Antonio-Tirri/Aspirnove/Display BW S-0241-02/Display Sorgenti Software BW S-0241-02 FW00054_012/FW00054_012/doc/info_display.docx

% H2O

% Umidità Stato sterilizzatore (ON/OFF)

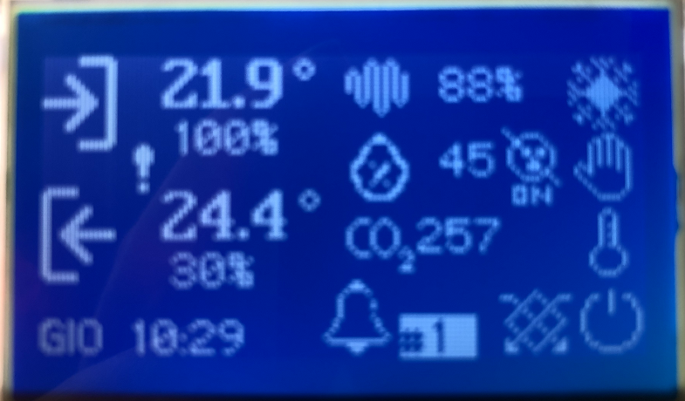
[picture p1: figure]

Temperatura EXT Stagione

% Comando FAN1

! se sensori tacho non rilevati Modalità (AUTO/MAN/PROG)

Temperatura INT Stato termostato

% Comando FAN2

Giorno / Ora OFF sistema

(oppure messaggio allarme)

Numero scheda Stato Bypass

Icona allarme attivo Valore CO2

(ingresso sanificazione o filtro aria)
