Antonio-Tirri/Aspirnove/Aspirnova Scheda Motori S-283-00/S-0283-01-BOM-Var.002 11012021.xlsx

Progetto: |  |  | Scheda controllo
Codice scheda: |  |  | S-0283-01
Variante: |  |  | 002
Revisione: |  |  | 01
Data report: |  |  | 29/10/2020 | 11/01/2021
# | Riferimento | Valore | Descrizione | Costruttore | P/N Costruttore | Contenitore | Quantità | Note
~~1~~ | ~~BT1~~ | ~~CR-1220/HFN~~ | ~~Battery Lithium 3V coin 12.5 mm~~ | ~~Panasonic~~ | ~~CR-1220/HFN~~ | ~~PTH~~ | ~~1~~ | ~~A-1081-00~~
 | BT1 |  | PORTABATTERIA VERTICALE 2032 GR000250 |  |  |  |  | A-1341-00
 | BT1 |  | BATTERIA 3V 2032 |  |  |  |  | A-1218-00
4 | C1, C2, C7, C8, C23, C24 | 12pF 50V | MLCC Capacitor, 12pF 50V, ±10%, C0G, Case 0603 | AVX Corp. | 06035A120KAT2A | 0603 | 6 | RECD95026
5 | C3, C4, C9, C10 | 10nF 50V | MLCC Capacitor, 10nF 50V, ±10%, X7R, Case 0805 | AVX Corp. | 08055C103KAT2A | 0805 | 4 | RECD92009
6 | C5, C14 | 100nF 275Vac | Condensatore a Film Plastico, 100nF, X2 | Kemet | R46KF310050P0K | PTH | 2 | A-1135-00
7 | C6, C11, C15 | 100nF 50V | MLCC Capacitor, 100nF 50V, ±10%, X7R, Case 0805 | AVX Corp. | 08055C104KAT2A | 0805 | 3 | RECD92013
8 | C12, C13 | 470uF 35V | SMD Aluminum Electrolytic Capacitor, 470uF 35V, 8mm x 10.2mm | Panasonic Electronic Components | EEEFK1V471SP | SMD 10mm x 10.2mm | 2 | a-0779-00
9 | C16, C32 | 1uF 50V | MLCC Capacitor, 1uF 50V, ±10%, X7R, Case 0805 | Murata | GRM21BR71H105K | 0805 | 2 | RECD92021
10 | C17, C30 | 1uF 50V | MLCC Capacitor, 1uF 50V, ±10%, X5R, Case 0603 | Samsung | CL10A105KB8NNNC | 0603 | 2 | RECD95033
11 | C18, C19 | 1nF 50V | MLCC Capacitor, 1nF 50V, ±10%, C0G, Case 0603 | Avx | 06035C102KAT2A | 0603 | 2 | RECD95011
12 | C20, C21, C22, C25, C26, C27, C35, C40, C50, C51 | 100nF 50V | MLCC Capacitor, 100nF 50V, ±10%, X7R, Case 0603 | Avx | 06035C104KAT2A | 0603 | 10 | RECD95018
13 | C28 | 4.7uF 16V | MLCC Capacitor, 4.7uF 16V, ±10%, X7R, Case 0805 | Avx | 0805YC475KAT2A | 0805 | 1 | RECD92023
14 | C29, C42 | 10nF 50V | MLCC Capacitor, 10nF 50V, ±10%, X7R, Case 0603 | Avx | 06035C103KAT2A | 0603 | 2 | RECD95012
15 | C33, C41 | 10uF 25V | MLCC Capacitor, 10uF 25V, ±10%, X7R, Case 1206 | Avx | 12063C106KAT2A | 1206 | 2 | RECD93014
16 | C34 | 150pF 50V | MLCC Capacitor, 150pF 50V, ±10%, C0G, Case 0603 | Avx | 06035A151JAT2A | 0603 | 1 | RECD95009
17 | C36, C38, C45, C47, C53, C60, C64, C68, C72, C77, C78, C79, C80, C81, C82 | 10nF 50V | MLCC Capacitor, 10nF 50V, ±10%, X7R, Case 0603 | Avx | 06035C103KAT2A | 0603 | 15 | RECD95012
18 | C37, C44, C46, C52, C54, C55, C58, C59, C62, C63, C66, C67, C70, C71 | 1uF 50V | MLCC Capacitor, 1uF 50V, ±10%, X5R, Case 0603 | Samsung | CL10A105KB8NNNC | 0603 | 14 | RECD95033
19 | C39 | 100uF TANT 20V | Solid Tantalum Chip Capacitor, 100uF, 20V, TC7343 | Avx | TAJD107K020RNJ | TC7343 | 1 | RECD82016
20 | C43 | 100pF 50V | MLCC Capacitor, 100pF 50V, ±10%, C0G, Case 0603 | Samsung | CL10C101JB8NNNC | 0603 | 1 | RECD95008
21 | C48, C49 | 2.2uF 25V | MLCC Capacitor, 2.2uF 25V, ±10%, X5R, Case 0603 | Samsung | CL10A225KA8NNNC | 0603 | 2 | RECD95023
22 | C56, C73, C74, C75, C76 | 100nF 50V | MLCC Capacitor, 100nF 50V, ±10%, X7R, Case 0603 | Avx | 06035C104KAT2A | 0603 | 5 | RECD95018
23 | C57, C61, C65, C69 | 100pF 50V | MLCC Capacitor, 100pF 50V, ±10%, C0G, Case 0603 | Samsung | CL10C101JB8NNNC | 0603 | 4 | RECD95008
24 | D1 | DF04S | Rectifier Bridge, 400V, 1A, SMD, 1V, SOIC | Vishay | DF04S | SMD | 1 | REDD90010
25 | D3, D5, D6, D7, D8 | BAV199 | Two Small Signal Diodes, 75V, SOT-23 | Infineon | BAV199E6327 | SOT-23 | 5 | REDD92019
26 | D4 | STPS340U | Power Schottky Rectifier, 40V, 3A | Stmicroelectronics | STPS340U | SMB | 1 | REDD96005
27 | D9, D10, D11, D12, D13, D14, D15, D17, D18 | 1N4148 | Small Signal Diode, 100V, 150mA, SOD-123 | Diodes Inc. | 1N4148W-7-F | SOD123 | 9 | REDD91035
28 | D16 | S2M | Rectifier Diode, 1KV, 1.5A, SMB | DC Components | S2M | SMB | 1 | REDD91002
29 | DL1, DL5, DL6, DL7, DL8, DL9, DL10, DL12, DL13, DL14 | LED ROSSO | Red SMD LED | Kingbright | KP-2012SRC-J4 | 0805 | 10 | REDD94009
30 | DL2, DL3, DL4 | LED VERDE | Green SMD LED | Kingbright | KP-2012SGC | 0805 | 3 | REDD94007
31 | F1 | 5x20 | 5x20 Fuse Holder | ECC | PTF/78 | PTH | 1 | A-0396-00
 |  |  |  |  |  |  | 1 | A-0396-00cc
 |  |  | 400ma 5x20 |  |  |  | 1 | A-0146-00
34 | F2, F3 | 72V, 0.20A | PTC Resettable Fuse, 72V, 0.20A | Little Fuse Inc. | 72R020X | Radial, 7.4mm | 2 | A-1138-00
35 | F4,F5 | 5x20 | 5x20 Fuse Holder vertical | SHURTER | FPG4 | PTH | 2 | A-1136-00
 |  |  | 10 5Ax20 |  |  |  | 1 | A1137-00
37 | J4 | STRIP2.54-1X5-H11.6-M | 5-Way Pin Strip, Single Row, 2.54mm pitch, Male | Adimpex | LE022005-R | PTH | 1 | A-1133-00
 | J8 |  | PONTE FILO RIGIDO PIN 2 – 3 |  |  |  | 1 | A-0152-00
39 | J5 | 651005136421 | Mini-USB connector, Type B , Vertical, PTH | Wurth | 651005136421 | PTH | 1 | A-1139-00
40 | JP1 | JMP2 | 2-way Jumper | Adimpex | LE008002-R | PTH | 1 | A-1140-00
41 | K1, K2, K3, K5, K6 | HF115FK/12-Z3T | Single-Pole Dual-Throw Relay, 12VDC, 16A, 250V | Hong Fa | HF115FK/12-Z3T | PTH | 5 | A-0248-00
42 | L2 | HZ0805C202R-10 | Ferrite chip beads Z=2k | Laird Technologies | HZ0805C202R-10 | 0805 | 1 | REIN93028
43 | L4 | 15uH | Power Inductor for Switching Regulator, 2.5A | Epcos | B82464A4153K | SMD 10x10mm | 1 | REIN95002
44 | P2, P3, P10, P11 | CUM5/3 | Stelvio Male PCB Header, 3ways, 5mm pitch | Stelvio | CUM5/3 | PTH | 4 | A-0667-00
 |  |  |  |  |  |  | 4 | A-0666-00
46 | P4, P5, P6, P7, P8, P9, P12, P13, P14, P16 | CUM5/4 | Stelvio Male PCB Header, 4ways, 5mm pitch | Stelvio | CUM5/4 |  | 10 | A-0049-00
 |  |  |  |  |  |  | 10 | A-0048-00
48 | Q1, Q2, Q3, Q5, Q6 | PDTC143ET,215 | NPN Biased transistor, R=4.7K | Nxp | PDTC143ET,215 | SOT-23 | 5 | RETR92026
49 | R1, R3, R4, R27 | 330 1% | SMD Resistor, 330 Ohm, Tolerance 1%, Case 0603 | Yageo | RC0603FR-07330RL | 0603 | 4 | RERS95511
50 | R5 | 1K 0.5W | Resistenza 1K Ohm, 5%, 0.5W, Assiale |  |  | PTH | 1 | A-1141-00
51 | R6 | 470 1% | SMD Resistor, 470 Ohm, Tolerance 1%, Case 0805 | Vishay | CRCW0805470RFKTABC | 0805 | 1 | RERS93116
52 | R7, R16, R25, R69, R88, ~~R89,~~ R81 | 0 | SMD Resistor, 0R, Case 0603 | Vishay | CRCW06030000Z0TABC | 0603 | 6 | RERS95000
53 | R8 | 4.7 1% | SMD Resistor, 4.7 Ohm, Tolerance 1%, Case 0805 | Vishay | CRCW08054R70FKTABC | 0805 | 1 | RERS93110
54 | R9, R11, R13, R58, R59, R64, R65, R75 | 10K 1% | SMD Resistor, 10K, Tolerance 1%, Case 0603 | Vishay | CRCW060310K0FKTABC | 0603 | 8 | RERS95570
55 | R10, R12, R14 | 3.9K 1% | SMD Resistor, 3.9K, Tolerance 1%, Case 0603 | Vishay | CRCW06033K90FKTABC | 0603 | 3 | RERS95532
56 | R15 | 120 1% | SMD Resistor, 120 Ohm, Tolerance 1%, Case 1206 | Vishay | CRCW1206120RFKTABC | 1206 | 1 | RERS91057
57 | R17, R20 | 4.7 1% | SMD Resistor, 4.7 Ohm, Tolerance 1%, Case 0805 | Vishay | CRCW080544R70FKTABC | 0805 | 2 | RERS93110
58 | R18, R21 | 4.7K 1% | SMD Resistor, 4.7K, Tolerance 1%, Case 0805 | Vishay | CRCW08054K70FKTABC | 0805 | 2 | RERS93033
59 | R19, R22, R71 | 1K 1% | SMD Resistor, 1K, Tolerance 1%, Case 0603 | Vishay | CRCW06031K00FKTABC | 0603 | 3 | RERS95550
60 | R23, R39, R41 | 10K 1% | SMD Resistor, 10K, Tolerance 1%, Case 0603 | Vishay | CRCW060310K0FKTABC | 0603 | 3 | RERS95570
61 | R24, R51 | 10 1% | SMD Resistor, 10Ohm, Tolerance 1%, Case 0603 | Vishay | CRCW060310R0FKTABC | 0603 | 2 | RERS95500
62 | R26 | 1M 1% | SMD Resistor, 1M, Tolerance 1%, Case 0805 | Vishay | CRCW08051M00FKTA | 0805 | 1 | RERS93050
63 | R28 | 220 1% | SMD Resistor, 220 Ohm, Tolerance 1%, Case 0603 | Vishay | CRCW0603220RFKTABC | 0603 | 1 | RERS95009
64 | R29, R37, R45, R50 | 12K 1% | SMD Resistor, 12K, Tolerance 1%, Case 0603 | Vishay | CRCW060312K0FKTABC | 0603 | 4 | RERS95572
65 | R30, R38, R46, R52 | 27K 1% | SMD Resistor, 27K, Tolerance 1%, Case 0603 | Vishay | CRCW060327K0FKTABC | 0603 | 4 | RERS95580
66 | R34, R35, R36, R42, R43, R44, R47, R48, R49, R53, R54, R55, R66, R67, R68, R70, R87 | 4.7K 1% | SMD Resistor, 4.7K, Tolerance 1%, Case 0603 | Vishay | CRCW06034K70FKTABC | 0603 | 17 | RERS95560
67 | R40 | 1.1K 1% | SMD Resistor, 1.1K, Tolerance 1%, Case 0603 | Vishay | CRCW06031K10FKTABC | 0603 | 1 | RERS95611
68 | R56, R57, R85, R86 | 560 1% | SMD Resistor, 560 Ohm, Tolerance 1%, Case 0603 | Vishay | CRCW0603560RFKTA | 0603 | 4 | RERS95612
69 | R72, R73 | 1K 1% | SMD Resistor, 1K, Tolerance 1%, Case 0603 | Vishay | CRCW06031K00FKTABC | 0603 | 2 | RERS95550
70 | R77, R78 | 1.5K 1% | SMD Resistor, 1.5K, Tolerance 1%, Case 0805 | Vishay | CRCW08051K50FKTABC | 0805 | 2 | RERS93108
71 | R82 | 0 | SMD Resistor, 0R, Case 1206 | Vishay | CRCW12060000Z0TABC | 1206 | 1 | RERS91000
72 | R83, R84, R93, R94, R95, R99 | 47K 1% | SMD Resistor, 47K, Tolerance 1%, Case 0603 | Vishay | CRCW060347K0FKTABC | 0603 | 6 | RERS95590
73 | R90, R91, R96, R97 | 100 1% | SMD Resistor, 100 Ohm, Tolerance 1%, Case 0603 | Vishay | CRCW0603100RFKTABC | 0603 | 4 | RERS95510
74 | SW1 | GDH08S04 | Dip-Switch, SMD, 8 way p1.27 | TE Connectivity | GDH08S04 | SMD | 1 | REDS20009
75 | SW2 | GDH02S04 | DIP Switch, 2 Position, SPST, 1.27mm pitch | TE Connectivity | GDH02S04 | SMD | 1 | REDS20002
76 | TR1 | 15V 6VA | Voltage Transformer | HAHN | TBD |  | 1 | A-1331-00 | myrra 44268
77 | TVS1, TVS2, TVS3, TVS4, TVS5, TVS6, TVS7, TVS8, TVS9, TVS12, TVS13, TVS14, TVS15, TVS16, TVS17 | PTVS13VP1UTP | 600W Unidirectional Transient Voltage Suppressor (TVS), SOD128, 13V | NXP | PTVS13VP1UTP | SOD128 | 15 | REDD91042
78 | TVS10 | CDSOT23-SM712 | Dual 7V/12V Transient Voltage Suppressor | Bourns | CDSOT23-SM712 | SOT23 | 1 | REDD90022
79 | TVS11 | SM6T30CA | Bidirectional Transil, 600W, 27V, SMB | ST Microelectronics | SM6T30CA | SMB | 1 | REDD91062
80 | U2 | LM1117IDTX-ADJ/NOPB | 800mA Low-Dropout Linear Regulator | Texas Instruments | LM1117IDTX-ADJ/NOPB | DPAK | 1 | REIC99171
81 | U3 | TS922ID | Dual Op Amp, Low offset | STMicroelectronics | TS922ID | SOIC-8 | 1 | REIC99201
82 | U4 | LM224DTBR2G | Quad Rail-to-Rail Op Amp | Texas Instruments | LM224DTBR2G | TSSOP14 | 1 | REIC92101
83 | U5, U7, U8, U10 | 10 1% | SMD Resistor, 10 Ohm, Tolerance 1%, Case 0805 | Vishay | CRCW080510R0FKTABC | 0805 | 4 | RERS93000
84 | U6 | USBLC6-2SC6 | ESD Protection Array, USB2.0 | Stmicroelectronics | USBLC6-2SC6 | SOT23-6 | 1 | REDD92023
85 | U9 | L5973D013TR | Step down switching regulator, 2.5A | ST Microelectronics | L5973AD | HSOP8 | 1 | REIC92102
86 | U11 | STM32F205RCT6 | ARM Cortex M3 , 256K Flash 96K Ram, LQFP 64pin | ST Microelectronics | STM32F205RCT6 | LQFP64 | 1 | REIC99172
87 | U14 | SN65HVD75D | Low Power RS485 Transceiver, Half Duplex, 3-3,6V, 20Mbps | Texas Instruments | SN65HVD75D | SOIC8 | 1 | REIC93185
88 | VR1, VR2, VR3 | S14K275E | Varistor, 275Vac, 14mm | Epcos | S14K275E | PTH | 3 | A-0096-00
89 | Y1 | 12MHz | SMD Quartz Crystal 12MHz, 50ppm | Abracon | ABLS-12.000MHZ-B4-T | HC49 | 1 | REQZ93023
90 | Y2 | 32.768kHz | Quartz, 32.768kHz | Abracon Corporation | AB38T-32.768KHZ | TC-26 | 1 | A-1143-00
Totale |  |  |  |  |  |  | 284
