Antonio-Tirri/Aspirnove/Display BW S-0241-02/DIBA/S-0241-02_BOM.xlsx

Progetto: |  |  | Scheda Display
Codice scheda: |  |  | S-0241-02
Variante: |  |  | 002
Revisione: |  |  | 02
Data report: |  |  | 13/11/2020 | Agg.: | 10/11/2021 | 15/12/2021
# | Riferimento | Valore | Descrizione | Costruttore | P/N Costruttore | Contenitore | Quantità | Note
# | Designator | Value | Description | Manufacturer | Manufacturer Part Number | Package | Quantity | AssemblyNotes
1 |  |  |  |  |  |  | 1 | ELC-0241-05
2 | BZ1 | LPT1230S-HL-03-4.0-1 | Piezo Buzzer | Cre-sound | LPT1230S-HL-03-4.0-1 | SMD | 1 | REBZ90003
3 | C1, C2, C41 | 10uF 25V | MLCC Capacitor, 10uF 25V, ±10%, X7R, Case 1206 | Avx | 12063C106KAT2A | 1206 | 3 | RECD93014
4 | C3, C4 | 47uF 25V | SMD Aluminum Electrolytic Capacitor, 47uF 25V, 6.3mm x 5.8mm | Panasonic | EEEFK1E470P | SMD 6.3mm x 5.8mm | 2 | RECD81000
5 | C5, C9, C11, C13, C15, C16, C30, C31, C32, C33 C20, C21, C22, C25, C26, C27, C40, C50, C51 | 100nF 50V | Multilayer Ceramic Capacitor | Panasonic / TDK / Kemet | ECJ1VB1H104 | 0603 | 19 | RECD95018
6 | C6, C10, C12, C14, C29 C17_1, C17_2 | 1uF 50V | Multilayer Ceramic Chip Capacitor, 1uF 50V, 0603, X7R, 10% | Panasonic / TDK / Kemet | CGA3E2X7R1H102K080AD | 0603 | 7 | RECD95033
7 | C7, C8, C23, C24 | 12pF 50V | MLCC Capacitor, 12pF 50V, ±10%, C0G, Case 0603 | AVX Corp. | 06035A120KAT2A | 0603 | 4 | RECD95026
8 | C18_1, C18_2, C19_1, C19_2 | 1nF 50V | MLCC Capacitor, 1nF 50V, ±10%, C0G, Case 0603 | Avx | 06035C102KAT2A | 0603 | 4 | RECD95011
9 | C28 | 4.7uF 16V | MLCC Capacitor, 4.7uF 16V, ±10%, X7R, Case 0805 | Avx | 0805YC475KAT2A | 0805 | 1 | RECD92028
10 | C48, C49 | 2.2uF 25V | MLCC Capacitor, 2.2uF 25V, ±10%, X5R, Case 0603 | Samsung | CL10A225KA8NNNC | 0603 | 2 | RECD95023
11 | D1 | S2M | Rectifier Diode, 1KV, 1.5A, SMB | DC Components | S2M | SMB | 1 | REDD91002
12 | D3 | 1N4148 | Small Signal Diode, 100V, 150mA, SOD-123 | Diodes Inc. | 1N4148W-7-F | SOD123 | 1 | REDD91035
13 | DISP1 | G64128W20NBW00 | LCD Graphic Display, 128x64, Blue | CCT | G64128W20NBW00 | MECH | 1 | ELC-0241-05
14 | DL1 | BILED 3mm | BICOLOR LED 3mm common cathode | Kingbright | L-93WSURKCGKC | PTH | 1 | A-1132-00
15 | J1 |  | FFC/FPC Connector 29-way | Molex |  | SMD | 1 | RECN90024
16 | J4 | STRIP2.54-1X5-H11.6-M | 5-Way Pin Strip, Single Row, 2.54mm pitch, Male | Adimpex | LE022005-R | PTH | 1 | A-0559-00
17 | J5 | 65100516121 | Mini-USB connector, Type B , Vertical, PTH | Wurth | 65100516121 | SMD | 1 | RECN90017
18 | JP2 | 691221320006 | Morsettiera 6vie , passo 3.5mm, SMD | Wurth | 691221320006 | PTH | 1 | A-1308-00
19 | Q1, Q2 | BC817 | NPN Silicon Transistor, Small signals | NXP Semiconductors | BC817 | SOT-23 | 2 | RETR93010
20 | R1, R7, R16, R25, R31, R42, R43 | 0 | SMD Resistor, 0R, Case 0603 | Vishay | CRCW06030000Z0TABC | 0603 | 7 | RERS95000
21 | R18 | 1.5K 1% | SMD Resistor, 1.5K, Tolerance 1%, Case 0805 |  | CRCW08051K50FKTABC | 0805 | 1 | RERS93108
22 | R3 | 33 1% | SMD Resistor, 33 Ohm, Tolerance 1%, Case 1206 | Vishay | CRCW120633R0FKTA | 1206 | 1 | RERS91095
23 | R4, R5, R6, R8, R9, R75_1, R75_2, R10, R12,R23, R29 | 10K 1% | SMD Resistor, 10K, Tolerance 1%, Case 0603 | Vishay | CRCW060310K0FKTABC | 0603 | 12 | RERS95570
24 | R11, R27 | 22K 1% | SMD Resistor, 22K, Tolerance 1%, Case 0603 | Vishay | CRCW060322K0FKTABC | 0603 | 2 | RERS95576
25 | R13 | 470 1% | SMD Resistor, 470 Ohm, Tolerance 1%, Case 0805 | Vishay | CRCW0805470RFKTABC | 0805 | 1 | RERS93116
26 | R14 | 1.5K 1% | SMD Resistor, 1.5K, Tolerance 1%, Case 0805 | Vishay | CRCW08051K50FKTABC | 0805 | 1 | RERS93108
27 | R17_1, R17_2, R20_1, R20_2 | 4.7 1% | SMD Resistor, 4.7 Ohm, Tolerance 1%, Case 0805 | Vishay | CRCW080544R70FKTABC | 0805 | 4 | RERS93110
28 | R19, R21 | 100 1% | SMD Resistor, 100 Ohm, Tolerance 1%, Case 0603 | Vishay | CRCW0603100RFKTABC | 0603 | 2 | RERS95510
29 | R22 | 10 1% | SMD Resistor, 10 Ohm, Tolerance 1%, Case 0805 | Vishay | CRCW080510R0FKTABC | 0805 | 1 | RERS93000
30 | R24, R51 | 10 1% | SMD Resistor, 10Ohm, Tolerance 1%, Case 0603 | Vishay | CRCW060310R0FKTABC | 0603 | 2 | RERS95500
31 | R26 | 1M 1% | SMD Resistor, 1M, Tolerance 1%, Case 0805 | Vishay | CRCW08051M00FKTA | 0805 | 1 | RERS93050
32 | R36 | 1.8M 1% | RES. SMD 1,8M 0603 1% |  |  | 0603 | 1 | RERS95609
33 | R38 | 330K 1% | RES. SMD 330K 0603 1% |  |  | 0603 | 1 | RERS95610
34 | R28 | 220 1% | SMD Resistor, 220 Ohm, Tolerance 1%, Case 0603 | Vishay | CRCW0603220RFKTABC | 0603 | 1 | RERS95009
35 | R32, R33, R71_1, R71_2 ,R72_1, R72_2, R73_1, R73_2 | 1K 1% | SMD Resistor, 1K, Tolerance 1%, Case 0603 | Vishay | CRCW06031K00FKTABC | 0603 | 8 | RERS95550
36 | R39 | 2.2K 1% | SMD Resistor, 2.2K, Tolerance 1%, Case 1206 | Vishay | CRCW12062K20FKTABC | 1206 | 1 | RERS91112
37 | R40, R41 | 120 1% | SMD Resistor, 120 Ohm, Tolerance 1%, Case 1206 | Vishay | CRCW1206120RFKTABC | 1206 | 2 | RERS91057
38 | S1, S2, S3, S4, S5 | TVBM11 | Tactile switch, 3.5x6 | Bentex | TVBM11 | SMD | 5 | REPL92014
39 | SW2 | GDH02S04 | DIP Switch, 2 Position, SPST, 1.27mm pitch | TE Connectivity | GDH02S04 | SMD | 1 | REDS20002
40 | TVS1 | SM6T18CA | Bidirectional Transil, 600W, 18V, SMB | Stmicroelectronics | SM6T18CA | SMB | 1 | REDD91052
41 | TVS10_1, TVS10_2 | CDSOT23-SM712 | Dual 7V/12V Transient Voltage Suppressor | Bourns | CDSOT23-SM712 | SOT23 | 2 | REDD90022
42 | U1 U2 | LM1117IDTX-ADJ/NOPB | 800mA Low-Dropout Linear Regulator | Texas Instruments | LM1117IDTX-ADJ/NOPB | DPAK | 2 | REIC99171
44 | U6 | USBLC6-2SC6 | ESD Protection Array, USB2.0 | Stmicroelectronics | USBLC6-2SC6 | SOT23-6 | 1 | REDD92023
45 | U11 | STM32F205RCT6 | ARM Cortex M3 , 256K Flash 96K Ram, LQFP 64pin | ST Microelectronics | STM32F205RCT6 | LQFP64 | 1 | REIC99172
46 | U14_1, U14_2 | SN65HVD75D | Low Power RS485 Transceiver, Half Duplex, 3-3,6V, 20Mbps | Texas Instruments | SN65HVD75D | SOIC8 | 2 | REIC93185
47 | Y1 | 12MHz | SMD Quartz Crystal 12MHz, 50ppm | Abracon | ABLS-12.000MHZ-B4-T | HC49 | 1 | REQZ93023
 |  |  |  |  |  |  |  | ELSTAFFA
 |  |  |  |  |  |  |  | ELFRONTALE
 |  |  |  |  |  |  |  | ELVETRINO
 |  |  |  |  |  |  |  | ELFONDO
 |  |  |  |  |  |  |  | ELTASTIERA
 |  |  |  |  |  |  |  | ELDISPLAY64X128_29P
 |  |  |  |  |  |  |  | ELSCATOLA
