Antonio-Tirri/Aspirnove/Aspirnova Scheda Motori S-283-00/S-0283-01-SCH-Var.002.pdf

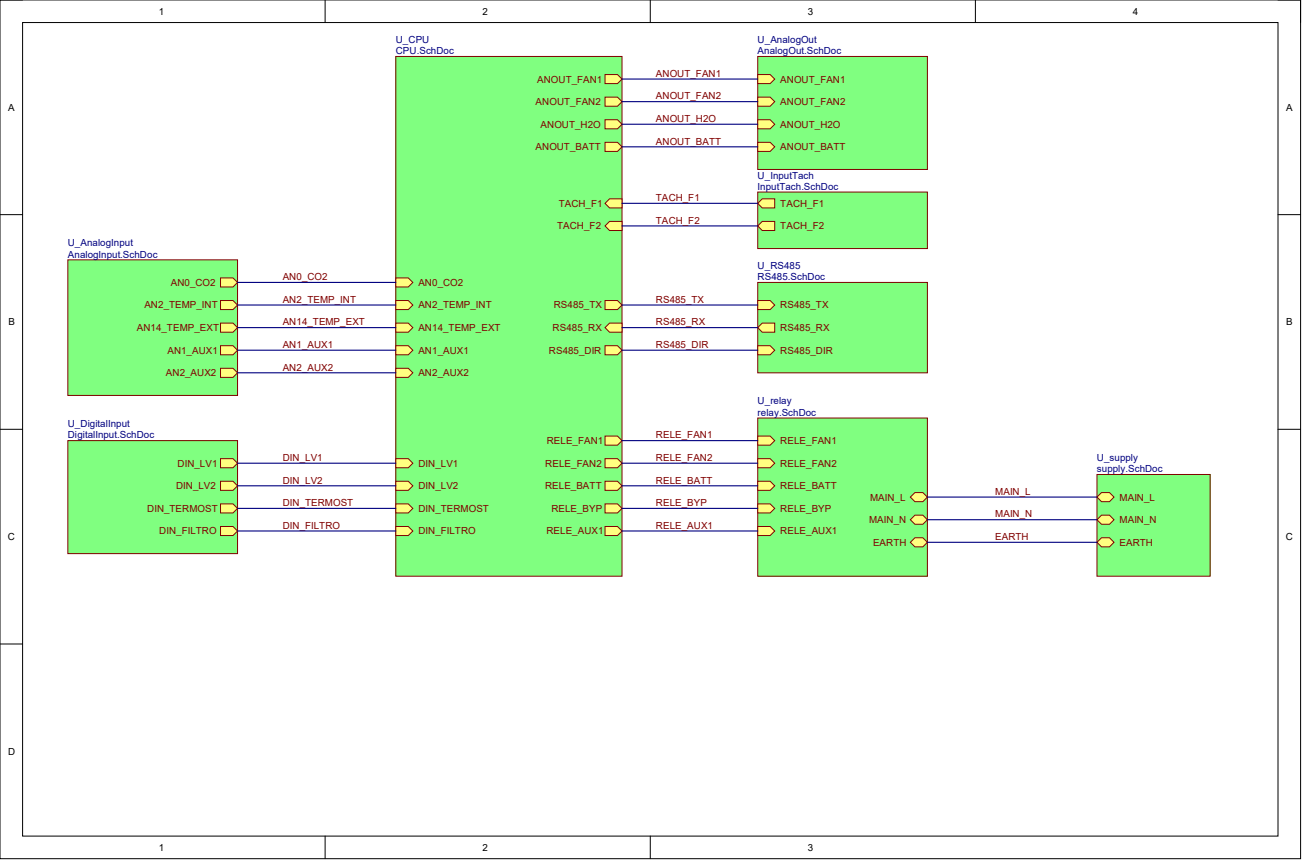
[picture p9: page 1]
MAIN_L; MAIN_N; EARTH; U_supply supply.SchDoc; ANOUT_FAN2; ANOUT_H2O; ANOUT_BATT; ANOUT_FAN1; U_AnalogOut AnalogOut.SchDoc; AN2_TEMP_INT; AN14_TEMP_EXT; DIN_TERMOST; DIN_FILTRO; RS485_DIR; RELE_BYP; RELE_BATT; RELE_FAN2; RELE_FAN1; AN1_AUX1; AN2_AUX2; RELE_AUX1; TACH_F1; TACH_F2; DIN_LV1; DIN_LV2; U_CPU CPU.SchDoc; U_RS485 RS485.SchDoc AN0_CO2; U_AnalogInput AnalogInput.SchDoc; U_DigitalInput DigitalInput.SchDoc; U_relay relay.SchDoc; U_InputTach InputTach.SchDoc

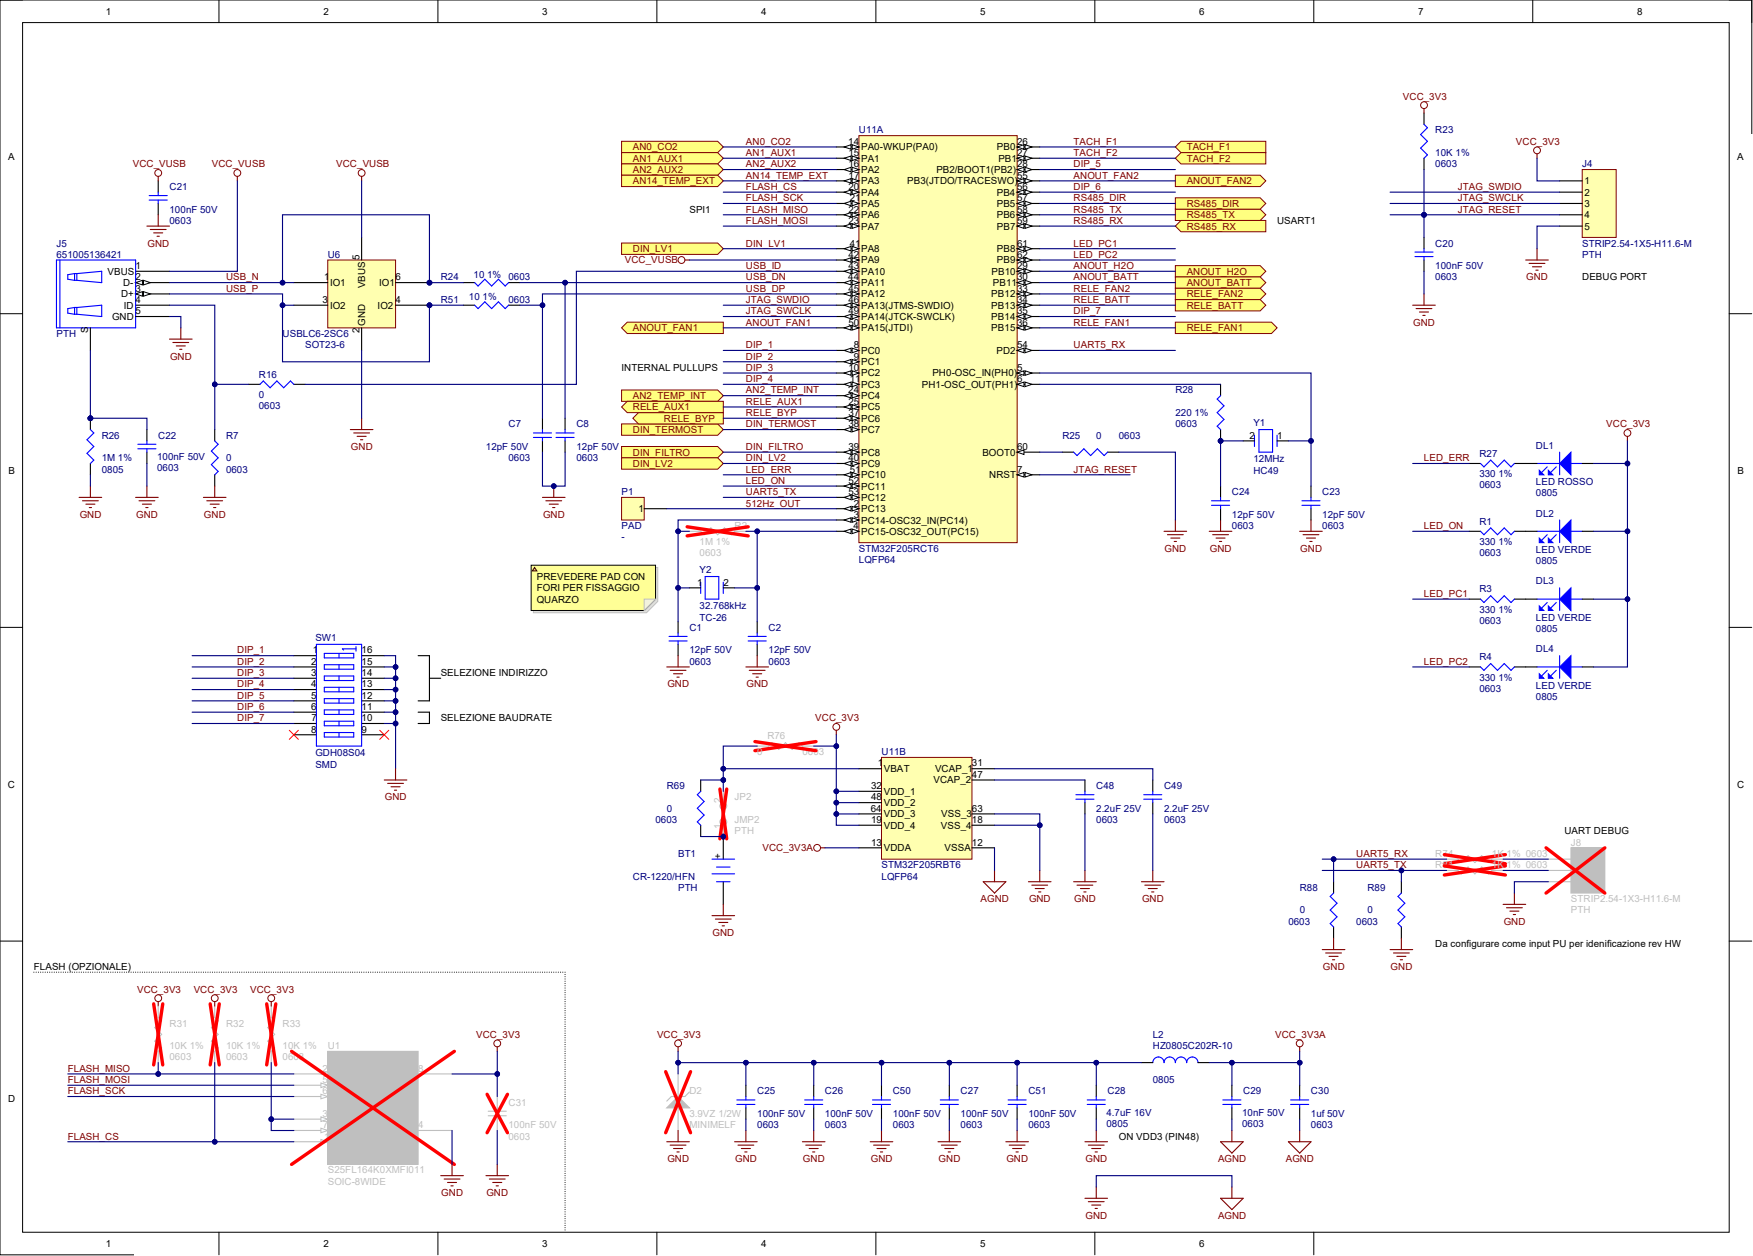
[picture p10: page 2]

Da configurare come input PU per idenificazione rev HW

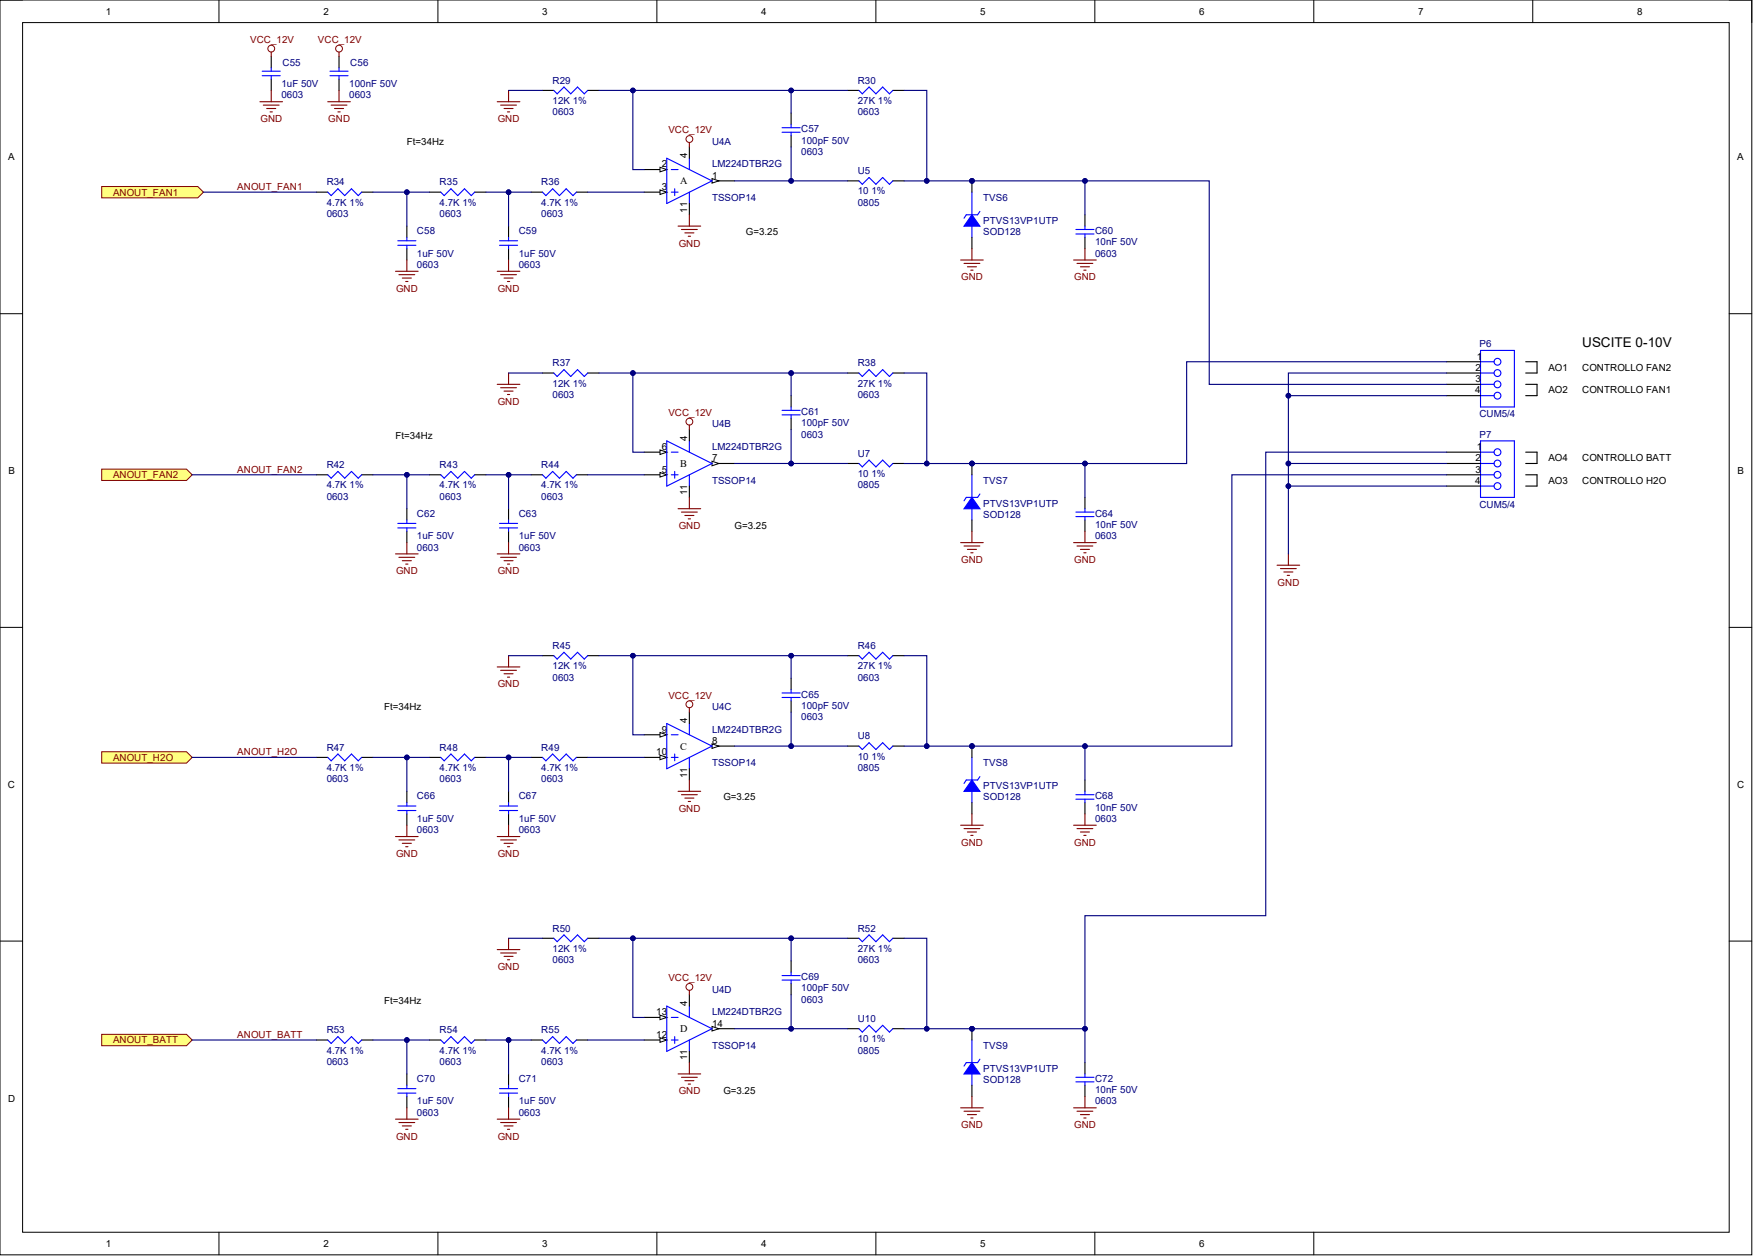
[picture p11: page 3]

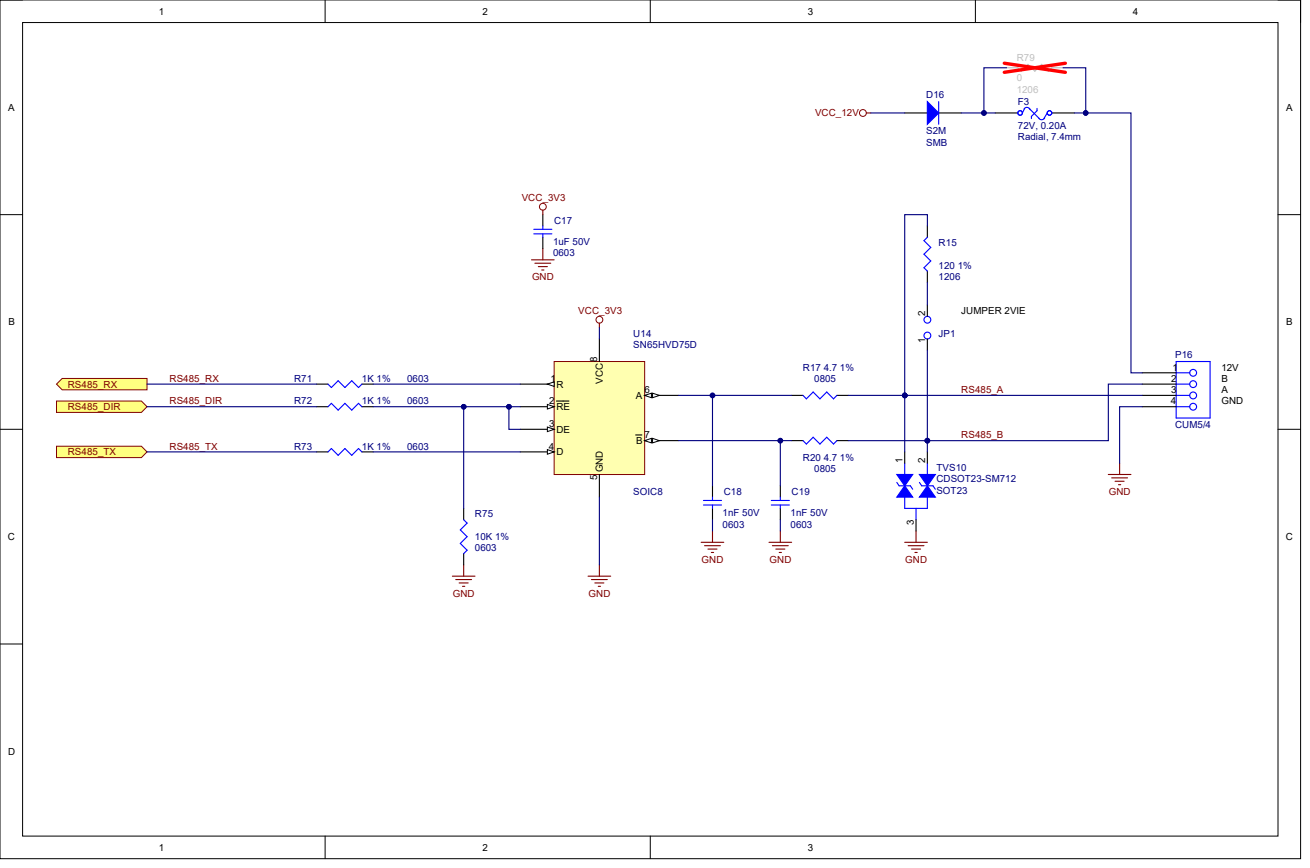
[picture p12: page 4]

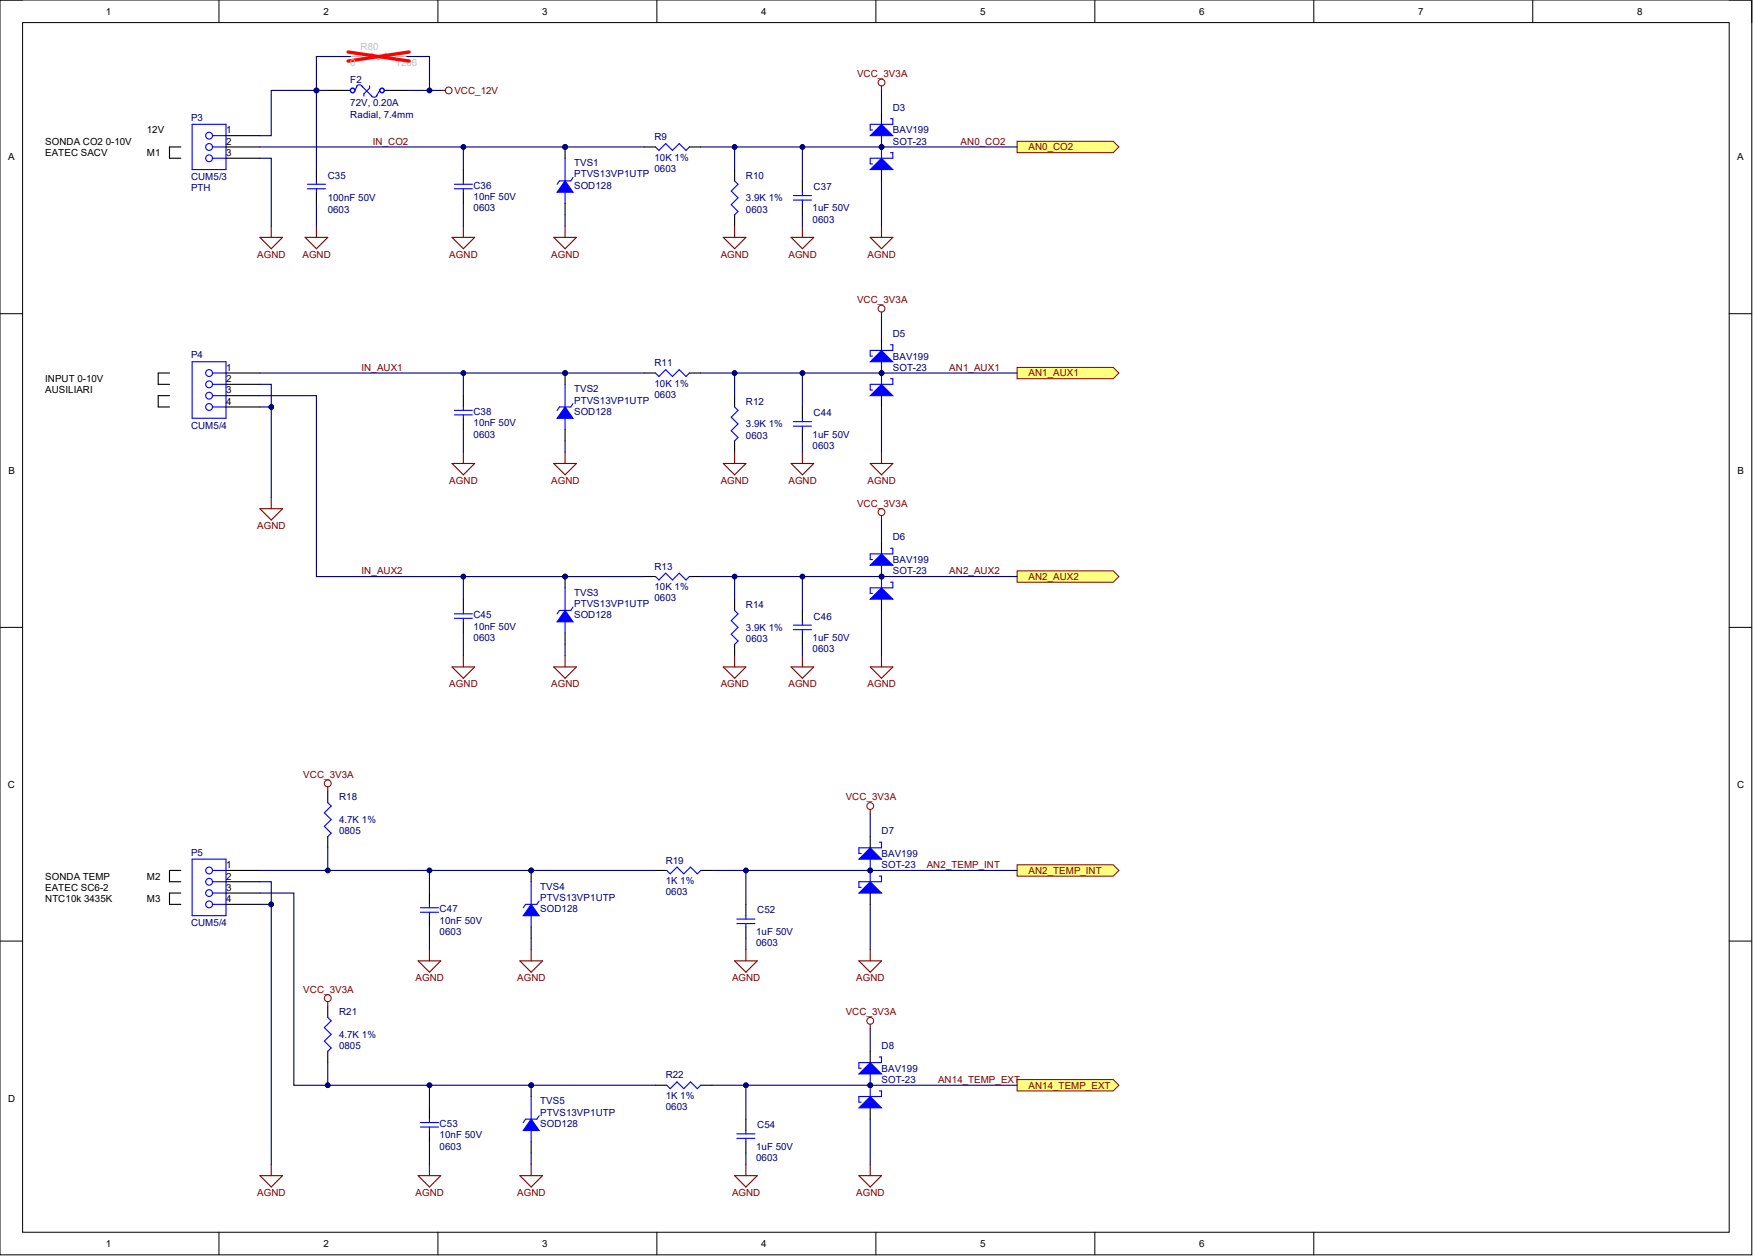
[picture p13: page 5]

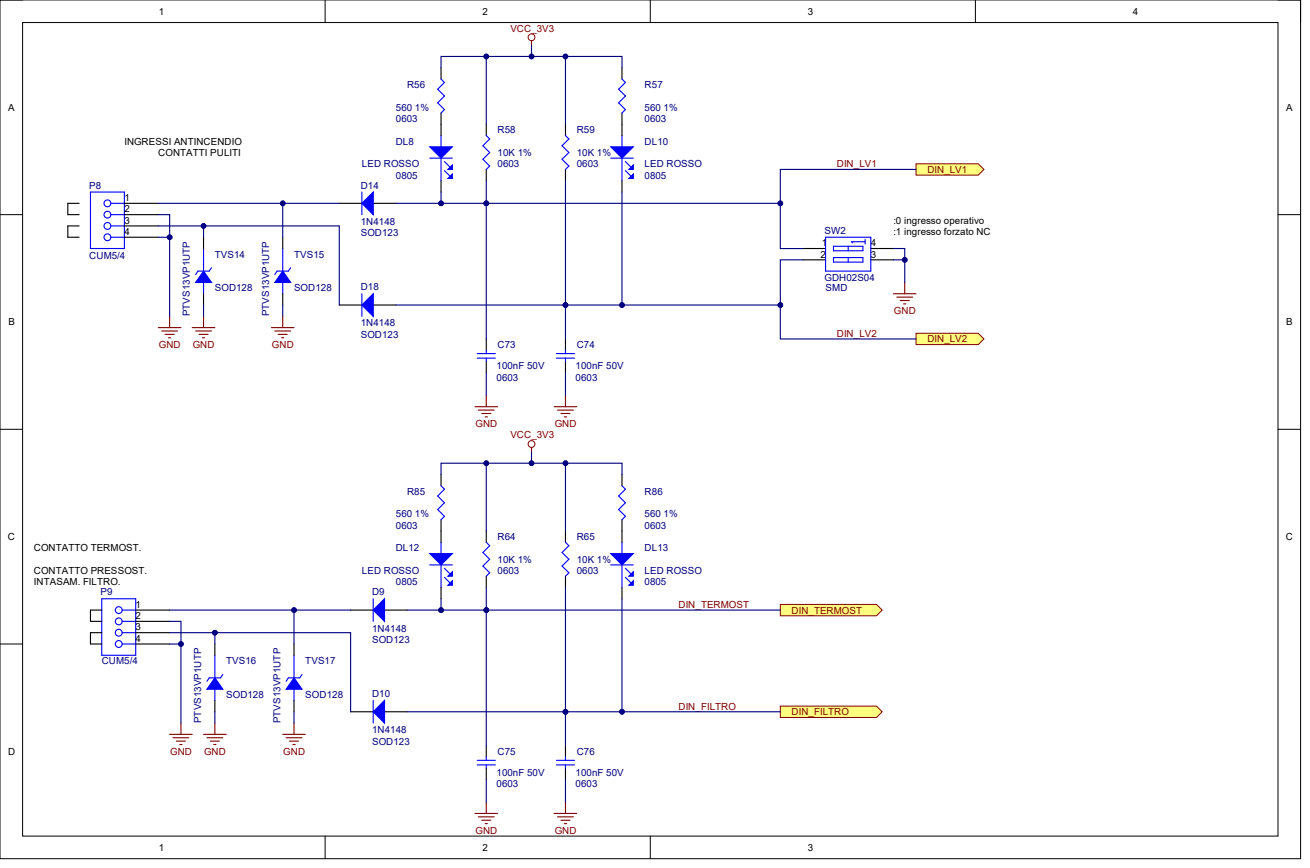
[picture p14: page 6]

## MOTORE FAN1 8A

# CUM5/3 123

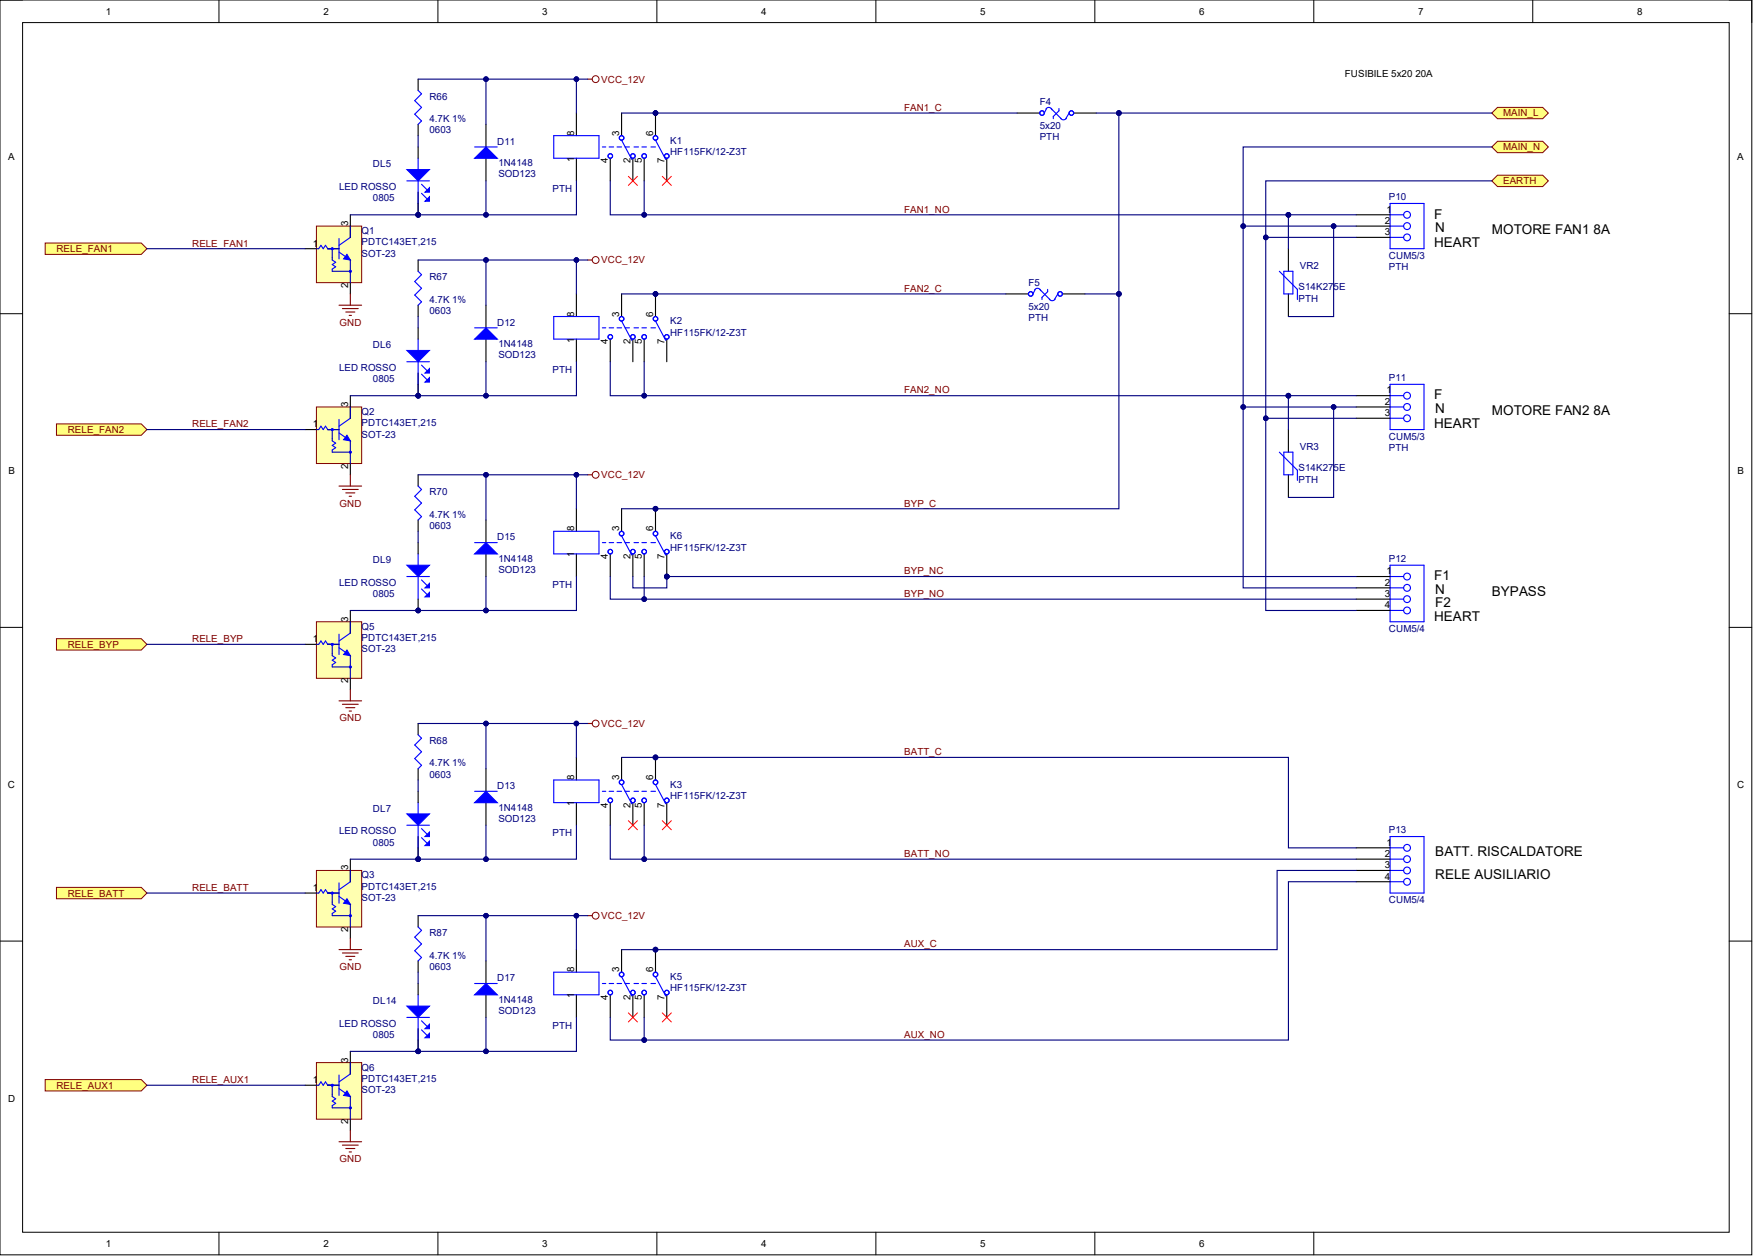
[picture p15: page 7]

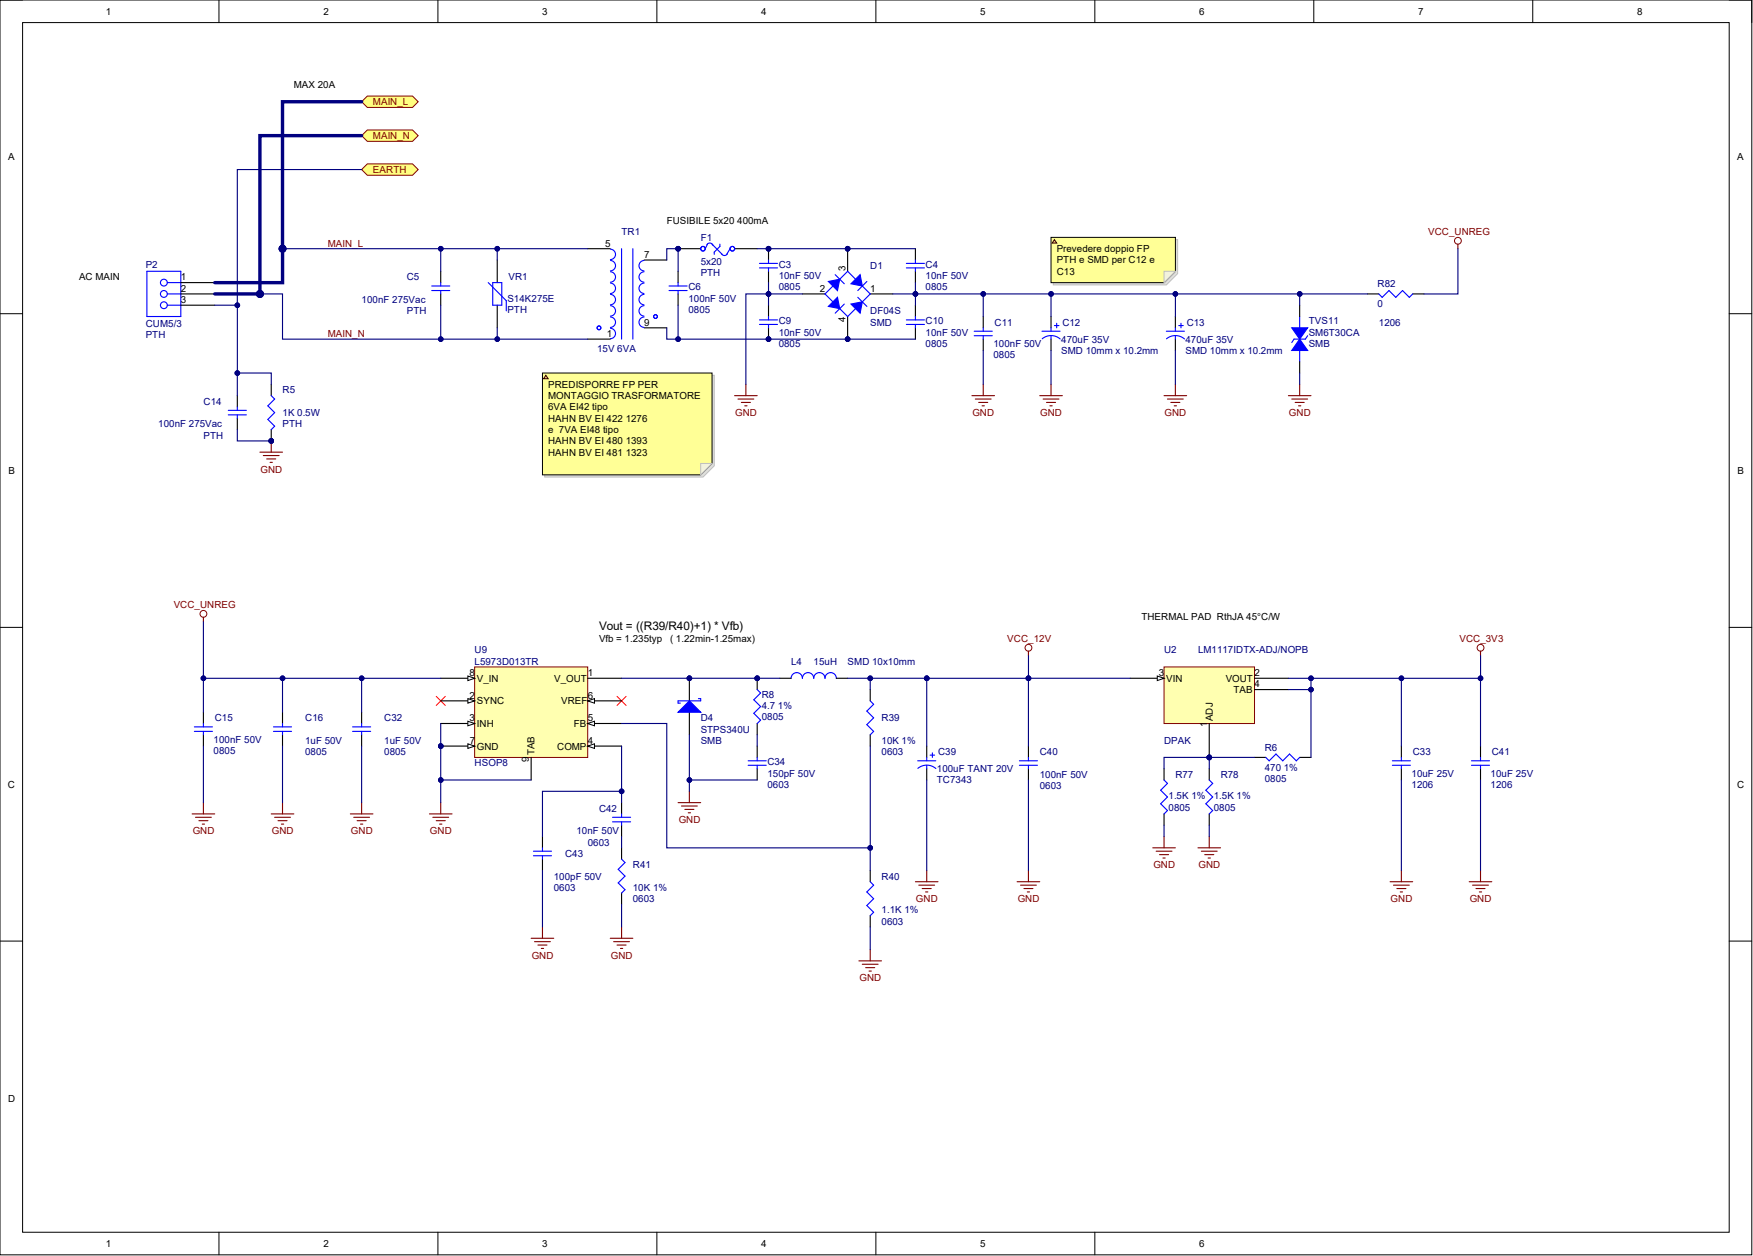
[picture p16: page 8]

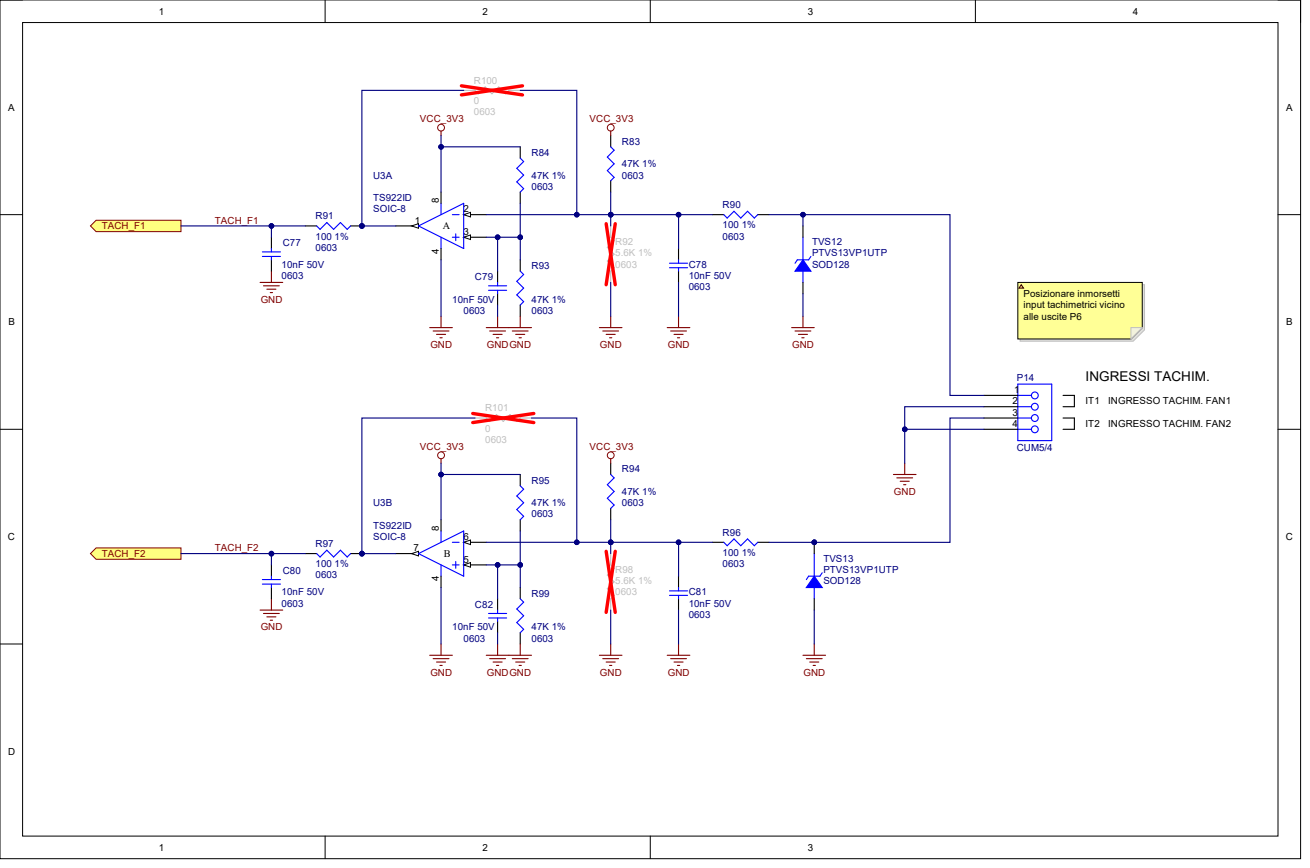
[picture p17: page 9]
