Antonio-Tirri/Aspirnove/Display BW S-0241-02/DISEGNI/C-0241-01_SCHEMA_ELETTRICO.pdf

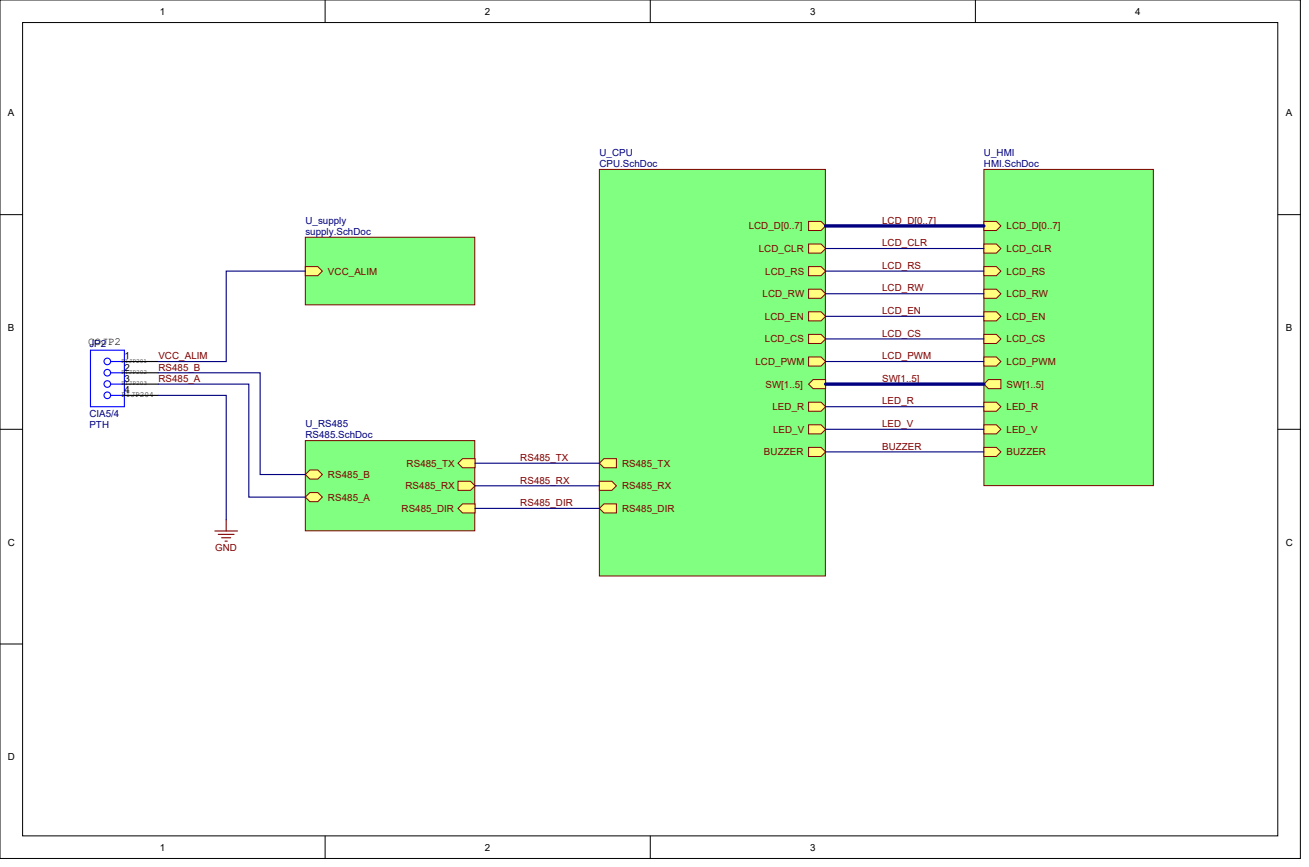
[picture p18: page 1]
VCC_ALIM; U_supply supply.SchDoc; RS485_DIR; LCD_RW; LCD_CLR; LCD_CS; LCD_RS; LCD_PWM; LCD_EN; LCD_D[0..7]; LED_R; LED_V; BUZZER; U_CPU CPU.SchDoc; U_RS485 RS485.SchDoc; U_HMI HMI.SchDoc; PTH; CIA5/4; GND; VCC_ALIM RS485_B RS485_A; PIJP201; PIJP202; PIJP203 PIJP204; COJP2

### POLCD0RW

### PORS4850DIR

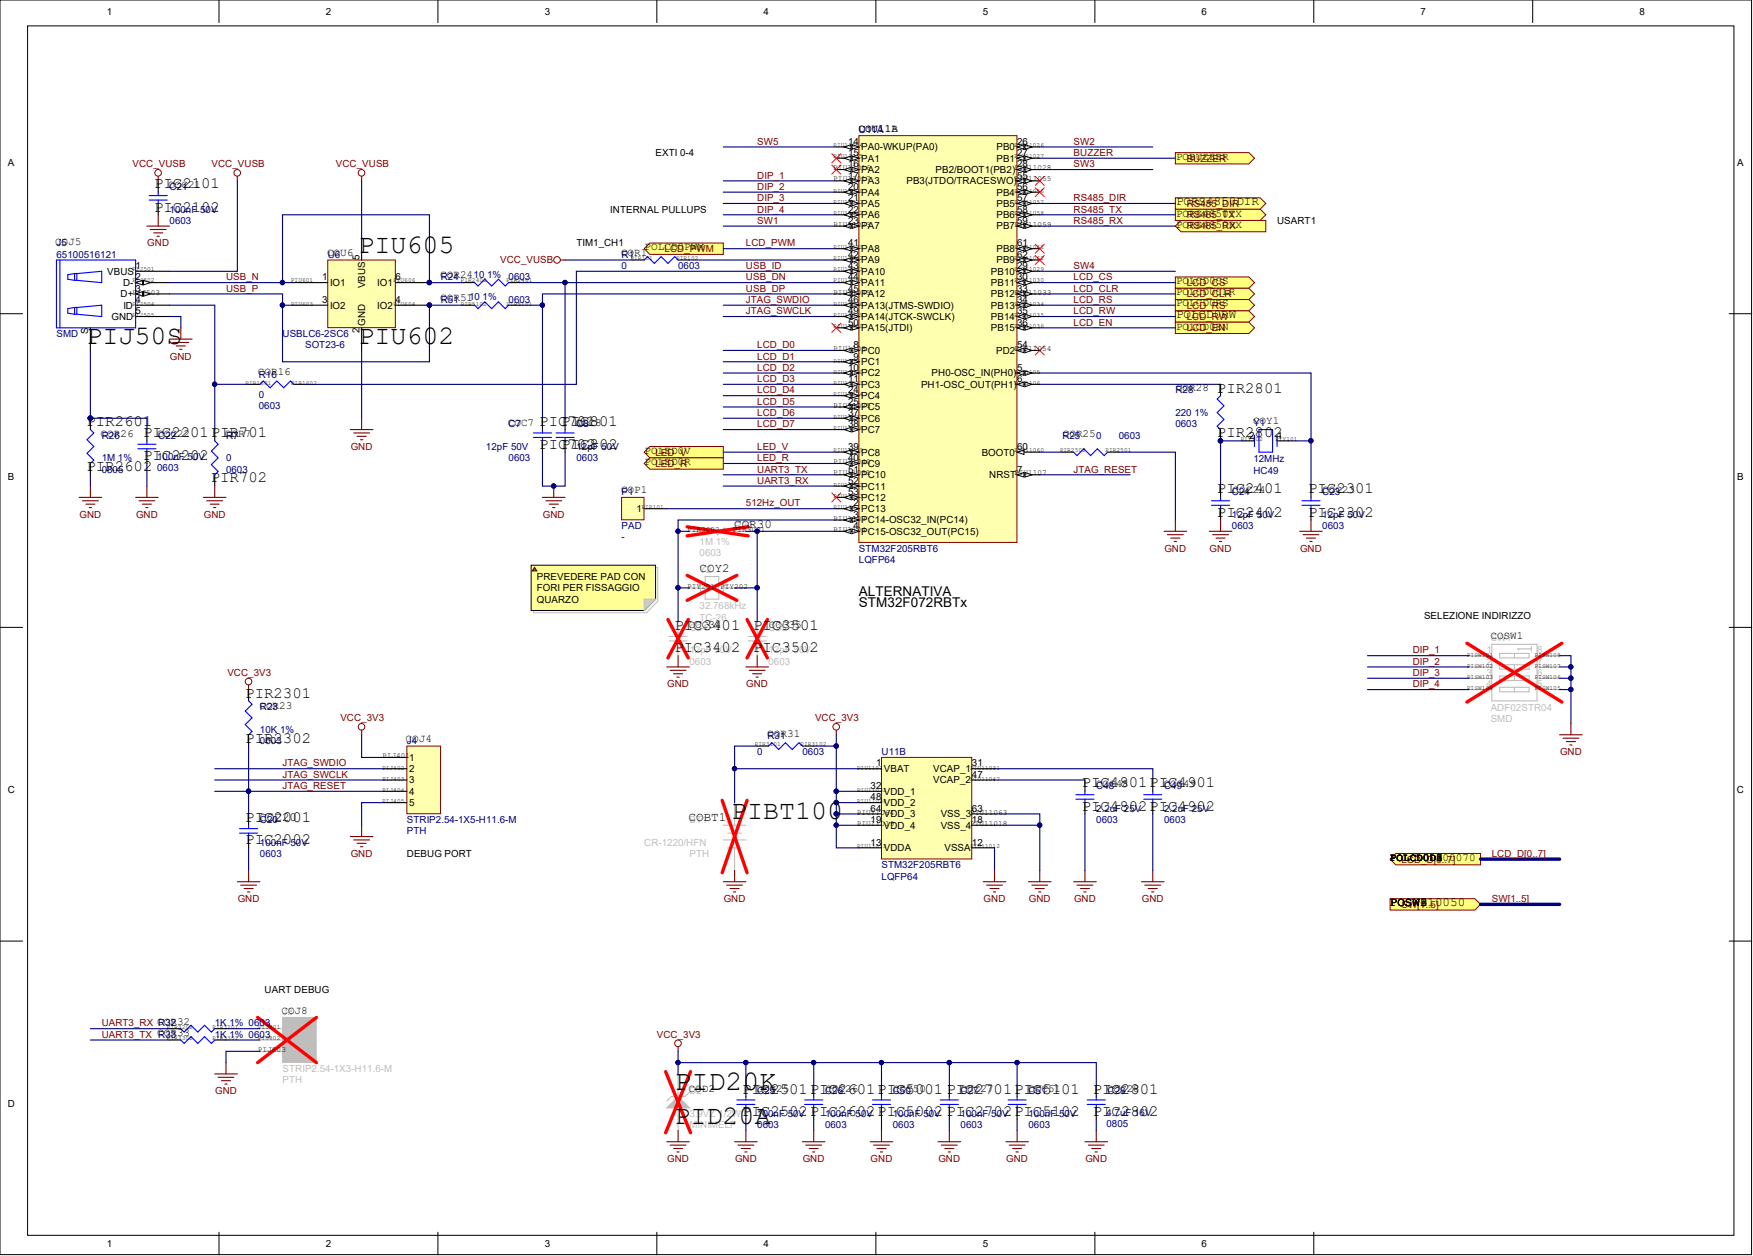
[picture p19: page 2]

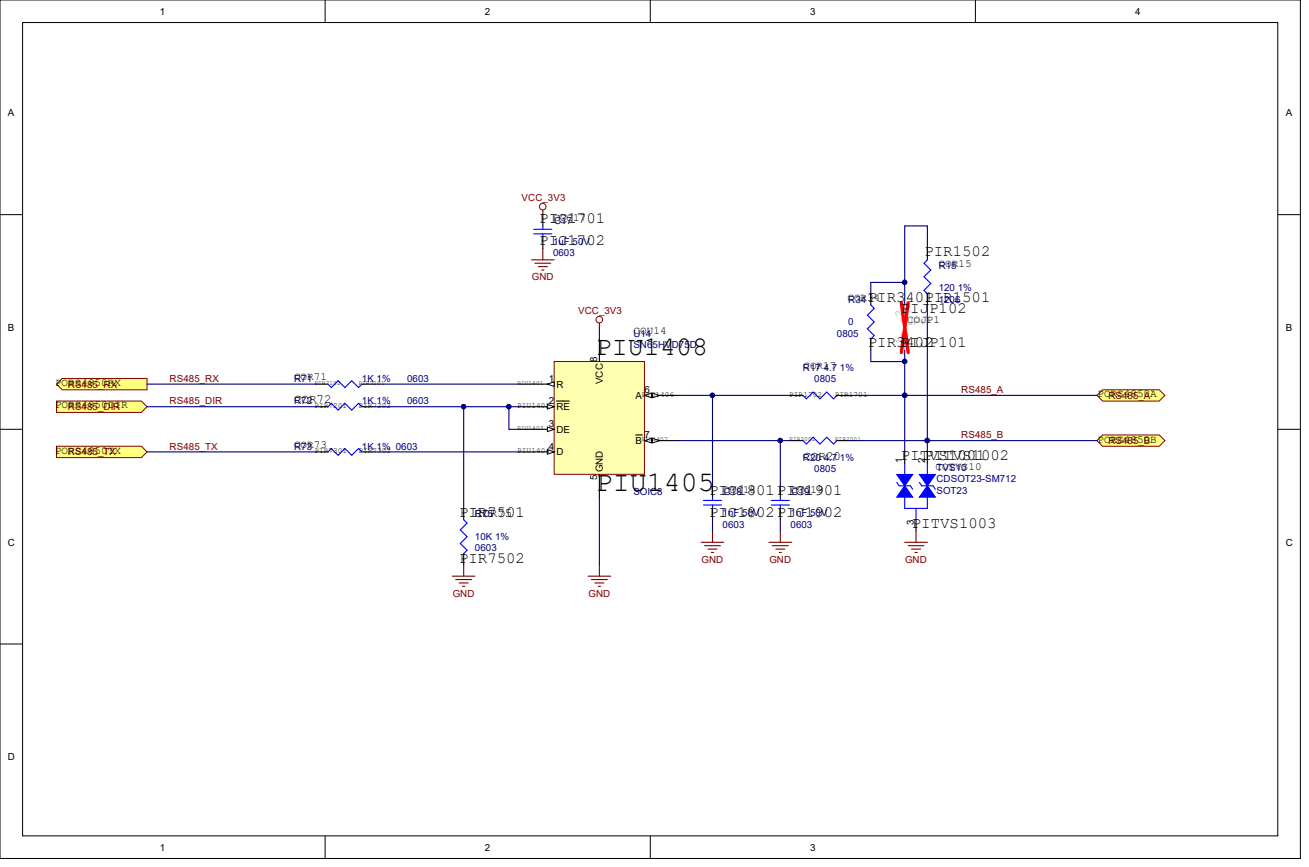
[picture p20: page 3]

## MONTAGGIO ALTERNATIVO

### POLCD0CLR

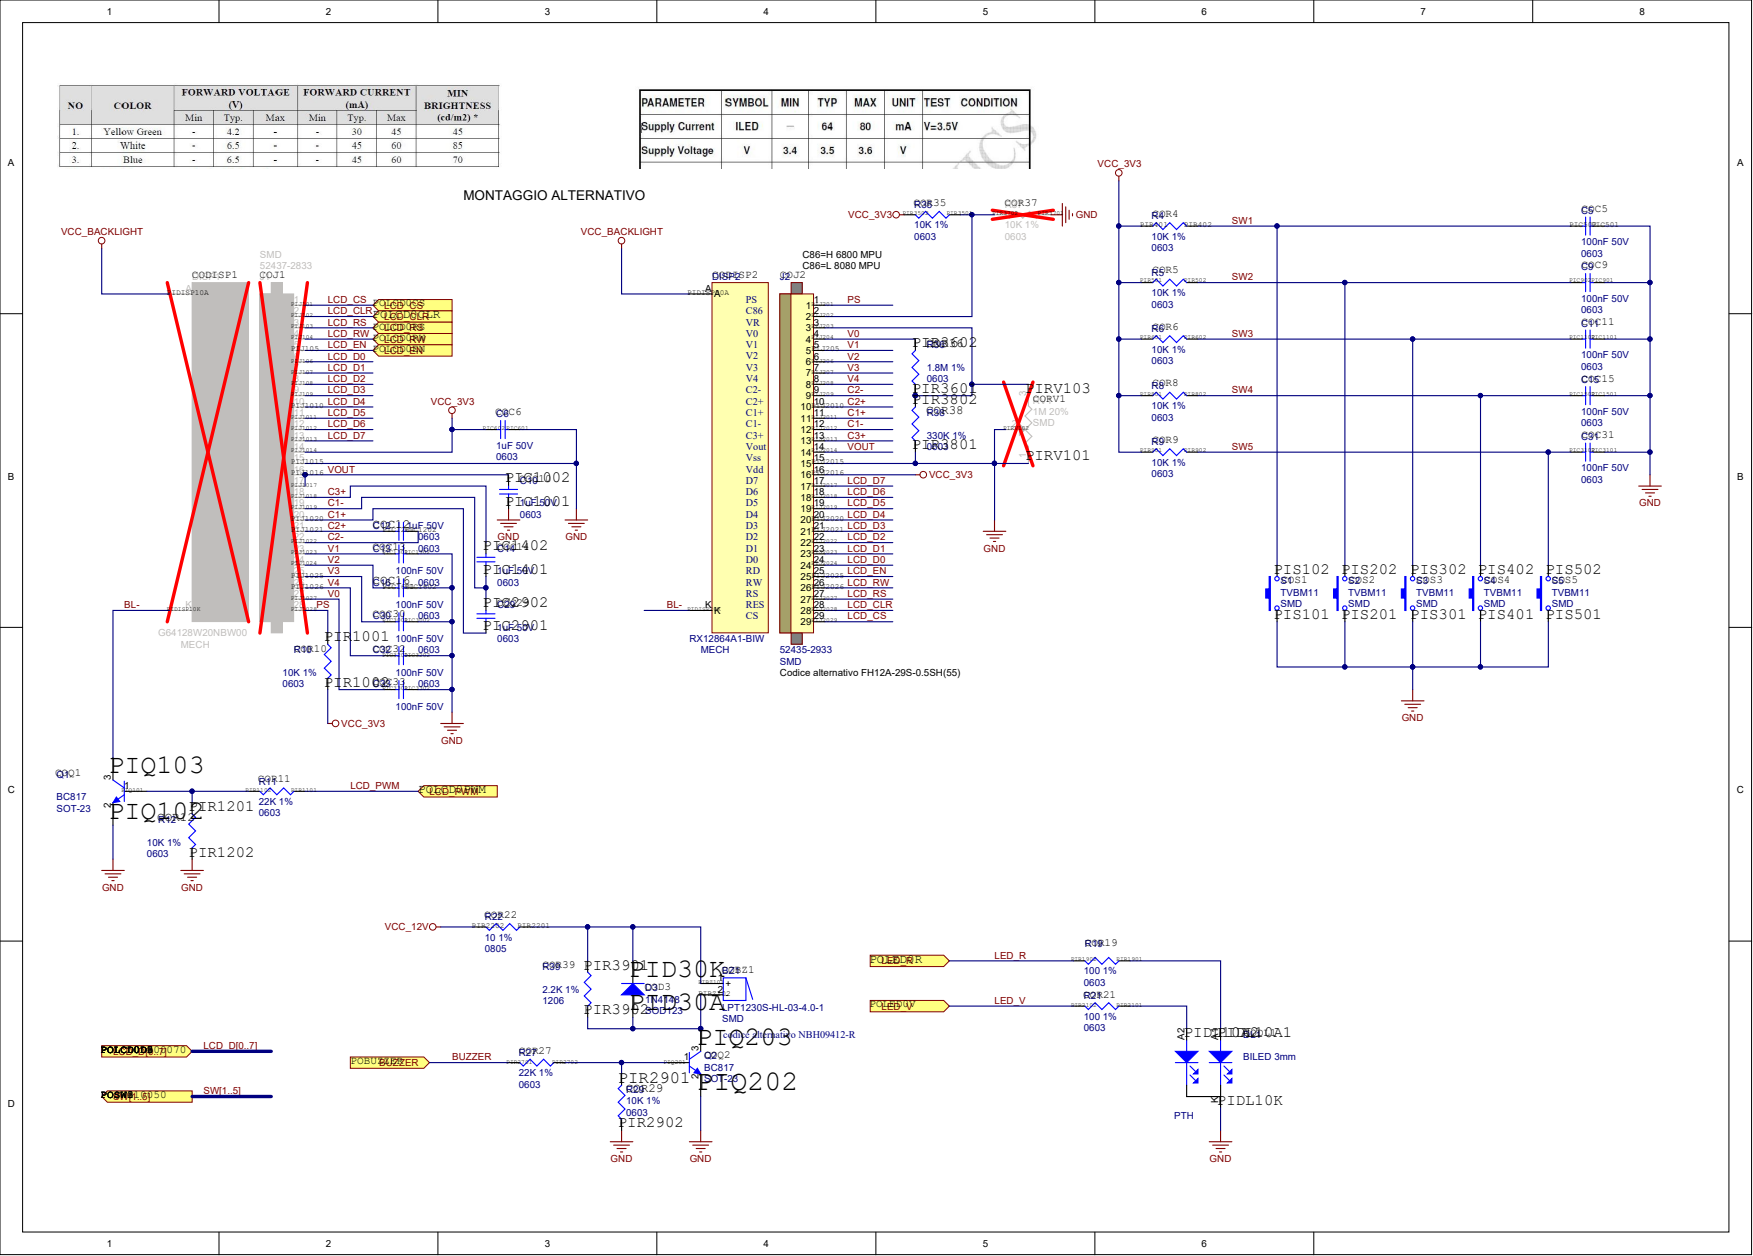
[picture p21: page 4]

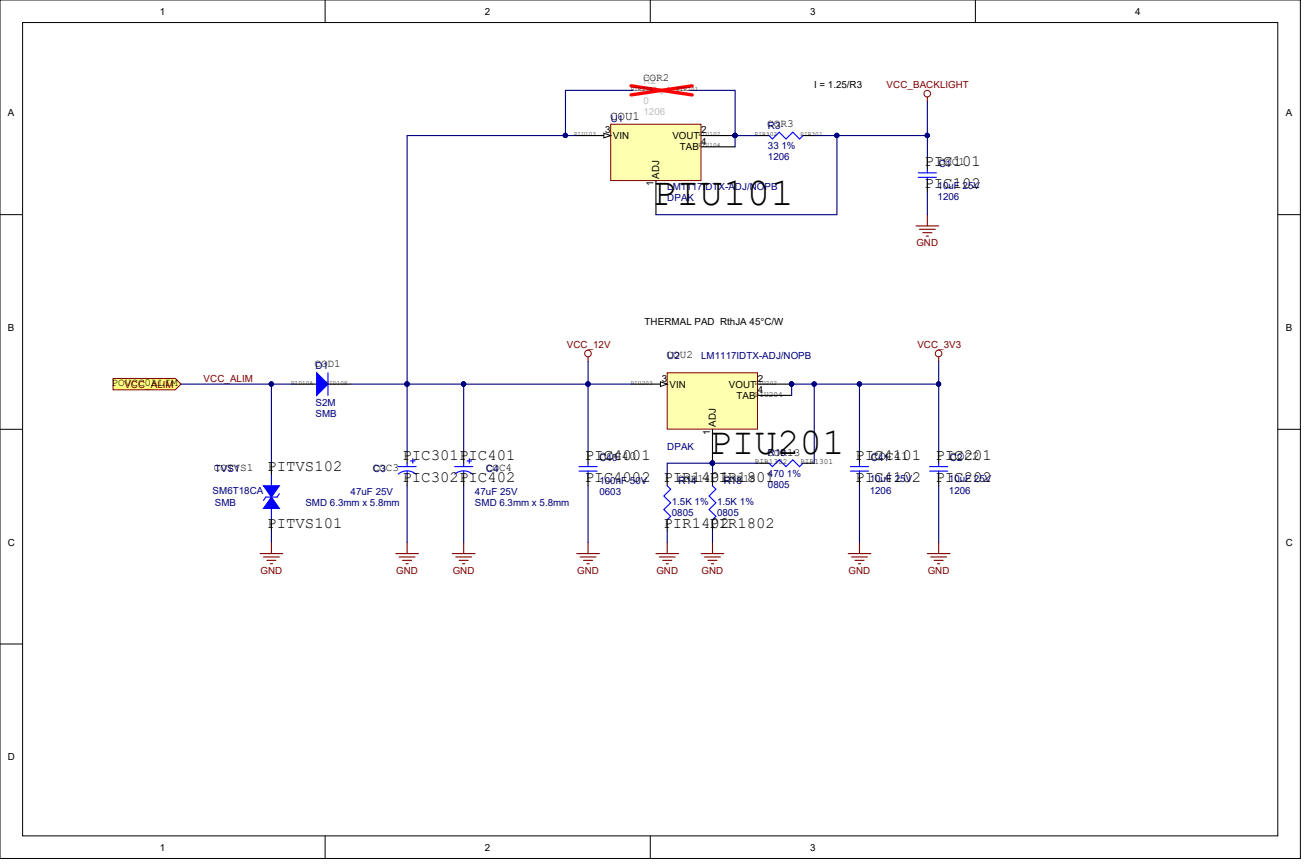
[picture p22: page 5]
