Antonio-Tirri/Aspirnove/Aspirnova Scheda Motori S-283-00/TOPOLOGICO.pdf

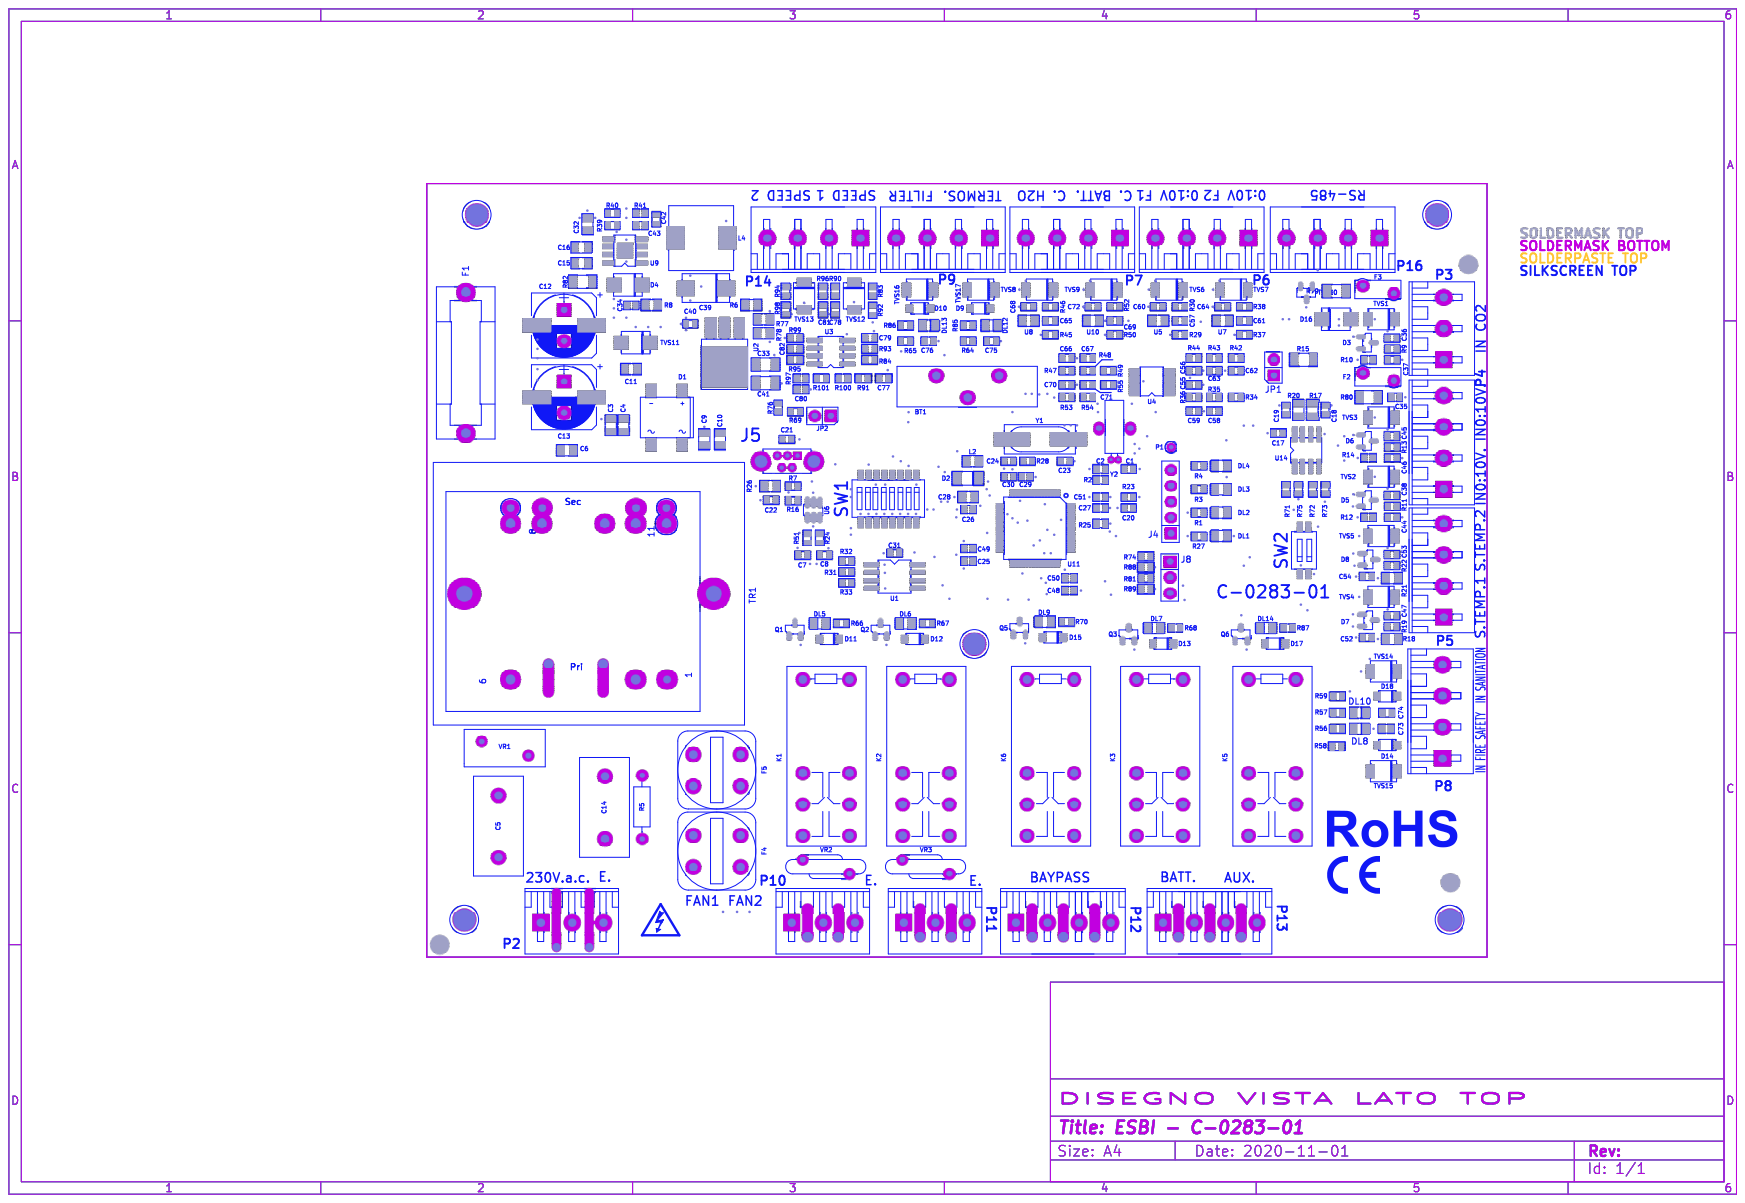
[picture p23: page 1]
