Antonio-Tirri/Aspirnove/Aspirnova Scheda Motori S-283-00/C-0283-01 GERBER IMPAGINATI FORI TR DA 1_6 20220211/C-0283-01/Hole map.PDF

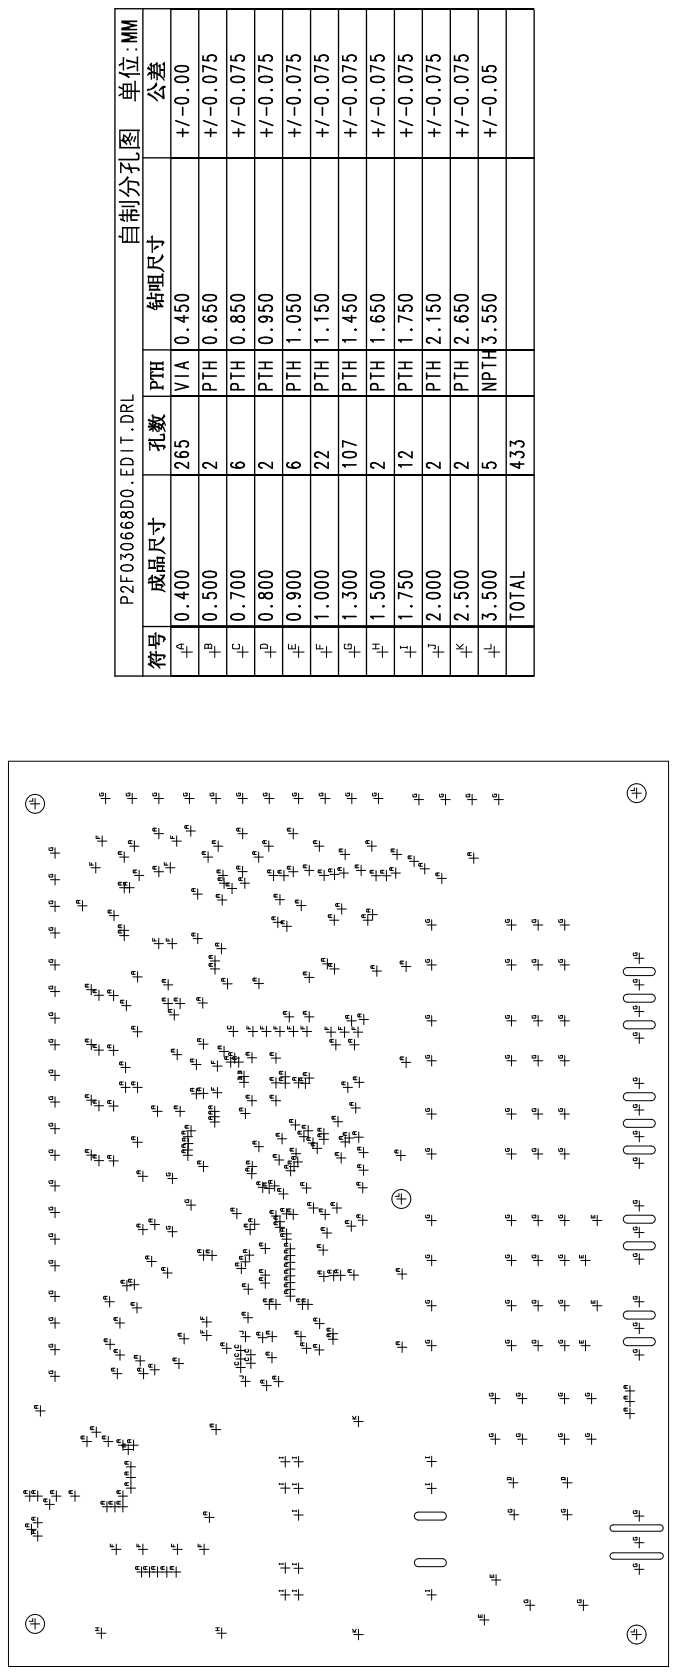
[picture p24: page 1]
