Antonio-Tirri/Aspirnove/Aspirnova Scheda Motori S-283-00/C-0283-01 GERBER IMPAGINATI FORI TR DA 1_6 20220211/C-0283-01/working file in PDF format.PDF

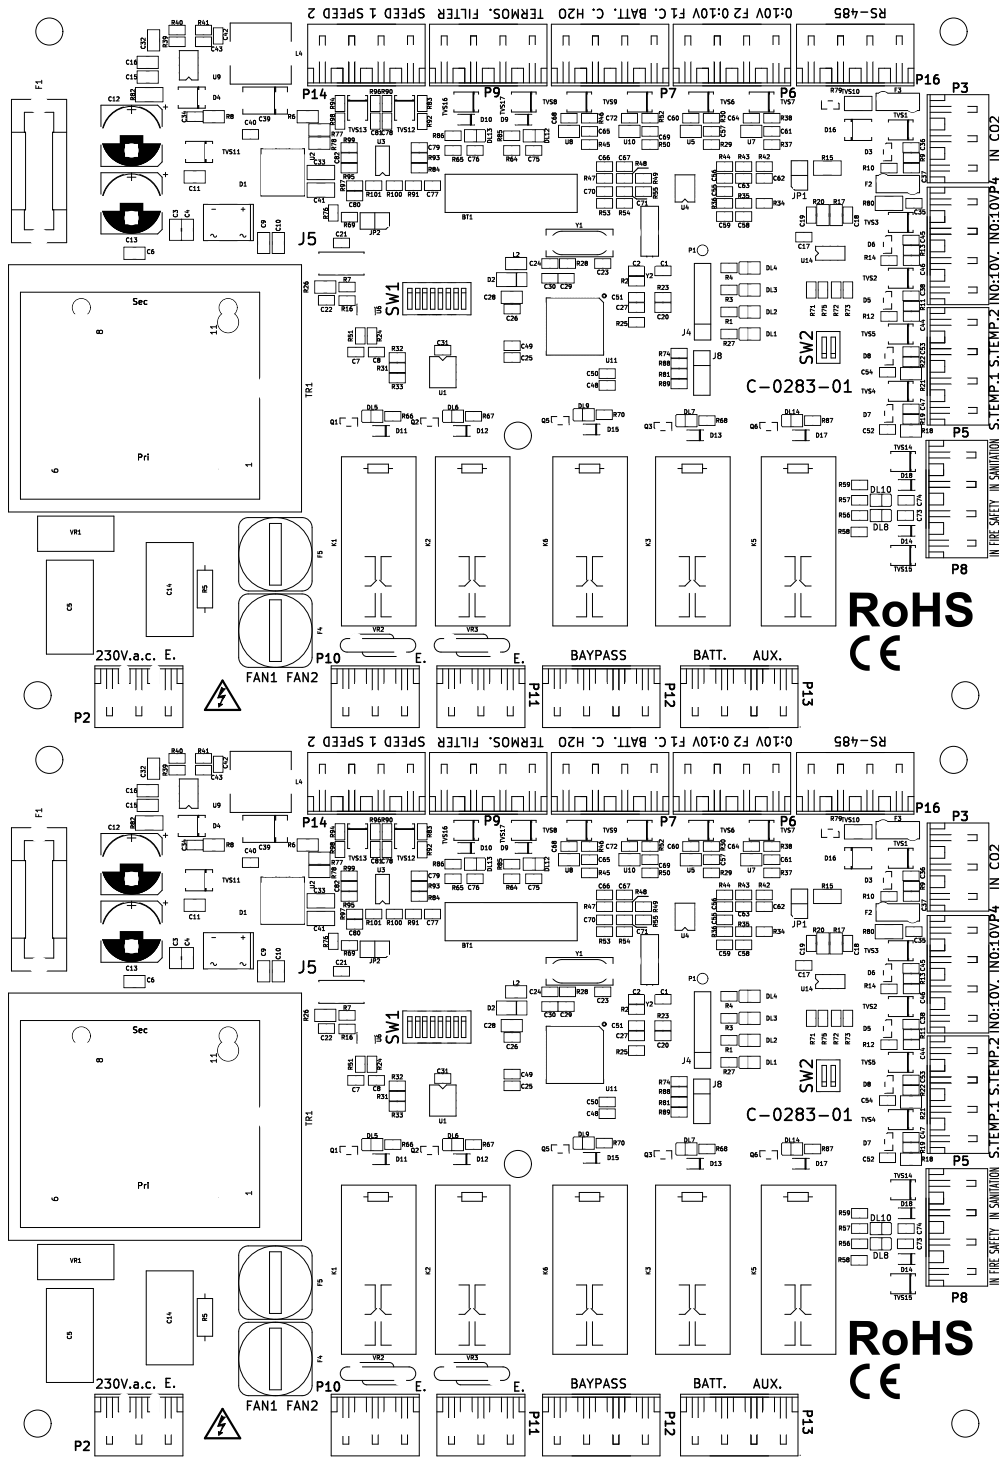
[picture p25: page 1]

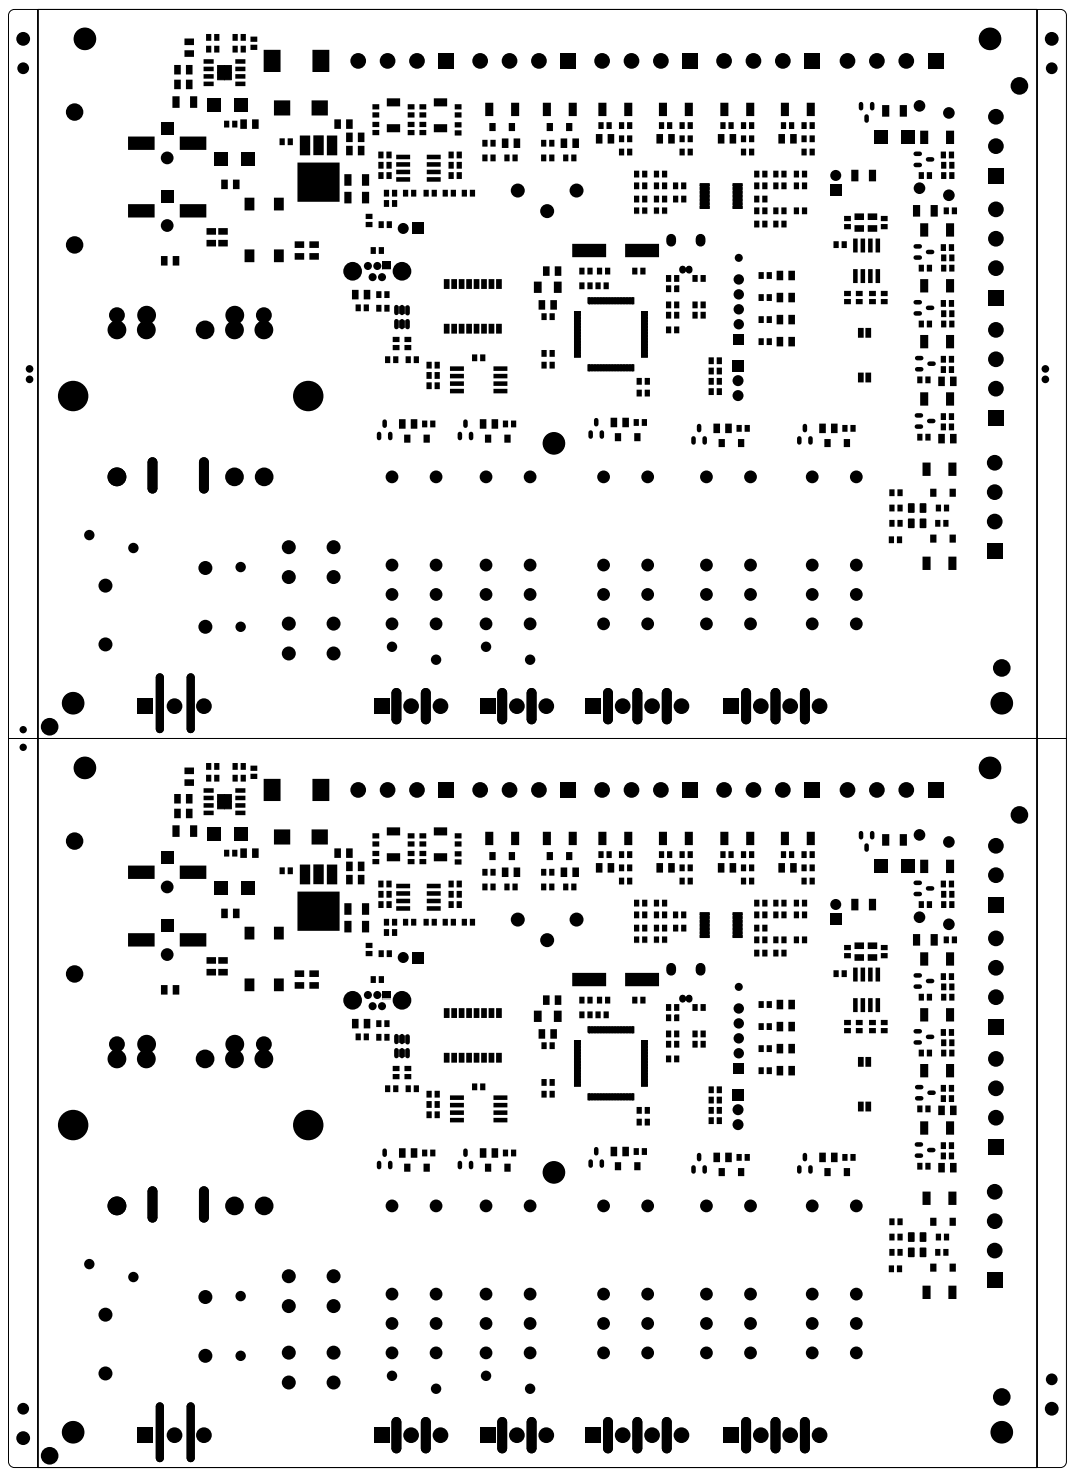
[picture p26: page 2]

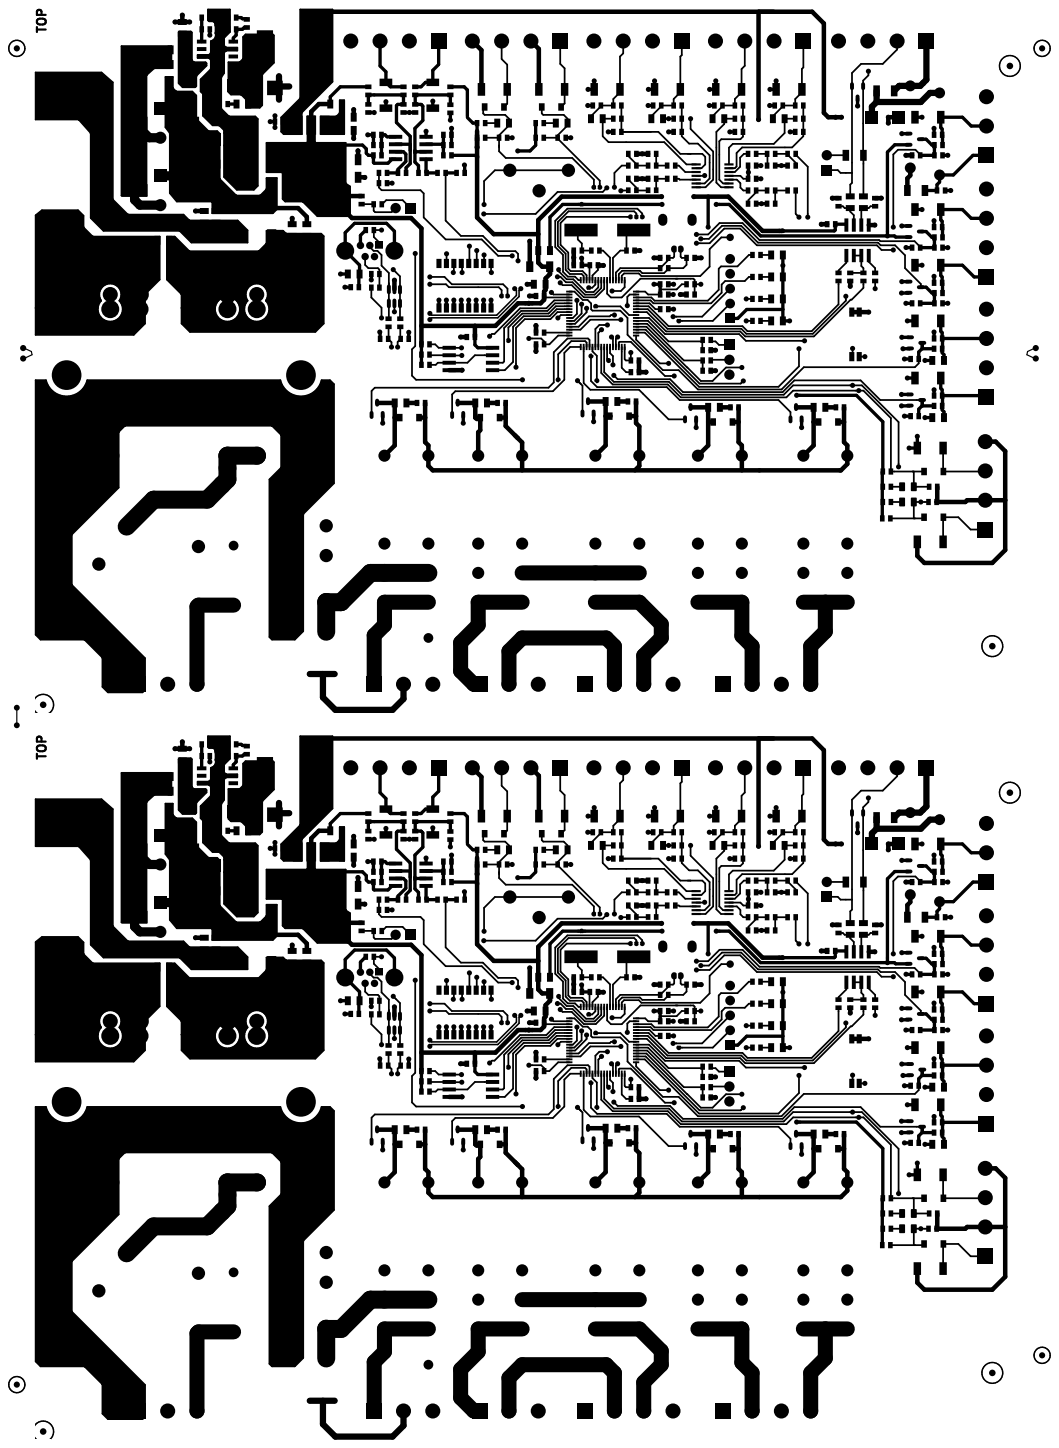
[picture p27: page 3]

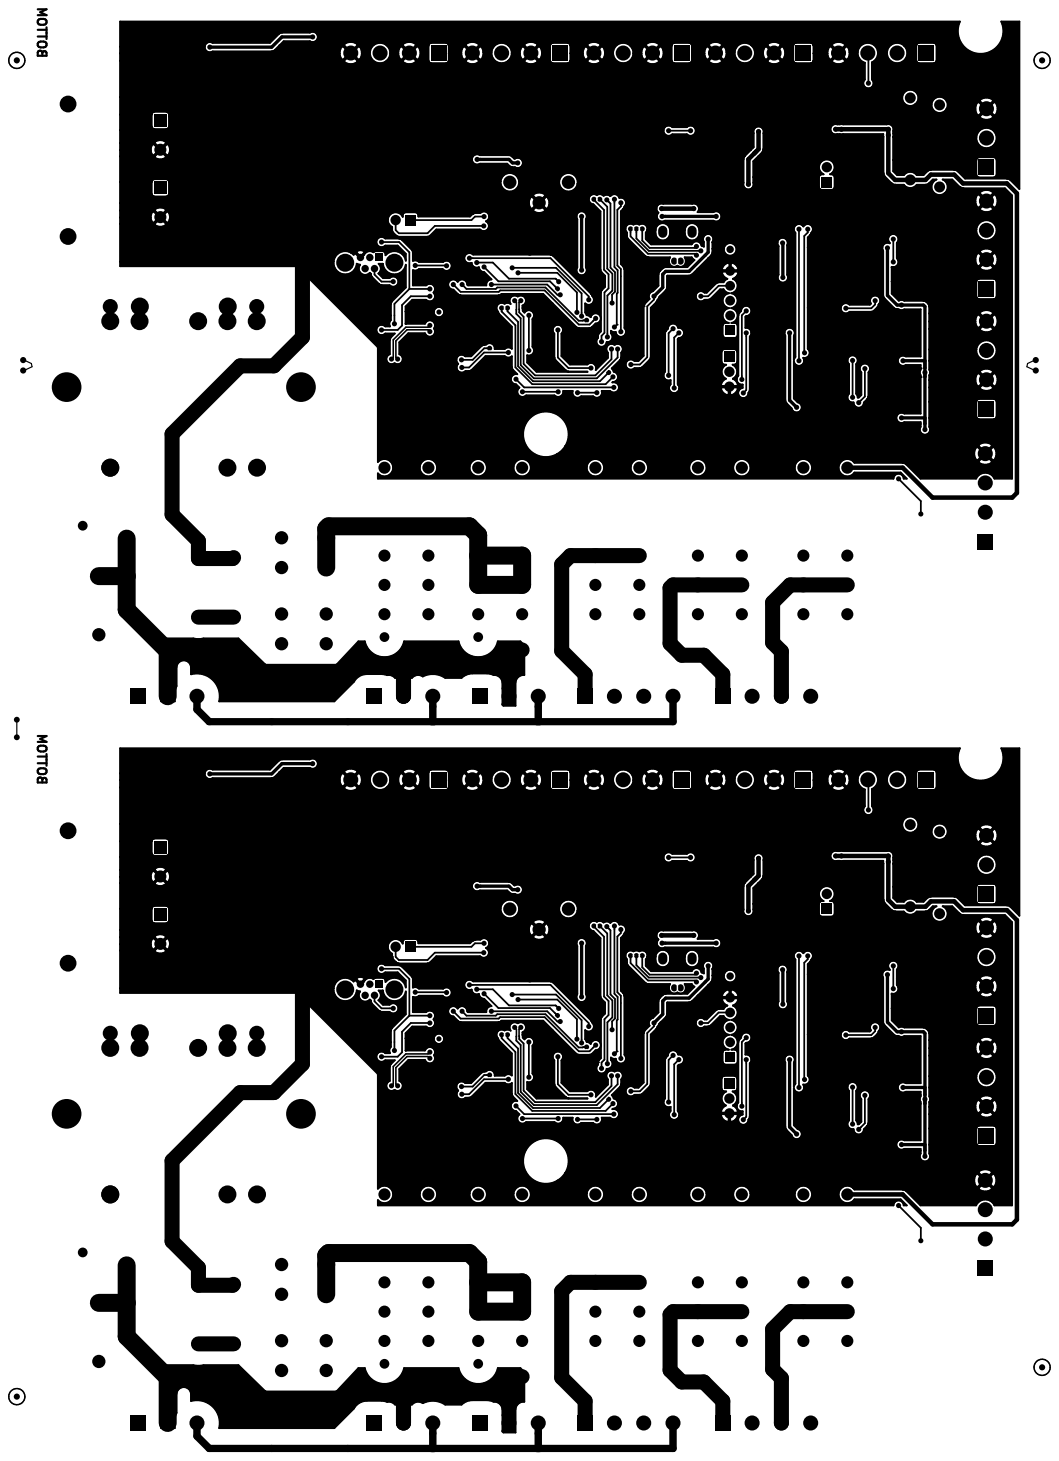
[picture p28: page 4]

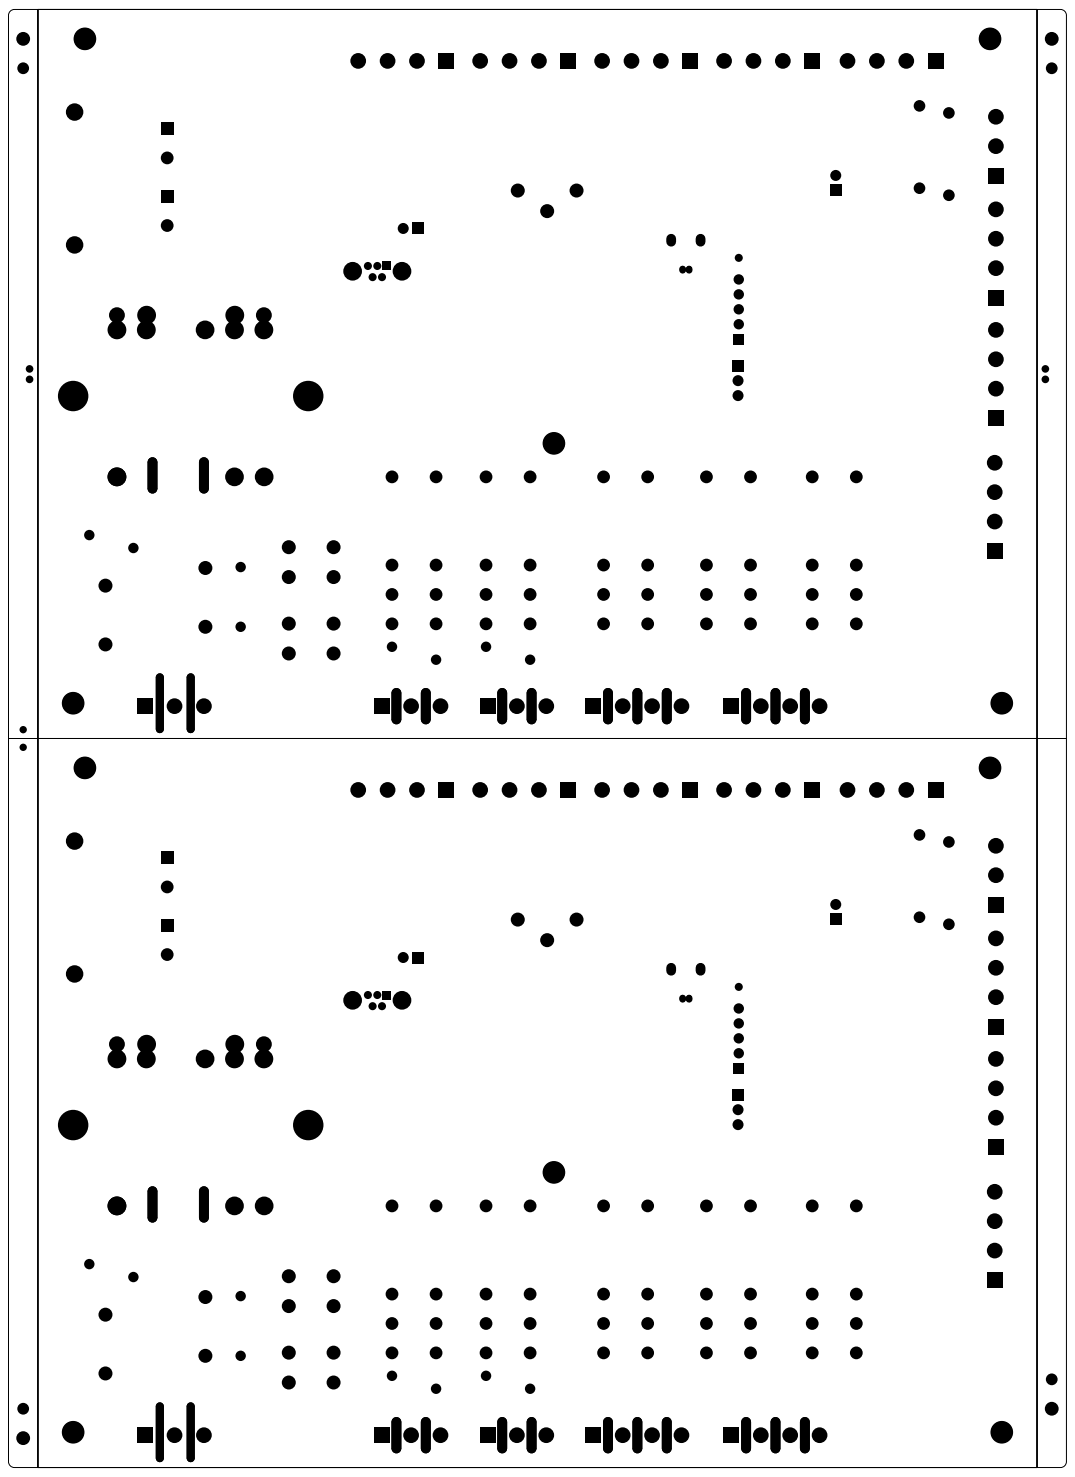
[picture p29: page 5]

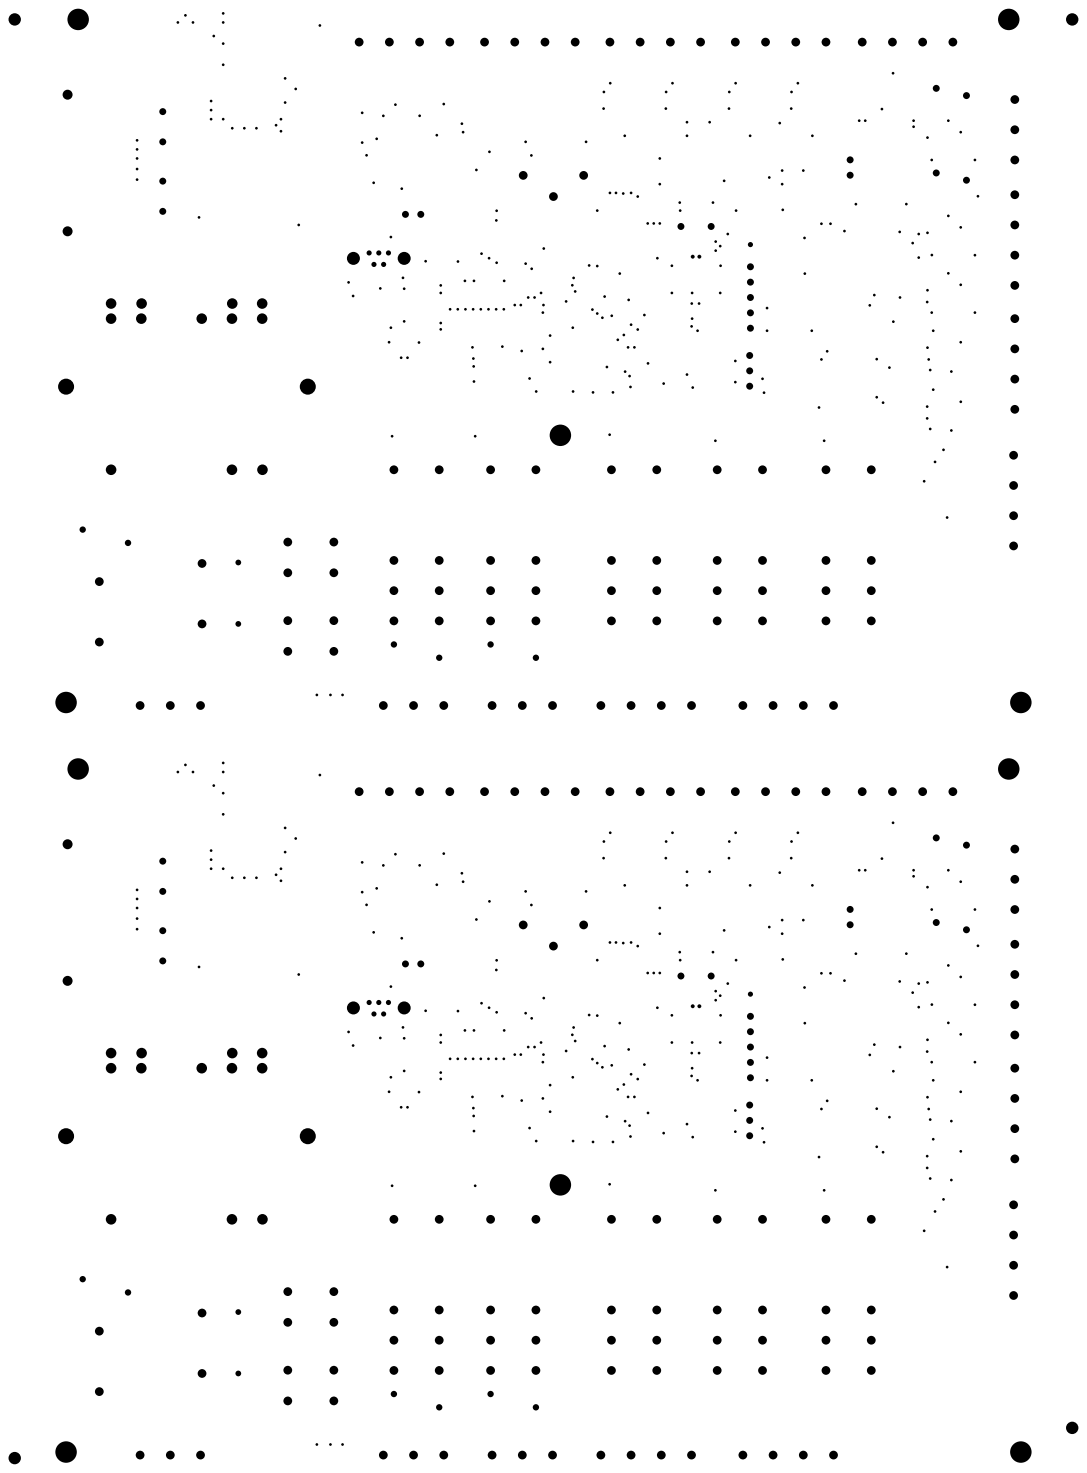
[picture p30: page 6]

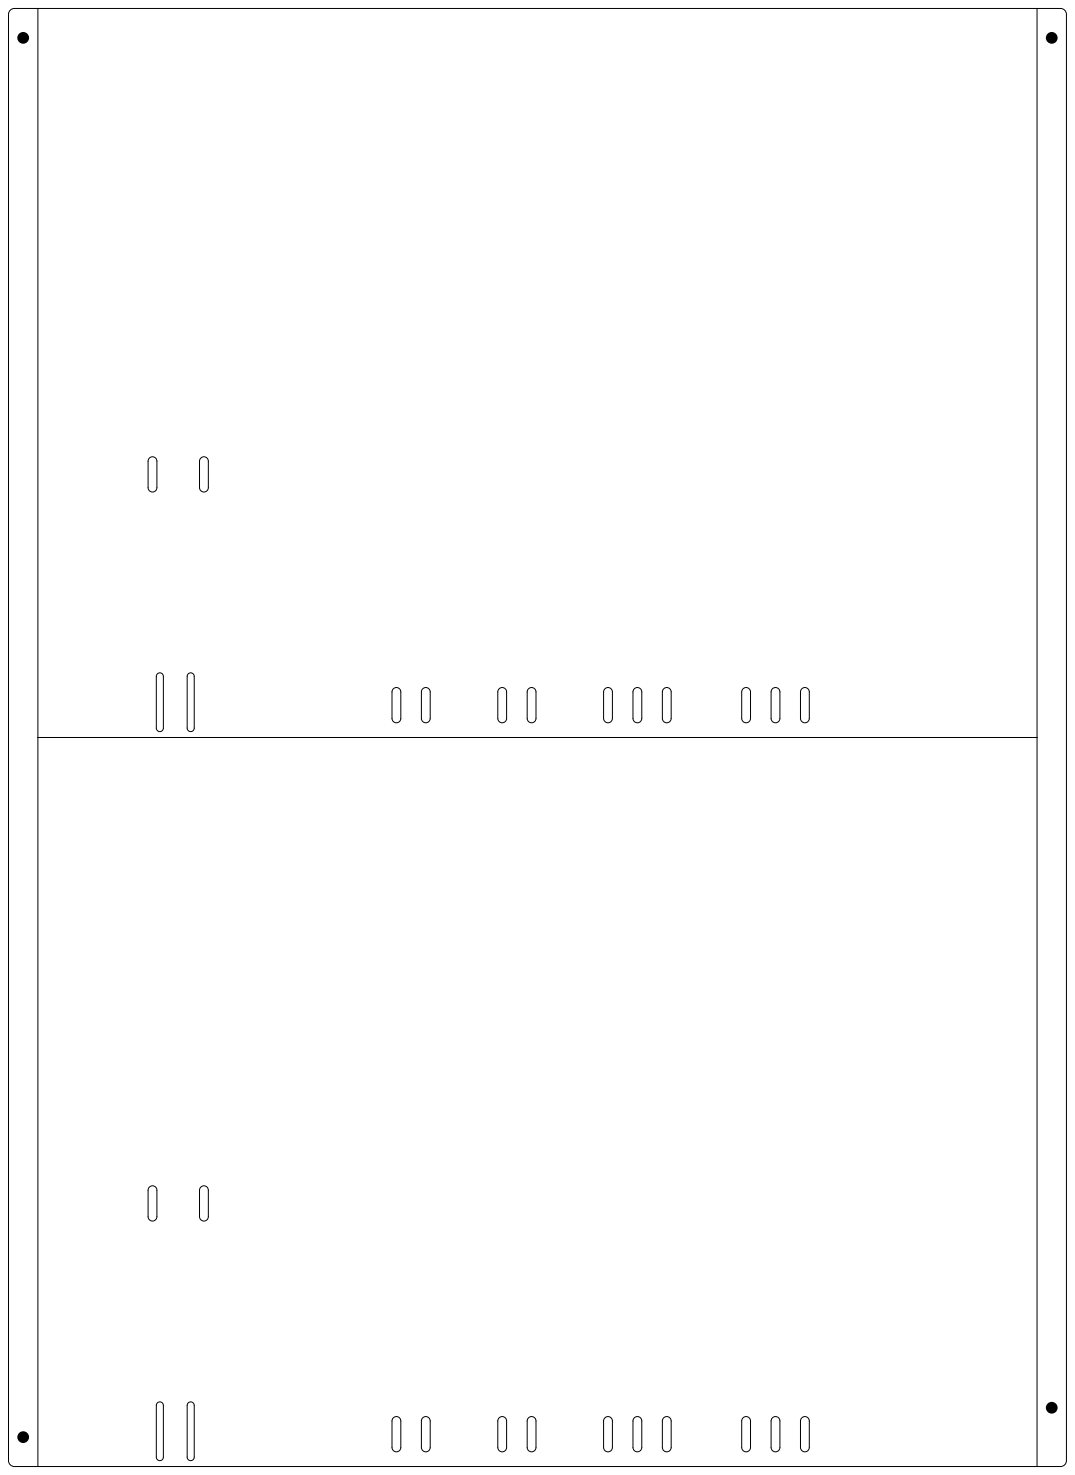
[picture p31: page 7]

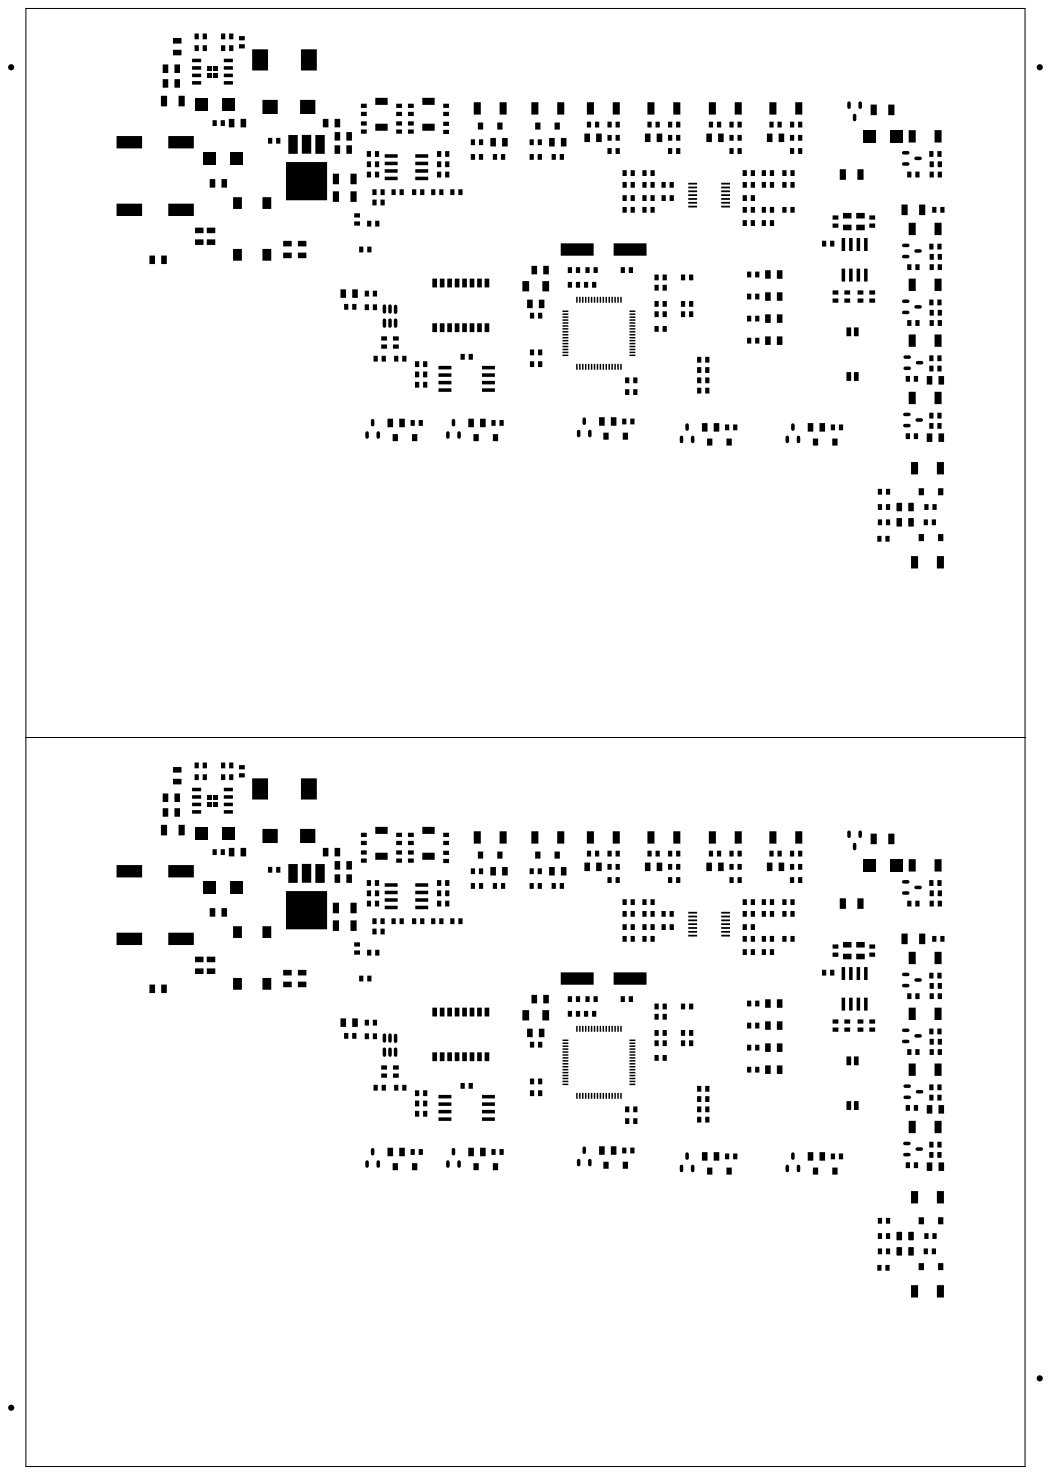
[picture p32: page 8]
