Antonio-Tirri/Aspirnove/Aspirnova Scheda Motori S-283-00/C-0283-01 DISEGNI/S-0283-01.kicad_pcb

## KiCad design Aspirnova Scheda Motori S-283-00/C-0283-01 DISEGNI/S-0283-01.kicad_pcb (2024-01-16)

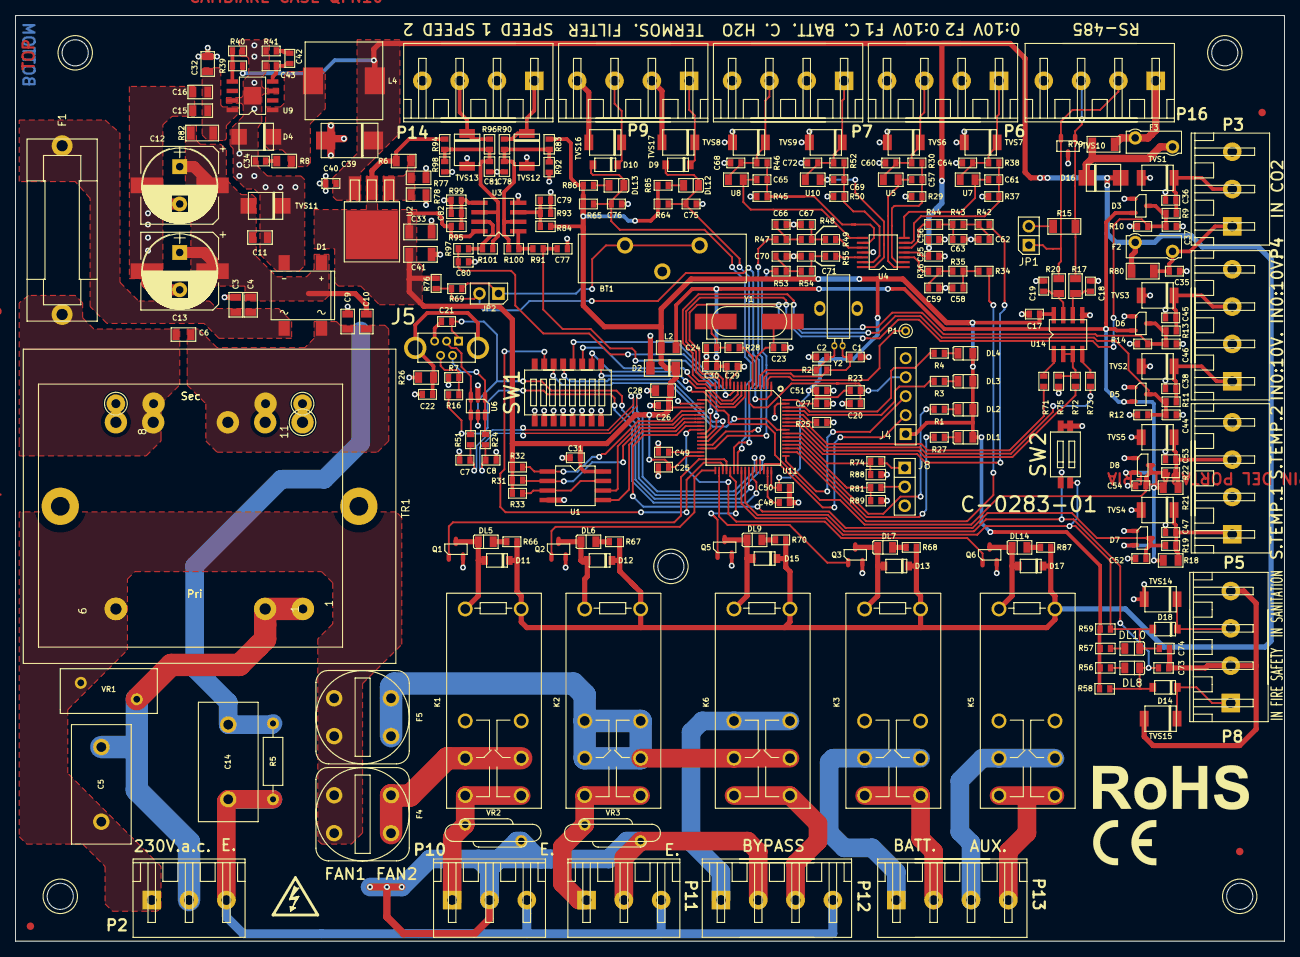
[picture p33: board S-0283-01.kicad_pcb from above]

Board: 2 copper layers, 170.0 x 124.0 mm, 285 parts (0 on the bottom side), 163 nets.

Parts:
BT1: CR-1220/HFN; ADIMPEX_GR000250-R
C1, C2, C7, C8, C23, C24: 12pF; C0603
C3, C4, C9, C10: 10nF; C0805
C5, C14: 100nF; CAP_L16_W8_P10
C6, C11, C15: 100nF; C0805
C12, C13: 470uF; ELE-G-1030
C16, C32: 1uF; C0805
C17, C37, C44, C46, C52, C54, C55, C58, C59, C62, C63, C66, C67, C70, C71: 1uF; C0603
C18, C19: 1nF; C0603
C20, C21, C22, C25, C26, C27, C31, C35, C40, C50, C51, C56, C73, C74, C75, C76: 100nF; C0603
C28: 4.7uF; C0805
C29, C36, C38, C42, C45, C47, C53, C60, C64, C68, C72, C77, C78, C79, C80, C81, C82: 10nF; C0603
C30: 1uf; C0603
C33, C41: 10uF; C1206
C34: 150pF; C0603
C39: 100uF; Tant_Case-D-7343
C43, C57, C61, C65, C69: 100pF; C0603
C48, C49: 2.2uF; C0603
D1: DF04S; DF04S_1234
D2: 3.9VZ; D_MiniMELF_SOD80_AK
D3, D5, D6, D7, D8: BAV199; SOT-23_A1_K2_N
D4: STPS340U; D_SMB_DO-214AA_AK
D9, D10, D11, D12, D13, D14, D15, D17, D18: 1N4148; D_SOD-123_AK
D16: S2M; D_SMB_DO-214AA_AK
DL1, DL2, DL3, DL4, DL5, DL6, DL7, DL8, DL9, DL10, DL12, DL13, DL14: LED; LED0805_AK
F1: 5x20; STLEVIO_PTF78
F2, F3: 72V,; PTC_7.2x3mm_Pitch5mm
F4, F5: 5x20; SCHURTER_FPG4
J4: STRIP2.54-1X5-H11.6-M; SIX5
J5: 651005136421; WURTH_651005136421
J8: STRIP2.54-1X3-H11.6-M; SIX3
JP1, JP2: JMP2; SIX2
K1, K2, K3, K5, K6: HF115FK/12-Z3T; OMRON_G2R2_PINOUT_ESBI_SPECIAL_2
L2: HZ0805C202R-10; L0805
L4: 15uH; EPCOS_B82464P4153M000
P1: PAD; PAD_1.2mm_H0.7mm
P2, P3, P10, P11: CUM5/3; STELVIO_CUM-5_3
P4, P5, P6, P7, P8, P9, P12, P13, P14, P16: CUM5/4; STELVIO_CUM-5_4
Q1, Q2, Q3, Q5, Q6: PDTC143ET,215; SOT-23
R1, R3, R4, R27: 330; R0603
R2: 1M; R0603
R5: 1K; R_Axial_0.250W_L6.3mm_D2.5mm_P10.16mm_Horizontal
R6: 470; R0805
R7, R16, R25, R69, R76, R88, R89, R100, R101: 0; R0603
R8, R17, R20: 4.7; R0805
R9, R11, R13, R23, R31, R32, R33, R39, R41, R58, R59, R64, R65, R75: 10K; R0603
R10, R12, R14: 3.9K; R0603
R15: 120; R1206
R18, R21: 4.7K; R0805
R19, R22, R71, R72, R73, R74, R81: 1K; R0603
R24, R51: 10; R0603
R26: 1M; R0805
R28: 220; R0603
R29, R37, R45, R50: 12K; R0603
R30, R38, R46, R52: 27K; R0603
R34, R35, R36, R42, R43, R44, R47, R48, R49, R53, R54, R55, R66, R67, R68, R70, R87: 4.7K; R0603
R40: 1.1K; R0603
R56, R57, R85, R86: 560; R0603
R77, R78: 1.5K; R0805
R79, R80, R82: 0; R1206
R83, R84, R93, R94, R95, R99: 47K; R0603
R90, R91, R96, R97: 100; R0603
R92, R98: 5.6K; R0603
SW1: GDH08S04; TE_GDH08S04
SW2: GDH02S04; TE_GDH02S04
TR1: 15V; MYRRA_44194
TVS1, TVS2, TVS3, TVS4, TVS5, TVS6, TVS7, TVS8, TVS9, TVS12, TVS13, TVS14, TVS15, TVS16, TVS17: PTVS13VP1UTP; D_SOD-128_AK
TVS10: CDSOT23-SM712; SOT-23
TVS11: SM6T30CA; D_SMB_DO-214AA
U1: S25FL164K0XMFI011; SOIC-8W_5.3x5.3mm_Pitch1.27mm
U2: LM1117IDTX-ADJ/NOPB; TO-252-3Lead_4TAB
U3: TS922ID; SOIC-8_3.9x4.9mm_Pitch1.27mm
U4: LM224DTBR2G; TSSOP-14_4.4x5mm_Pitch0.65mm
U5, U7, U8, U10: 10; R0805
U6: USBLC6-2SC6; SOT-23-6_SC74
U9: L5973D013TR; SOIC-8-1EP_3.9x4.9mm_Pitch1.27mm
U11: STM32F205RCT6; QFP-64_10x10mm_Pitch0.5mm
U14: SN65HVD75D; SOIC-8_3.9x4.9mm_Pitch1.27mm
VR1, VR2, VR3: S14K275E; RV_Disc_D13_W6_P7.5
Y1: 12MHz; Crystal_SMD_HC49
Y2: 32.768kHz; AB38T_Horizontal_Reverse

Connections:
512Hz_OUT: P1.1, U11.2
AGND: BT1.-, C1.2, C2.2, C3.2, C7.2, C8.2, C9.1, C11.2, C12.2, C13.2, C14.2, C15.2, C16.2, C17.2, C18.2, C19.2, C20.2, C21.2, C22.2, C23.2, C24.2, C25.2, C26.2, C27.2, C28.2, C29.2, C30.2, C31.2, C32.2, C33.2, C34.2, C35.2, C36.2, C37.2, C38.2, C39.2, C40.2, C41.2, C43.2, C44.2, C45.2, C46.2, C47.2, C48.2, C49.2, C50.2, C51.2, C52.2, C53.2, C54.2, C55.2, C56.2, C58.2, C59.2, C60.2, C62.2, C63.2, C64.2, C66.2, C67.2, C68.2, C70.2, C71.2, C72.2, C73.2, C74.2, C75.2, C76.2, C77.2, C78.2, C79.1, C80.2, C81.2, C82.1, D1.2, D2.A, D3.A1, D4.A, D5.A1, D6.A1, D7.A1, D8.A1, J4.5, J5.5, J8.3, P3.3, P4.2, P4.4, P5.2, P5.4, P6.2, P6.4, P7.2, P7.4, P8.2, P8.4, P9.2, P9.4, P14.2, P14.4, P16.4, Q1.2, Q2.2, Q3.2, Q5.2, Q6.2, R5.2, R7.2, R10.2, R12.2, R14.2, R25.1, R26.2, R29.2, R37.2, R40.2, R41.2, R45.2, R50.2, R75.2, R77.2, R78.2, R88.1, R89.1, R92.2, R93.2, R98.2, R99.2, SW1.10, SW1.11, SW1.12, SW1.13, SW1.14, SW1.15, SW1.16, SW2.3, SW2.4, TVS1.A, TVS2.A, TVS3.A, TVS4.A, TVS5.A, TVS6.A, TVS7.A, TVS8.A, TVS9.A, TVS10.3, TVS11.1, TVS12.A, TVS13.A, TVS14.A, TVS15.A, TVS16.A, TVS17.A, U1.4, U3.4, U4.11, U6.2, U9.3, U9.7, U9.9, U11.12, U11.18, U11.63, U14.5
AN0_CO2: C37.1, D3.N, R9.1, R10.1, U11.14
AN1_AUX1: C44.1, D5.N, R11.1, R12.1, U11.15
AN2_AUX2: C46.1, D6.N, R13.1, R14.1, U11.16
AN2_TEMP_INT: C52.1, D7.N, R19.1, U11.24
AN14_TEMP_EXT: C54.1, D8.N, R22.1, U11.17
ANOUT_BATT: R53.2, U11.30
ANOUT_FAN1: R34.2, U11.50
ANOUT_FAN2: R42.2, U11.55
ANOUT_H2O: R47.2, U11.29
AUX_C: K5.3, K5.6, P13.3
AUX_NO: K5.4, K5.5, P13.4
BATT_C: K3.3, K3.6, P13.1
BATT_NO: K3.4, K3.5, P13.2
BYP_C: C5.1, F4.2, F5.2, P2.1, TR1.5, VR1.2
BYP_NC: K6.2, K6.7, P12.1
BYP_NO: K6.4, K6.5, P12.3
DIN_FILTRO: C76.1, D10.A, DL13.K, R65.2, U11.39
DIN_LV1: C73.1, D14.A, DL8.K, R58.2, SW2.1, U11.41
DIN_LV2: C74.1, D18.A, DL10.K, R59.2, SW2.2, U11.40
DIN_TERMOST: C75.1, D9.A, DL12.K, R64.2, U11.38
DIP_1: SW1.1, U11.8
DIP_2: SW1.2, U11.9
DIP_3: SW1.3, U11.10
DIP_4: SW1.4, U11.11
DIP_5: SW1.5, U11.28
DIP_6: SW1.6, U11.56
DIP_7: SW1.7, U11.35
EARTH: C14.1, P2.3, P10.3, P11.3, P12.4, R5.1
FAN1_C: F4.1, K1.3, K1.6
FAN1_NO: K1.4, K1.5, P10.1, VR2.2
FAN2_C: F5.1, K2.2, K2.3, K2.6, K2.7, K6.3, K6.6
FAN2_NO: K2.4, K2.5, P11.1, VR3.2
FLASH_CS: R32.2, U1.1, U11.20
FLASH_MISO: R31.2, U1.2, U11.22
FLASH_MOSI: U1.5, U11.23
FLASH_SCK: U1.6, U11.21
IN_AUX1: C38.1, P4.1, R11.2, TVS2.K
IN_AUX2: C45.1, P4.3, R13.2, TVS3.K
IN_CO2: C36.1, P3.2, R9.2, TVS1.K
JTAG_RESET: C20.1, J4.4, R23.2, U11.7
JTAG_SWCLK: J4.3, U11.49
JTAG_SWDIO: J4.2, U11.46
LED_ERR: R27.2, U11.51
LED_ON: R1.2, U11.52
LED_PC1: R3.2, U11.61
LED_PC2: R4.2, U11.62
MAIN_N: C5.2, P2.2, P10.2, P11.2, P12.2, TR1.1, VR1.1, VR2.1, VR3.1
NetBT1_+: BT1.+, JP2.1, R69.1
NetC1_1: C1.1, R2.2, U11.3, Y2.1
NetC2_1: C2.1, R2.1, U11.4, Y2.2
NetC3_1: C3.1, C4.1, D1.3, F1.2
NetC4_2: C4.2, C10.1, C11.1, C12.1, C13.1, D1.1, R82.2, TVS11.2
NetC6_1: C6.1, F1.1, TR1.7
NetC6_2: C6.2, C9.2, C10.2, D1.4, TR1.9
NetC18_1: C18.1, R17.2, U14.6
NetC19_1: C19.1, R20.2, U14.7
NetC22_1: C22.1, J5.S, R26.1
NetC23_1: C23.1, U11.5, Y1.1
NetC24_1: C24.1, R28.2, Y1.2
NetC34_1: C34.1, R8.2
NetC35_1: C35.1, F2.1, P3.1, R80.2
NetC42_1: C42.1, C43.1, U9.4
NetC42_2: C42.2, R41.1
NetC47_1: C47.1, P5.1, R18.2, R19.2, TVS4.K
NetC48_1: C48.1, U11.47
NetC49_1: C49.1, U11.31
NetC53_1: C53.1, P5.3, R21.2, R22.2, TVS5.K
NetC57_1: C57.1, R29.1, R30.2, U4.2
NetC57_2: C57.2, U4.1, U5.2
NetC58_1: C58.1, R34.1, R35.2
NetC59_1: C59.1, R35.1, R36.2
NetC60_1: C60.1, P6.3, R30.1, TVS6.K, U5.1
NetC61_1: C61.1, R37.1, R38.2, U4.6
NetC61_2: C61.2, U4.7, U7.2
NetC62_1: C62.1, R42.1, R43.2
NetC63_1: C63.1, R43.1, R44.2
NetC64_1: C64.1, P6.1, R38.1, TVS7.K, U7.1
NetC65_1: C65.1, R45.1, R46.2, U4.9
NetC65_2: C65.2, U4.8, U8.2
NetC66_1: C66.1, R47.1, R48.2
NetC67_1: C67.1, R48.1, R49.2
NetC68_1: C68.1, P7.3, R46.1, TVS8.K, U8.1
NetC69_1: C69.1, R50.1, R52.2, U4.13
NetC69_2: C69.2, U4.14, U10.2
NetC70_1: C70.1, R53.1, R54.2
NetC71_1: C71.1, R54.1, R55.2
NetC72_1: C72.1, P7.1, R52.1, TVS9.K, U10.1
NetC78_1: C78.1, R83.2, R90.2, R92.1, R100.1, U3.2
NetC79_2: C79.2, R84.2, R93.1, U3.3
NetC81_1: C81.1, R94.2, R96.2, R98.1, R101.1, U3.6
NetC82_2: C82.2, R95.2, R99.1, U3.5
NetD4_K: D4.K, L4.1, R8.1, U9.1
NetD9_K: D9.K, P9.1, TVS17.K
NetD10_K: D10.K, P9.3, TVS16.K
NetD11_A: D11.A, DL5.K, K1.1, Q1.3
NetD12_A: D12.A, DL6.K, K2.1, Q2.3
NetD13_A: D13.A, DL7.K, K3.1, Q3.3
NetD14_K: D14.K, P8.1, TVS15.K
NetD15_A: D15.A, DL9.K, K6.1, Q5.3
NetD16_K: D16.K, F3.1, R79.2
NetD17_A: D17.A, DL14.K, K5.1, Q6.3
NetD18_K: D18.K, P8.3, TVS14.K
NetDL1_K: DL1.K, R27.1
NetDL2_K: DL2.K, R1.1
NetDL3_K: DL3.K, R3.1
NetDL4_K: DL4.K, R4.1
NetDL5_A: DL5.A, R66.2
NetDL6_A: DL6.A, R67.2
NetDL7_A: DL7.A, R68.2
NetDL8_A: DL8.A, R56.2
NetDL9_A: DL9.A, R70.2
NetDL10_A: DL10.A, R57.2
NetDL12_A: DL12.A, R85.2
NetDL13_A: DL13.A, R86.2
NetDL14_A: DL14.A, R87.2
NetF3_2: F3.2, P16.1, R79.1
NetJ5_4: J5.4, R7.1, R16.1
NetJ8_1: J8.1, R74.1
NetJ8_2: J8.2, R81.1
NetJP1_2: JP1.2, R15.1
NetJP2_2: JP2.2, R69.2, R76.1, U11.1
NetP14_1: P14.1, R90.1, TVS12.K
NetP14_3: P14.3, R96.1, TVS13.K
NetR6_2: R6.2, R77.1, R78.1, U2.1
NetR25_2: R25.2, U11.60
NetR28_1: R28.1, U11.6
NetR33_2: R33.2, U1.3, U1.7
NetR36_1: R36.1, U4.3
NetR39_2: R39.2, R40.1, U9.5
NetR44_1: R44.1, U4.5
NetR49_1: R49.1, U4.10
NetR55_1: R55.1, U4.12
NetR71_1: R71.1, U14.1
NetR72_2: R72.2, R75.1, U14.2, U14.3
NetR73_2: R73.2, U14.4
NetR91_1: R91.1, R100.2, U3.1
NetR97_1: R97.1, R101.2, U3.7
RELE_AUX1: Q6.1, U11.25
RELE_BATT: Q3.1, U11.34
RELE_BYP: Q5.1, U11.37
RELE_FAN1: Q1.1, U11.36
RELE_FAN2: Q2.1, U11.33
RS485_A: P16.3, R15.2, R17.1, TVS10.1
RS485_B: JP1.1, P16.2, R20.1, TVS10.2
RS485_DIR: R72.1, U11.57
RS485_RX: R71.2, U11.59
RS485_TX: R73.1, U11.58
TACH_F1: C77.1, R91.2, U11.26
TACH_F2: C80.1, R97.2, U11.27
UART5_RX: R74.2, R88.2, U11.54
UART5_TX: R81.2, R89.2, U11.53
USB_DN: C8.1, R24.1, U11.44
USB_DP: C7.1, R51.1, U11.45
USB_ID: R16.2, U11.43
USB_N: J5.2, R24.2, U6.1, U6.6
USB_P: J5.3, R51.2, U6.3, U6.4
VCC_3V3: C17.1, C25.1, C26.1, C27.1, C28.1, C31.1, C33.1, C41.1, C50.1, C51.1, D2.K, DL1.A, DL2.A, DL3.A, DL4.A, J4.1, L2.1, R6.1, R23.1, R31.1, R32.1, R33.1, R56.1, R57.1, R58.1, R59.1, R64.1, R65.1, R76.2, R83.1, R84.1, R85.1, R86.1, R94.1, R95.1, U1.8, U2.2, U2.4, U3.8, U11.19, U11.32, U11.48, U11.64, U14.8
VCC_3V3A: C29.1, C30.1, D3.K2, D5.K2, D6.K2, D7.K2, D8.K2, L2.2, R18.1, R21.1, U11.13
VCC_12V: C39.1, C40.1, C55.1, C56.1, D11.K, D12.K, D13.K, D15.K, D16.A, D17.K, F2.2, K1.8, K2.8, K3.8, K5.8, K6.8, L4.2, R39.1, R66.1, R67.1, R68.1, R70.1, R80.1, R87.1, U2.3, U4.4
VCC_UNREG: C15.1, C16.1, C32.1, R82.1, U9.8
VCC_VUSB: C21.1, J5.1, U6.5, U11.42
