Antonio-Tirri/Aspirnove/Display BW S-0241-02/DISEGNI/C-0241-05/C-0241-05.kicad_pcb

## KiCad design Display BW S-0241-02/DISEGNI/C-0241-05/C-0241-05.kicad_pcb (2024-01-16)

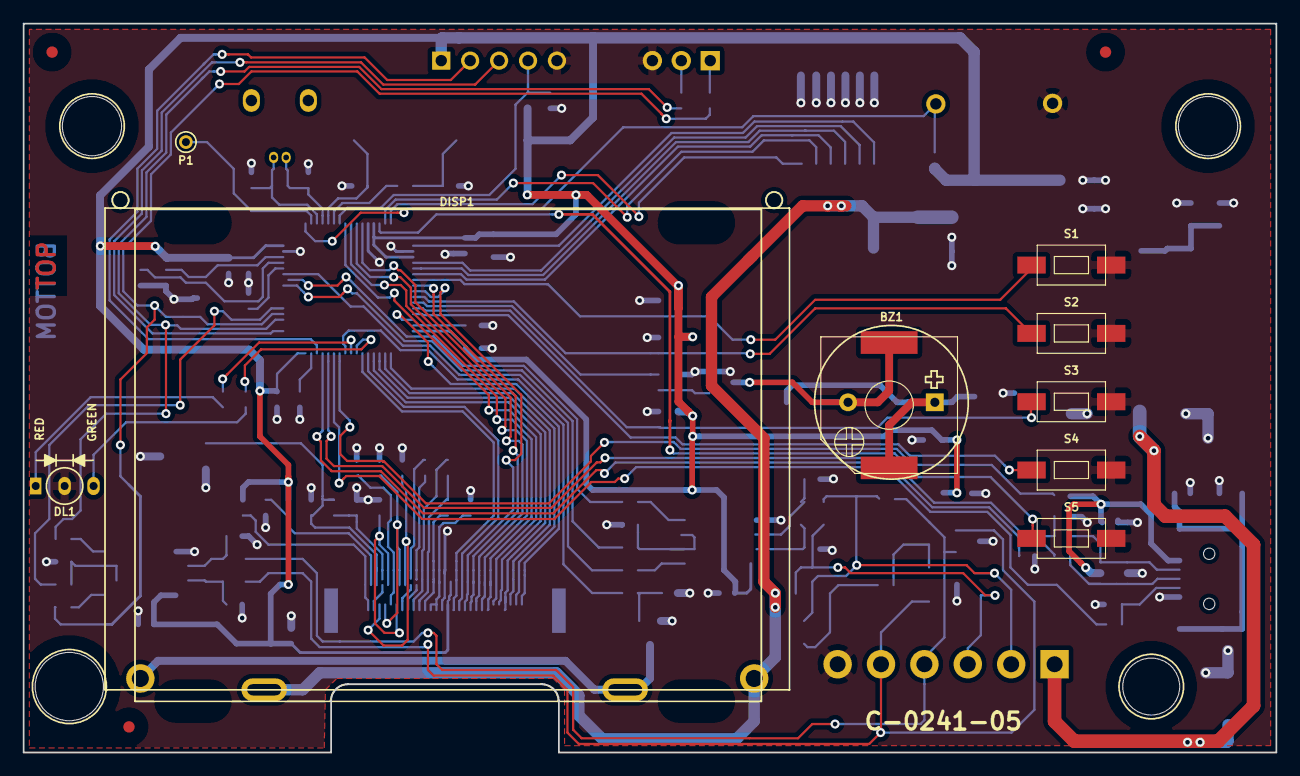
[picture p34: board C-0241-05.kicad_pcb from above]

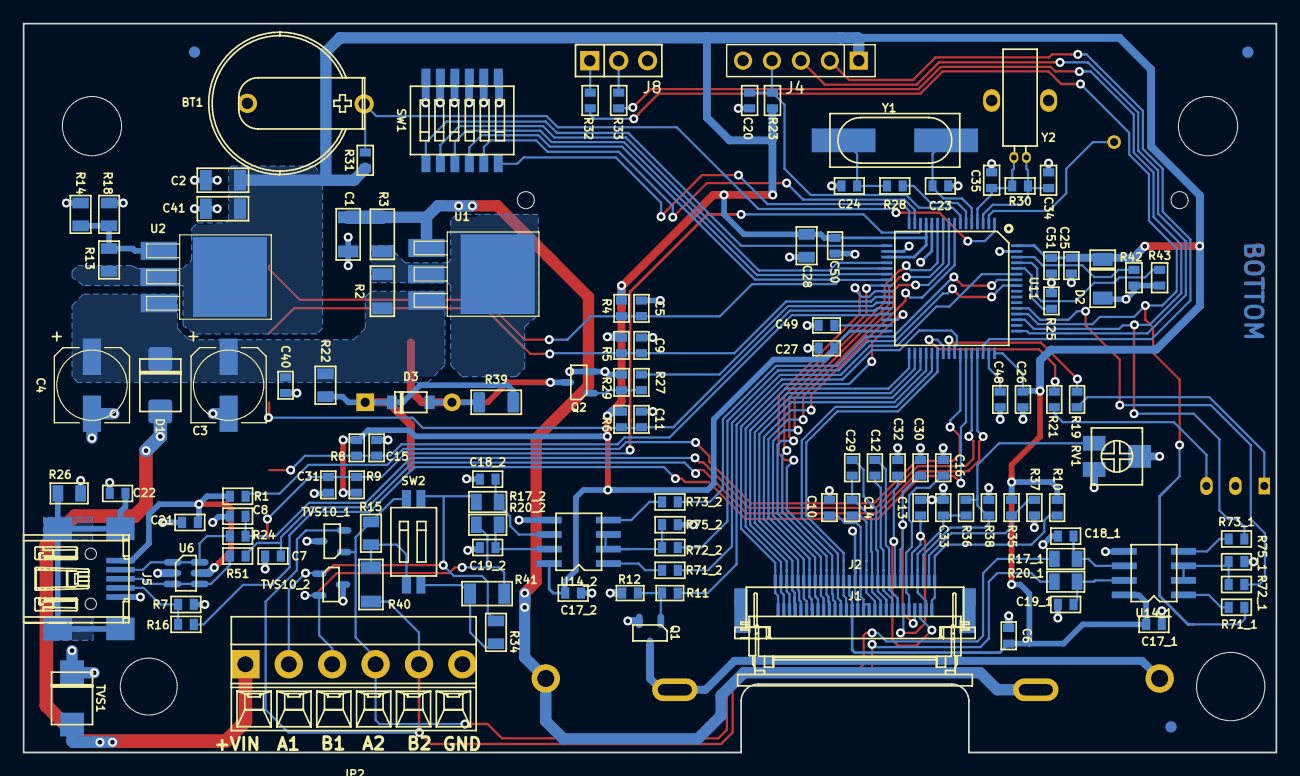
[picture p35: board C-0241-05.kicad_pcb from below]

Board: 2 copper layers, 110.0 x 64.0 mm, 135 parts (124 on the bottom side), 101 nets.

Parts:
BT1: CR-1220/HFN; CR1220_HFN
BZ1: LPT1230S-HL-03-4.0-1; KPEG242
BZ1A: LPT1230S-HL-03-4.0-1
C1, C2, C41: 10uF; C1206
C3, C4: 47uF; ELE-D-660
C5, C9, C11, C13, C15, C16, C20, C21, C22, C25, C26, C27, C30, C31, C32, C33, C40, C50, C51: 100nF; C0603
C6, C10, C12, C14, C17_1, C17_2, C29: 1uF; C0603
C7, C8, C23, C24, C34, C35: 12pF; C0603
C18_1, C18_2, C19_1, C19_2: 1nF; C0603
C28: 4.7uF; C0805
C48, C49: 2.2uF; C0603
D1: S2M; D_SMB_DO-214AA_AK
D2: 3.9VZ; D_MiniMELF_SOD80_AK
D3: 1N4148; D_SOD-123_AK
DISP1: G64128W20NBW00; CCT_G64128W20NBW00
DISP2: RX12864A1-BIW; RAYSTAR_RX12864A1-YHY
DL1: BILED; KINGBRIGHT_L-93WSURKCGKC_A1A2K
J1: 52437-2833; Molex_52437-2833
J2: 52435-2933; Molex_52435-2933_Special_Display_RX12864A1-YHY
J4: STRIP2.54-1X5-H11.6-M; SIX5
J5: 65100516121; WURTH_65100516121
J8: STRIP2.54-1X3-H11.6-M; SIX3
JP2: 691508110306; WURTH_691221320006
P1: PAD; PAD_1.2mm_H0.7mm
Q1, Q2: BC817; SOT-23
R1, R7, R16, R25, R31, R42, R43: 0; R0603
R2: 0; R1206
R3: 33; R1206
R4, R5, R6, R8, R9, R10, R12, R23, R29, R35, R37, R75_1, R75_2: 10K; R0603
R11, R27: 22K; R0603
R13: 470; R0805
R14, R18: 1.5K; R0805
R15, R34: 0; R0805
R17_1, R17_2, R20_1, R20_2: 4.7; R0805
R19, R21: 100; R0603
R22: 10; R0805
R24, R51: 10; R0603
R26: 1M; R0805
R28: 220; R0603
R30: 1M; R0603
R32, R33, R71_1, R71_2, R72_1, R72_2, R73_1, R73_2: 1K; R0603
R36: 1.8M; R0603
R38: 330K; R0603
R39: 2.2K; R1206
R40, R41: 120; R1206
RV1: 1M; BOURNS_3314J-1
S1, S2, S3, S4, S5: TVBM11
SW1: GDH06S04; TE_GDH06S04
SW2: GDH02S04; TE_GDH02S04
TVS1: SM6T18CA; D_SMB_DO-214AA
TVS10_1, TVS10_2: CDSOT23-SM712; SOT-23
U1, U2: LM1117IDTX-ADJ/NOPB; TO-252-3Lead_4TAB
U6: USBLC6-2SC6; SOT-23-6_SC74
U11: STM32F205RCT6; QFP-64_10x10mm_Pitch0.5mm
U14_1, U14_2: SN65HVD75D; SOIC-8_3.9x4.9mm_Pitch1.27mm
Y1: 12MHz; Crystal_SMD_HC49
Y2: 32.768kHz; AB38T_Horizontal_Reverse

Connections:
512Hz_OUT: P1.1, U11.2
BL-: DISP1.K, DISP2.K, Q1.3
BUZZER: R27.1, U11.27
C1+: C29.1, J1.20, J2.11
C1-: C14.1, C29.2, J1.19, J2.12
C2+: C12.1, J1.21, J2.10
C2-: C12.2, J1.22, J2.9
C3+: C14.2, J1.18, J2.13
DIP_1: SW1.1, U11.17
DIP_2: SW1.2, U11.20
DIP_3: SW1.3, U11.21
DIP_4: SW1.4, U11.22
DIP_5: SW1.5, U11.15
DIP_6: SW1.6, U11.16
GND: BT1.-, C1.2, C2.2, C3.2, C4.2, C5.1, C6.1, C7.2, C8.2, C9.1, C10.1, C11.1, C13.2, C15.1, C16.2, C17_1.2, C17_2.2, C18_1.2, C18_2.2, C19_1.2, C19_2.2, C20.2, C21.2, C22.2, C23.2, C24.2, C25.2, C26.2, C27.2, C28.2, C30.2, C31.1, C32.2, C33.2, C34.2, C35.2, C40.2, C41.2, C48.2, C49.2, C50.2, C51.2, D2.A, DL1.K, J1.15, J2.15, J4.5, J5.5, J8.3, JP2.6, Q1.2, Q2.2, R7.2, R12.2, R14.2, R18.2, R25.1, R26.2, R29.2, R37.1, R38.1, R42.2, R43.2, R75_1.2, R75_2.2, RV1.1, RV1.2, S1.1, S2.1, S3.1, S4.1, S5.1, SW1.7, SW1.8, SW1.9, SW1.10, SW1.11, SW1.12, TVS1.1, TVS10_1.3, TVS10_2.3, U6.2, U11.12, U11.18, U11.63, U14_1.5, U14_2.5
HW_SEL0: R43.1, U11.61
HW_SEL1: R42.1, U11.62
JTAG_RESET: C20.1, J4.4, R23.2, U11.7
JTAG_SWCLK: J4.3, U11.49
JTAG_SWDIO: J4.2, U11.46
LCD_CLR: J1.2, J2.28, U11.33
LCD_CS: J1.1, J2.29, U11.30
LCD_D0: J1.6, J2.24, U11.8
LCD_D1: J1.7, J2.23, U11.9
LCD_D2: J1.8, J2.22, U11.10
LCD_D3: J1.9, J2.21, U11.11
LCD_D4: J1.10, J2.20, U11.24
LCD_D5: J1.11, J2.19, U11.25
LCD_D6: J1.12, J2.18, U11.37
LCD_D7: J1.13, J2.17, U11.38
LCD_EN: J1.5, J2.25, U11.36
LCD_PWM: R11.1, U11.41
LCD_RS: J1.3, J2.27, U11.34
LCD_RW: J1.4, J2.26, U11.35
LED_R: R19.2, U11.40
LED_V: R21.2, U11.39
NetBT1_+: BT1.+, R31.1, U11.1
NetBZ1_1: BZ1.1, BZ1A.1, D3.K, R22.1, R39.1
NetBZ1_2: BZ1.2, BZ1A.2, D3.A, Q2.3, R39.2
NetC18_1_1: C18_1.1, R17_1.2, U14_1.6
NetC18_2_1: C18_2.1, R17_2.2, U14_2.6
NetC19_1_1: C19_1.1, R20_1.2, U14_1.7
NetC19_2_1: C19_2.1, R20_2.2, U14_2.7
NetC22_1: C22.1, J5.S, R26.1
NetC23_1: C23.1, U11.5, Y1.1
NetC24_1: C24.1, R28.2, Y1.2
NetC34_1: C34.1, R30.2, U11.3, Y2.1
NetC35_1: C35.1, R30.1, U11.4, Y2.2
NetC48_1: C48.1, U11.47
NetC49_1: C49.1, U11.31
NetDL1_A1: DL1.A1, R19.1
NetDL1_A2: DL1.A2, R21.1
NetJ2_2: J2.2, R35.1, R37.2
NetJ2_3: J2.3, R36.1, R38.2, RV1.3
NetJ5_4: J5.4, R7.1, R16.1
NetJ8_1: J8.1, R32.1
NetJ8_2: J8.2, R33.1
NetQ1_1: Q1.1, R11.2, R12.1
NetQ2_1: Q2.1, R27.2, R29.1
NetR1_2: R1.2, U11.42
NetR2_1: R2.1, R3.2, U1.2, U1.4
NetR13_2: R13.2, R14.1, R18.1, U2.1
NetR15_2: R15.2, R40.2, SW2.3
NetR25_2: R25.2, U11.60
NetR28_1: R28.1, U11.6
NetR34_2: R34.2, R41.2, SW2.4
NetR71_1_1: R71_1.1, U14_1.1
NetR71_2_1: R71_2.1, U14_2.1
NetR72_1_2: R72_1.2, R75_1.1, U14_1.2, U14_1.3
NetR72_2_2: R72_2.2, R75_2.1, U14_2.2, U14_2.3
NetR73_1_2: R73_1.2, U14_1.4
NetR73_2_2: R73_2.2, U14_2.4
PS: J1.28, J2.1, R10.1
RS485_A_1: JP2.4, R15.1, R17_1.1, SW2.2, TVS10_1.1
RS485_A_2: JP2.2, R17_2.1, R34.1, SW2.1, TVS10_2.1
RS485_B_1: JP2.5, R20_1.1, R40.1, TVS10_1.2
RS485_B_2: JP2.3, R20_2.1, R41.1, TVS10_2.2
RS485_DIR_1: R72_1.1, R72_2.1, U11.53, U11.57
RS485_RX_1: R32.2, R71_1.2, R71_2.2, U11.52, U11.59
RS485_TX_1: R33.2, R73_1.1, R73_2.1, U11.51, U11.58
SW1: C5.2, R4.2, S1.2, U11.23
SW2: C9.2, R5.2, S2.2, U11.26
SW3: C11.2, R6.2, S3.2, U11.28
SW4: C15.2, R8.2, S4.2, U11.29
SW5: C31.2, R9.2, S5.2, U11.14
USB_DN: C8.1, R24.1, U11.44
USB_DP: C7.1, R51.1, U11.45
USB_ID: R16.2, U11.43
USB_N: J5.2, R24.2, U6.1, U6.6
USB_P: J5.3, R51.2, U6.3, U6.4
V0: C33.1, J1.27, J2.4, R36.2
V1: C13.1, J1.23, J2.5
V2: C16.1, J1.24, J2.6
V3: C30.1, J1.25, J2.7
V4: C32.1, J1.26, J2.8
VCC_3V3: C2.1, C6.2, C17_1.1, C17_2.1, C25.1, C26.1, C27.1, C28.1, C41.1, C50.1, C51.1, D2.K, J1.14, J2.16, J4.1, R4.1, R5.1, R6.1, R8.1, R9.1, R10.2, R13.1, R23.1, R31.2, R35.2, U2.2, U2.4, U11.13, U11.19, U11.32, U11.48, U11.64, U14_1.8, U14_2.8
VCC_12V: C3.1, C4.1, C40.1, D1.K, R2.2, R22.2, U1.3, U2.3
VCC_ALIM: D1.A, JP2.1, TVS1.2
VCC_BACKLIGHT: C1.1, DISP1.A, DISP2.A, R3.1, U1.1
VCC_VUSB: C21.1, J5.1, R1.1, U6.5
VOUT: C10.2, J1.16, J1.17, J2.14
