Antonio-Tirri/Aspirnove/Aspirnova Scheda Motori S-283-00/Scheda motori Software sorgente  S-283-00 FW00055_016/FW00055_016/applic/temperature_sensor.c

#include "temperature_sensor.h"


typedef struct _tNTCCurve
{
	int16_t		Temperature; 	/**< Temperature in 0.1°C */
	uint16_t 	Count; 			/**< Count */

} tNTCCurve;

#define NTC_LENGTH		106

// TEMPERATURE_SENSOR_TYPE_NTC_10K_3435
static const tNTCCurve NTC_10K_3435_ntc[NTC_LENGTH] =
{
		{-250, 15547  },
		{-240, 15506 },
		{-230, 15464 },
		{-220, 15421 },
		{-210, 15376 },
		{-200, 15329 },
		{-190, 15280 },
		{-180, 15229 },
		{-170, 15177 },
		{-160, 15123 },
		{-150, 15067 },
		{-140, 15009 },
		{-130, 14949 },
		{-120, 14887 },
		{-110, 14823 },
		{-100, 14757 },
		{-90, 14689 },
		{-80, 14619 },
		{-70, 14547 },
		{-60, 14473 },
		{-50, 14396 },
		{-40, 14318 },
		{-30, 14237 },
		{-20, 14154 },
		{-10, 14069 },
		{0, 13981 },
		{10, 13892 },
		{20, 13800 },
		{30, 13706 },
		{40, 13610 },
		{50, 13512 },
		{60, 13411 },
		{70, 13309 },
		{80, 13204 },
		{90, 13097 },
		{100, 12989 },
		{110, 12878 },
		{120, 12765 },
		{130, 12651 },
		{140, 12534 },
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

};





int16_t TemperatureSensor_Convert(uint8_t type, int16_t value)
{
    uint16_t i;

    tNTCCurve *ntc;

    switch (type)
    {
    	default:
    	case (TEMPERATURE_SENSOR_TYPE_NTC_10K_3435):
			ntc = (tNTCCurve *)NTC_10K_3435_ntc;
    	break;

    }

    /*

	if (value <= ntc[0].Count)
	{
		// Temperatura minima
		return ntc[0].Temperature;
	}


    for (i = 0; i < NTC_LENGTH - 1; i++)
    {
        if (value < ntc[i+1].Count)
        {
            return ( ntc[i].Temperature + (int16_t)((int32_t)(ntc[i + 1].Temperature - ntc[i].Temperature) *
            		(int32_t)(value - ntc[i].Count)) / (int32_t)(ntc[i + 1].Count - ntc[i].Count));
        }
    }
*/

	if (value >= ntc[0].Count)
	{
		// Temperatura minima
		return ntc[0].Temperature;
	}


    for (i = 0; i < NTC_LENGTH - 1; i++)
    {
        if (value > ntc[i+1].Count)
        {
            return ( ntc[i+1].Temperature + (int16_t)((int32_t)(ntc[i].Temperature - ntc[i+1].Temperature) *
            		(int32_t)(value - ntc[i+1].Count)) / (int32_t)(ntc[i].Count - ntc[i+1].Count));
        }
    }

    // Temperatura massima
    return ntc[i].Temperature;
}
