Antonio-Tirri/Aspirnove/Display BW S-0241-02/Display Sorgenti Software BW S-0241-02 FW00054_012/FW00054_012/applic/img.c

#include "windows.h"


// Strutture generate con LCDIcon 
// - aprire bmp monocromatica con LCDIcon 
// - cliccare su icona bianconera in alto a sx e selezionare C source
// - fare Save Pixel file as, selezionare C source (*.h) e salvare in un file temporaneo
// - copiare matrice generata in una nuova struttura sottostante


const struct
{
	GSYMHEAD sh;
	SGUCHAR  b[1024];
} Logo = {{128, 64},{
0x00,0x00,0x00,0x00,0x00,0x00,0x00,0x00,  /*  ................................................................  */
0x00,0x00,0x00,0x00,0x00,0x00,0x00,0x00,  /*  ................................................................  */
0x00,0x00,0x00,0x00,0x00,0x00,0x00,0x00,  /*  ................................................................  */
0x00,0x00,0x00,0x00,0x00,0x00,0x00,0x00,  /*  ................................................................  */
0x00,0x00,0x00,0x00,0x00,0x00,0x00,0x00,  /*  ................................................................  */
0x00,0x00,0x00,0x00,0x00,0x00,0x00,0x00,  /*  ................................................................  */
0x00,0x00,0x00,0x00,0x00,0x00,0x00,0x00,  /*  ................................................................  */
0x00,0x00,0x00,0x00,0x00,0x00,0x00,0x00,  /*  ................................................................  */
0x00,0x00,0x00,0x00,0x00,0x00,0x00,0x00,  /*  ................................................................  */
0x00,0x00,0x00,0x00,0x00,0x00,0x00,0x00,  /*  ................................................................  */
0x00,0x00,0x00,0x00,0x00,0x00,0x00,0x00,  /*  ................................................................  */
0x00,0x00,0x00,0x00,0x00,0x00,0x00,0x00,  /*  ................................................................  */
0x00,0x00,0x00,0x00,0x00,0x00,0x00,0x00,  /*  ................................................................  */
0x00,0x00,0x00,0x00,0x00,0x00,0x00,0x00,  /*  ................................................................  */
0x00,0x00,0x00,0x00,0x00,0x00,0x00,0x00,  /*  ................................................................  */
0x00,0x00,0x00,0x00,0x00,0x00,0x00,0x00,  /*  ................................................................  */
0x00,0x00,0x00,0x00,0x00,0x00,0x00,0x00,  /*  ................................................................  */
0x00,0x00,0x00,0x00,0x00,0x00,0x00,0x00,  /*  ................................................................  */
0x00,0x00,0x00,0x00,0x00,0x00,0x00,0x00,  /*  ................................................................  */
0x00,0x00,0x00,0x00,0x00,0x00,0x00,0x00,  /*  ................................................................  */
0x00,0x00,0x00,0x00,0x00,0x00,0x00,0x00,  /*  ................................................................  */
0x00,0x00,0x00,0x00,0x00,0x00,0x00,0x00,  /*  ................................................................  */
0x00,0x07,0x80,0x00,0x00,0x00,0x00,0x00,  /*  .............%%%%...............................................  */
0x00,0x00,0x00,0x00,0x00,0x00,0x00,0x00,  /*  ................................................................  */
0x00,0x0F,0xC0,0x00,0x00,0x00,0x00,0x00,  /*  ............%%%%%%..............................................  */
0x00,0x00,0x00,0x00,0x00,0x00,0x00,0x00,  /*  ................................................................  */
0x00,0x0F,0xC0,0x00,0x00,0x00,0x00,0x00,  /*  ............%%%%%%..............................................  */
0x00,0x00,0x00,0x00,0x00,0x00,0x00,0x00,  /*  ................................................................  */
0x00,0x0F,0xE0,0x00,0x00,0x00,0x00,0x00,  /*  ............%%%%%%%.............................................  */
0x00,0x00,0x00,0x00,0x00,0x00,0x00,0x00,  /*  ................................................................  */
0x00,0x1F,0xE0,0x1F,0xF8,0xFF,0xC3,0xC3,  /*  ...........%%%%%%%%........%%%%%%%%%%...%%%%%%%%%%....%%%%....%%  */
0xE3,0xFF,0x07,0xFC,0x78,0x0F,0x3F,0xF0,  /*  %%%...%%%%%%%%%%.....%%%%%%%%%...%%%%.......%%%%..%%%%%%%%%%....  */
0x00,0x1F,0xE0,0x3F,0xF8,0xFF,0xE3,0xC7,  /*  ...........%%%%%%%%.......%%%%%%%%%%%...%%%%%%%%%%%...%%%%...%%%  */
0xE7,0xFF,0x0F,0xFE,0x38,0x0E,0x3F,0xF8,  /*  %%%..%%%%%%%%%%%....%%%%%%%%%%%...%%%.......%%%...%%%%%%%%%%%...  */
0x00,0x1C,0xF0,0x3F,0xF9,0xFF,0xE3,0xCF,  /*  ...........%%%..%%%%......%%%%%%%%%%%..%%%%%%%%%%%%...%%%%..%%%%  */
0xE7,0xFF,0x9F,0xFF,0x3C,0x1E,0x3F,0xF8,  /*  %%%..%%%%%%%%%%%%..%%%%%%%%%%%%%..%%%%.....%%%%...%%%%%%%%%%%...  */
0x00,0x3C,0xF0,0x38,0x01,0xE1,0xF3,0xCF,  /*  ..........%%%%..%%%%......%%%..........%%%%....%%%%%..%%%%..%%%%  */
0x0F,0x07,0x9E,0x0F,0x3C,0x1C,0x00,0x38,  /*  ....%%%%.....%%%%..%%%%.....%%%%..%%%%.....%%%............%%%...  */
0x00,0x3C,0xF0,0x38,0x01,0xE0,0xF3,0xCF,  /*  ..........%%%%..%%%%......%%%..........%%%%.....%%%%..%%%%..%%%%  */
0x0F,0x07,0x9E,0x0F,0x1C,0x1C,0x00,0x38,  /*  ....%%%%.....%%%%..%%%%.....%%%%...%%%.....%%%............%%%...  */
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
}
};	




const struct
{
	GSYMHEAD sh;
	SGUCHAR  b[64];
} Ice =
		{{16, 16},{
				0x00,0x00,  /*  ................  */
				0x05,0x40,  /*  .....%.%.%......  */
				0x22,0x88,  /*  ..%...%.%...%...  */
				0x69,0x2C,  /*  .%%.%..%..%.%%..  */
				0x11,0x10,  /*  ...%...%...%....  */
				0x2B,0xA8,  /*  ..%.%.%%%.%.%...  */
				0x87,0xC2,  /*  %....%%%%%....%.  */
				0x4F,0xE4,  /*  .%..%%%%%%%..%..  */
				0xBF,0xFA,  /*  %.%%%%%%%%%%%.%.  */
				0x4F,0xE4,  /*  .%..%%%%%%%..%..  */
				0x87,0xC2,  /*  %....%%%%%....%.  */
				0x2B,0xA8,  /*  ..%.%.%%%.%.%...  */
				0x11,0x10,  /*  ...%...%...%....  */
				0x69,0x2C,  /*  .%%.%..%..%.%%..  */
				0x22,0x88,  /*  ..%...%.%...%...  */
				0x05,0x40   /*  .....%.%.%......  */
		}};



const struct
{
	GSYMHEAD sh;
	SGUCHAR  b[64];
} Sun =
		{{16, 16},{
				0x00,0x00,  /*  ................  */
				0x01,0x00,  /*  .......%........  */
				0x01,0x00,  /*  .......%........  */
				0x23,0x88,  /*  ..%...%%%...%...  */
				0x18,0x30,  /*  ...%%.....%%....  */
				0x13,0x90,  /*  ...%..%%%..%....  */
				0x07,0xC0,  /*  .....%%%%%......  */
				0x2F,0xE8,  /*  ..%.%%%%%%%.%...  */
				0xEF,0xEE,  /*  %%%.%%%%%%%.%%%.  */
				0x2F,0xE8,  /*  ..%.%%%%%%%.%...  */
				0x07,0xC0,  /*  .....%%%%%......  */
				0x13,0x90,  /*  ...%..%%%..%....  */
				0x18,0x30,  /*  ...%%.....%%....  */
				0x23,0x88,  /*  ..%...%%%...%...  */
				0x01,0x00,  /*  .......%........  */
				0x01,0x00   /*  .......%........  */
		}};


const struct
{
	GSYMHEAD sh;
	SGUCHAR  b[64];
} Vuota16x16 =
		{{16, 16},{
				0x00,0x00,  /*  ................  */
				0x00,0x00,  /*  ................  */
				0x00,0x00,  /*  ................  */
				0x00,0x00,  /*  ................  */
				0x00,0x00,  /*  ................  */
				0x00,0x00,  /*  ................  */
				0x00,0x00,  /*  ................  */
				0x00,0x00,  /*  ................  */
				0x00,0x00,  /*  ................  */
				0x00,0x00,  /*  ................  */
				0x00,0x00,  /*  ................  */
				0x00,0x00,  /*  ................  */
				0x00,0x00,  /*  ................  */
				0x00,0x00,  /*  ................  */
				0x00,0x00,  /*  ................  */
				0x00,0x00,  /*  ................  */
		}};


const struct
{
	GSYMHEAD sh;
	SGUCHAR  b[64];
} SterilizerOn =
		{{16, 16},{
				0x20,0x00,  /*  ..%.............  */
				0x13,0xC0,  /*  ...%..%%%%......  */
				0x0C,0x20,  /*  ....%%....%.....  */
				0x0C,0x10,  /*  ....%%.....%....  */
				0x13,0x68,  /*  ...%..%%.%%.%...  */
				0x13,0x68,  /*  ...%..%%.%%.%...  */
				0x10,0x88,  /*  ...%....%...%...  */
				0x11,0xC8,  /*  ...%...%%%..%...  */
				0x09,0xD0,  /*  ....%..%%%.%....  */
				0x04,0x30,  /*  .....%....%%....  */
				0x03,0xC8,  /*  ......%%%%..%...  */
				0x00,0x04,  /*  .............%..  */
				0x0E,0x90,  /*  ....%%%.%..%....  */
				0x0A,0xD0,  /*  ....%.%.%%.%....  */
				0x0A,0xB0,  /*  ....%.%.%.%%....  */
				0x0E,0x90   /*  ....%%%.%..%....  */
		}};


const struct
{
	GSYMHEAD sh;
	SGUCHAR  b[64];
} SterilizerOff =
		{{16, 16},{
				0x20,0x00,  /*  ..%.............  */
				0x13,0xC0,  /*  ...%..%%%%......  */
				0x0C,0x20,  /*  ....%%....%.....  */
				0x0C,0x10,  /*  ....%%.....%....  */
				0x13,0x68,  /*  ...%..%%.%%.%...  */
				0x13,0x68,  /*  ...%..%%.%%.%...  */
				0x10,0x88,  /*  ...%....%...%...  */
				0x11,0xC8,  /*  ...%...%%%..%...  */
				0x09,0xD0,  /*  ....%..%%%.%....  */
				0x04,0x30,  /*  .....%....%%....  */
				0x03,0xC8,  /*  ......%%%%..%...  */
				0x00,0x04,  /*  .............%..  */
				0x3B,0xB8,  /*  ..%%%.%%%.%%%...  */
				0x2A,0x20,  /*  ..%.%.%...%.....  */
				0x2B,0x30,  /*  ..%.%.%%..%%....  */
				0x3A,0x20   /*  ..%%%.%...%.....  */
		}};


const struct
{
	GSYMHEAD sh;
	SGUCHAR  b[64];
} Humidity =
		{{16, 16},{
				0x00,0x00,  /*  ................  */
				0x01,0x80,  /*  .......%%.......  */
				0x03,0xC0,  /*  ......%%%%......  */
				0x04,0x20,  /*  .....%....%.....  */
				0x0C,0x30,  /*  ....%%....%%....  */
				0x08,0x10,  /*  ....%......%....  */
				0x18,0x18,  /*  ...%%......%%...  */
				0x32,0x4C,  /*  ..%%..%..%..%%..  */
				0x20,0xC4,  /*  ..%.....%%...%..  */
				0x21,0x84,  /*  ..%....%%....%..  */
				0x31,0x0C,  /*  ..%%...%....%%..  */
				0x12,0x48,  /*  ...%..%..%..%...  */
				0x10,0x18,  /*  ...%.......%%...  */
				0x0C,0x30,  /*  ....%%....%%....  */
				0x07,0xE0,  /*  .....%%%%%%.....  */
				0x00,0x00   /*  ................  */
		}};



const struct
{
	GSYMHEAD sh;
	SGUCHAR  b[64];
} Termostato =
		{{16, 16},{
				0x00,0x00,  /*  ................  */
				0x01,0x80,  /*  .......%%.......  */
				0x02,0x40,  /*  ......%..%......  */
				0x02,0x40,  /*  ......%..%......  */
				0x02,0xC0,  /*  ......%.%%......  */
				0x02,0x40,  /*  ......%..%......  */
				0x02,0xC0,  /*  ......%.%%......  */
				0x02,0x40,  /*  ......%..%......  */
				0x02,0xC0,  /*  ......%.%%......  */
				0x04,0x20,  /*  .....%....%.....  */
				0x08,0x10,  /*  ....%......%....  */
				0x08,0x10,  /*  ....%......%....  */
				0x08,0x10,  /*  ....%......%....  */
				0x04,0x20,  /*  .....%....%.....  */
				0x03,0xC0,  /*  ......%%%%......  */
				0x00,0x00   /*  ................  */
		}};


const struct
{
	GSYMHEAD sh;
	SGUCHAR  b[40];
} Ext =
		{{16, 20},{
				0x00,0xFE,  /*  ........%%%%%%%.  */
				0x00,0xFF,  /*  ........%%%%%%%%  */
				0x00,0x03,  /*  ..............%%  */
				0x00,0x03,  /*  ..............%%  */
				0x06,0x03,  /*  .....%%.......%%  */
				0x07,0x03,  /*  .....%%%......%%  */
				0x03,0x83,  /*  ......%%%.....%%  */
				0x01,0xC3,  /*  .......%%%....%%  */
				0x00,0xE3,  /*  ........%%%...%%  */
				0xFF,0xF3,  /*  %%%%%%%%%%%%..%%  */
				0xFF,0xF3,  /*  %%%%%%%%%%%%..%%  */
				0x00,0xE3,  /*  ........%%%...%%  */
				0x01,0xC3,  /*  .......%%%....%%  */
				0x03,0x83,  /*  ......%%%.....%%  */
				0x07,0x03,  /*  .....%%%......%%  */
				0x06,0x03,  /*  .....%%.......%%  */
				0x00,0x03,  /*  ..............%%  */
				0x00,0x03,  /*  ..............%%  */
				0x00,0xFF,  /*  ........%%%%%%%%  */
				0x00,0xFE   /*  ........%%%%%%%.  */
		}};

const struct
{
	GSYMHEAD sh;
	SGUCHAR  b[40];
} Int =
		{{16, 20},{
				0x7F,0x00,  /*  .%%%%%%%........  */
				0xFF,0x00,  /*  %%%%%%%%........  */
				0xC0,0x00,  /*  %%..............  */
				0xC0,0x00,  /*  %%..............  */
				0xC0,0x60,  /*  %%.......%%.....  */
				0xC0,0xE0,  /*  %%......%%%.....  */
				0xC1,0xC0,  /*  %%.....%%%......  */
				0xC3,0x80,  /*  %%....%%%.......  */
				0xC7,0x00,  /*  %%...%%%........  */
				0xCF,0xFF,  /*  %%..%%%%%%%%%%%%  */
				0xCF,0xFF,  /*  %%..%%%%%%%%%%%%  */
				0xC7,0x00,  /*  %%...%%%........  */
				0xC3,0x80,  /*  %%....%%%.......  */
				0xC1,0xC0,  /*  %%.....%%%......  */
				0xC0,0xE0,  /*  %%......%%%.....  */
				0xC0,0x60,  /*  %%.......%%.....  */
				0xC0,0x00,  /*  %%..............  */
				0xC0,0x00,  /*  %%..............  */
				0xFF,0x00,  /*  %%%%%%%%........  */
				0x7F,0x00   /*  .%%%%%%%........  */
		}};


const struct
{
	GSYMHEAD sh;
	SGUCHAR  b[64];
} Co2 =
		{{16, 16},{
				0x00,0x00,  /*  ................  */
				0x00,0x00,  /*  ................  */
				0x00,0x00,  /*  ................  */
				0x1C,0xC0,  /*  ...%%%..%%......  */
				0x21,0x20,  /*  ..%....%..%.....  */
				0x42,0x10,  /*  .%....%....%....  */
				0x42,0x10,  /*  .%....%....%....  */
				0x42,0x10,  /*  .%....%....%....  */
				0x42,0x10,  /*  .%....%....%....  */
				0x21,0x24,  /*  ..%....%..%..%..  */
				0x1C,0xCA,  /*  ...%%%..%%..%.%.  */
				0x00,0x02,  /*  ..............%.  */
				0x00,0x04,  /*  .............%..  */
				0x00,0x0E,  /*  ............%%%.  */
				0x00,0x00,  /*  ................  */
				0x00,0x00   /*  ................  */
		}};


const struct
{
	GSYMHEAD sh;
	SGUCHAR  b[64];
} Man =
		{{16, 16},{
				0x00,0x00,  /*  ................  */
				0x01,0xC0,  /*  .......%%%......  */
				0x06,0xA0,  /*  .....%%.%.%.....  */
				0x0A,0xB0,  /*  ....%.%.%.%%....  */
				0x0A,0xA8,  /*  ....%.%.%.%.%...  */
				0x0A,0xA8,  /*  ....%.%.%.%.%...  */
				0x0A,0xA8,  /*  ....%.%.%.%.%...  */
				0x2A,0xA8,  /*  ..%.%.%.%.%.%...  */
				0x58,0x28,  /*  .%.%%.....%.%...  */
				0x48,0x08,  /*  .%..%.......%...  */
				0x20,0x08,  /*  ..%.........%...  */
				0x10,0x08,  /*  ...%........%...  */
				0x08,0x08,  /*  ....%.......%...  */
				0x04,0x10,  /*  .....%.....%....  */
				0x03,0xE0,  /*  ......%%%%%.....  */
				0x00,0x00   /*  ................  */
		}};

const struct
{
	GSYMHEAD sh;
	SGUCHAR  b[64];
} Auto =
		{{16, 16},{
				0x00,0x00,  /*  ................  */
				0x07,0xE0,  /*  .....%%%%%%.....  */
				0x08,0x10,  /*  ....%......%....  */
				0x10,0x08,  /*  ...%........%...  */
				0x21,0x84,  /*  ..%....%%....%..  */
				0x43,0xC2,  /*  .%....%%%%....%.  */
				0x42,0x42,  /*  .%....%..%....%.  */
				0x46,0x62,  /*  .%...%%..%%...%.  */
				0x47,0xE2,  /*  .%...%%%%%%...%.  */
				0x4C,0x32,  /*  .%..%%....%%..%.  */
				0x48,0x12,  /*  .%..%......%..%.  */
				0x20,0x04,  /*  ..%..........%..  */
				0x10,0x08,  /*  ...%........%...  */
				0x08,0x10,  /*  ....%......%....  */
				0x07,0xE0,  /*  .....%%%%%%.....  */
				0x00,0x00   /*  ................  */
		}};

const struct
{
	GSYMHEAD sh;
	SGUCHAR  b[64];
} Schedule =
		{{16, 16},{
				0x00,0x00,  /*  ................  */
				0x00,0x00,  /*  ................  */
				0x03,0xE0,  /*  ......%%%%%.....  */
				0x0C,0x18,  /*  ....%%.....%%...  */
				0x10,0x84,  /*  ...%....%....%..  */
				0x14,0x84,  /*  ...%.%..%....%..  */
				0x20,0xA2,  /*  ..%.....%.%...%.  */
				0x20,0xC2,  /*  ..%.....%%....%.  */
				0x28,0x8A,  /*  ..%.%...%...%.%.  */
				0x20,0x02,  /*  ..%...........%.  */
				0x20,0x02,  /*  ..%...........%.  */
				0x14,0x14,  /*  ...%.%.....%.%..  */
				0x10,0x84,  /*  ...%....%....%..  */
				0x0C,0x18,  /*  ....%%.....%%...  */
				0x03,0xE0,  /*  ......%%%%%.....  */
				0x00,0x00   /*  ................  */
		}};


const struct
{
	GSYMHEAD sh;
	SGUCHAR  b[64];
} ButtonOn =
		{{16, 16},{
				0x00,0x00,  /*  ................  */
				0x00,0x00,  /*  ................  */
				0x00,0x80,  /*  ........%.......  */
				0x0C,0x98,  /*  ....%%..%..%%...  */
				0x10,0x84,  /*  ...%....%....%..  */
				0x10,0x84,  /*  ...%....%....%..  */
				0x20,0x82,  /*  ..%.....%.....%.  */
				0x20,0x02,  /*  ..%...........%.  */
				0x20,0x02,  /*  ..%...........%.  */
				0x20,0x02,  /*  ..%...........%.  */
				0x20,0x02,  /*  ..%...........%.  */
				0x10,0x04,  /*  ...%.........%..  */
				0x10,0x04,  /*  ...%.........%..  */
				0x0C,0x18,  /*  ....%%.....%%...  */
				0x03,0xE0,  /*  ......%%%%%.....  */
				0x00,0x00   /*  ................  */
		}};



const struct
{
	GSYMHEAD sh;
	SGUCHAR  b[64];
} Serpentina =
		{{16, 16},{
				0x00,0x00,  /*  ................  */
				0x02,0x20,  /*  ......%...%.....  */
				0x05,0x50,  /*  .....%.%.%.%....  */
				0x25,0x50,  /*  ..%..%.%.%.%....  */
				0x55,0x54,  /*  .%.%.%.%.%.%.%..  */
				0x55,0x54,  /*  .%.%.%.%.%.%.%..  */
				0x55,0x54,  /*  .%.%.%.%.%.%.%..  */
				0x55,0x54,  /*  .%.%.%.%.%.%.%..  */
				0x15,0x54,  /*  ...%.%.%.%.%.%..  */
				0x15,0x54,  /*  ...%.%.%.%.%.%..  */
				0x09,0x48,  /*  ....%..%.%..%...  */
				0x01,0x40,  /*  .......%.%......  */
				0x00,0x80,  /*  ........%.......  */
				0x00,0x00,  /*  ................  */
				0x00,0x00,  /*  ................  */
				0x00,0x00   /*  ................  */
		}};


const struct
{
	GSYMHEAD sh;
	SGUCHAR  b[64];
} BypassOff =
		{{16, 16},{
				0x00,0x00,  /*  ................  */
				0x00,0x00,  /*  ................  */
				0x00,0x80,  /*  ........%.......  */
				0x71,0x47,  /*  .%%%...%.%...%%%  */
				0x0A,0x28,  /*  ....%.%...%.%...  */
				0x04,0x10,  /*  .....%.....%....  */
				0x0A,0x28,  /*  ....%.%...%.%...  */
				0x11,0x44,  /*  ...%...%.%...%..  */
				0x20,0x82,  /*  ..%.....%.....%.  */
				0x11,0x44,  /*  ...%...%.%...%..  */
				0x0A,0x28,  /*  ....%.%...%.%...  */
				0x04,0x10,  /*  .....%.....%....  */
				0x2A,0x2A,  /*  ..%.%.%...%.%.%.  */
				0x31,0x46,  /*  ..%%...%.%...%%.  */
				0x38,0x8E,  /*  ..%%%...%...%%%.  */
				0x00,0x00   /*  ................  */
		}};


const struct
{
	GSYMHEAD sh;
	SGUCHAR  b[64];
} Bell =
		{{16, 16},{
				0x01,0x80,  /*  .......%%.......  */
				0x03,0xC0,  /*  ......%%%%......  */
				0x04,0x20,  /*  .....%....%.....  */
				0x08,0x00,  /*  ....%...........  */
				0x08,0x10,  /*  ....%......%....  */
				0x08,0x10,  /*  ....%......%....  */
				0x08,0x00,  /*  ....%...........  */
				0x08,0x10,  /*  ....%......%....  */
				0x10,0x08,  /*  ...%........%...  */
				0x10,0x08,  /*  ...%........%...  */
				0x20,0x04,  /*  ..%..........%..  */
				0x40,0x02,  /*  .%............%.  */
				0x3F,0xFC,  /*  ..%%%%%%%%%%%%..  */
				0x03,0xC0,  /*  ......%%%%......  */
				0x01,0x80,  /*  .......%%.......  */
				0x00,0x00   /*  ................  */
		}};
