Antonio-Tirri/Aspirnove/Display BW S-0241-02/Display Sorgenti Software BW S-0241-02 FW00054_012/FW00054_012/applic/glcd/ks07xx/singlchp/bussim.c

/***************************** bussim.c ************************************

   Generic template file for external bus simulator drivers.

   The functions bodies below must be implemented as described in the comments.
   Use the proper I/O port instructions given by the actual processor
   architecture, the actual LCD connection method and the I/O access
   capabilities of the target C compiler.

   Alternatively this module can be used as a universal stub during initial
   test compilation of the target software.

   The functions in this module is called by single-chip-processor version
   of the ghwinit.c module.

   Copyright (c) RAMTEX Engineering Aps 1998

****************************************************************************/
#ifndef GHW_NOHDW
#ifdef  GHW_SINGLE_CHIP

#include <bussim.h>
#include "board.h"


/*#include < Port declaration file for your compiler > */

/*
   Simulate a bus write operation for a LCD controller with an Intel
   like bus interface (i.e. use of separate /RD and /WR strobes).

   The address parameter adr is assumed to be either 0 or 1.
*/
void simwrby(SGUCHAR adr, SGUCHAR dat)
   {
   /* A: Set C/D line according to adr, Set /CE line active low */
   /* B1: Make data port an output (if required by port architecture) */
   /* B2: Write data to data port */
   /* C: Set /WR active low, (Delay min 80 ns), */
   /* D: Set /WR passive high */
   /* E: Set /CE passive high */
  switch(adr) 
    {
        case GHWWR:                    /*Graphic LCD chip 0 data write     */   
          RW(0); 		                   /* Read - write display             */
          RS(1); 			/* Dati - comandi display           */
          CS(0);          /* Chip select 0 display            */
          DELAY_200n;
          DELAY_200n;
          DELAY_200n;
          DELAY_200n;
          DELAY_200n;
          LCD_DATA_D(1);  /* Direzione dati                   */
          LCD_DATA = dat;
          EN(1);  			/* Enable display                   */
          DELAY_500n;
          DELAY_500n;
          DELAY_500n;
          DELAY_500n;
          EN(0);  			/* Enable display                   */
          CS(1);          /* Chip select 0 display            */
          break;                   
        case GHWCMD:                   /*Graphic LCD chip 0 command write  */
          RW(0); 			/* Read - write display             */
          RS(0); 			/* Dati - comandi display           */
          CS(0);          /* Chip select 0 display            */
          DELAY_200n;
          DELAY_200n;
          DELAY_200n;
          DELAY_200n;
          DELAY_200n;
          LCD_DATA_D(1);  /* Direzione dati                   */
          LCD_DATA = dat;
          EN(1);  			/* Enable display                   */
          DELAY_500n;
          DELAY_500n;
          DELAY_500n;
          DELAY_500n;
          DELAY_500n;
          EN(0);  			/* Enable display                   */
          CS(1);          /* Chip select 0 display            */
          break;                   
               
        default:
            break;                   
    }           

   }

/*
   Simulate a bus read operation for a LCD controller with an Intel
   like bus interface (i.e. use of separate /RD and /WR strobes).

   The address parameter adr is assumed to be either 0 or 1.
*/
SGUCHAR simrdby(SGUCHAR adr)
 {
   SGUCHAR dat = 0;

    switch(adr) 
    {
        case GHWRD:                    /*Graphic LCD chip 0 data read      */
                    RW(1); 			/* Read - write display             */
                    RS(1); 			/* Dati - comandi display           */
                    CS(0);          /* Chip select 0 display            */
                    DELAY_200n;
                    LCD_DATA_D(0);  /* Direzione dati                   */
                    EN(0);  			/* Enable display                   */
                    DELAY_500n;
                    DELAY_500n;
                    DELAY_500n;
                    DELAY_500n;
                    DELAY_500n;
                    DELAY_500n;
                    DELAY_500n;
                    DELAY_500n;
                    DELAY_500n;
                    DELAY_500n;
                    DELAY_500n;
                    DELAY_500n;
                    dat = LCD_DATA;
                    EN(1);  			/* Enable display                   */
                    CS(1);          /* Chip select 0 display            */
                    break;                   
        case GHWSTA:                   /*Graphic LCD chip 0 status read    */
                    RW(1); 			/* Read - write display             */
                    RS(0); 			/* Dati - comandi display           */
                    CS(0);          /* Chip select 0 display            */
                    DELAY_200n;
                    LCD_DATA_D(0);  /* Direzione dati                   */
                    EN(0);  			/* Enable display                   */
                    DELAY_1u;
                    DELAY_1u;
                    DELAY_1u;
                    DELAY_500n;
                    DELAY_500n;
                    DELAY_500n;
                    DELAY_500n;
                    DELAY_500n;
                    DELAY_500n;
                    DELAY_500n;
                    DELAY_500n;
                    DELAY_500n;
                    dat = LCD_DATA;
                    EN(1);  			/* Enable display                   */
                    CS(1);          /* Chip select 0 display            */
                   break;                   
         default:
          break;
   }
   /* a: Set C/D line according to adr. Set /CE line active low */
   /* b: Make data port an input (if required by port architecture) */
   /* c: Set /RD active low, (Delay min 150ns), */
   /* d: Read data from data port */
   /* e1:Set /RD passive high, */
   /* e2:Set /CE passive high (could be ignored) */
   return dat;
   
 }
/*
  Initialize and reset LCD display.
  Is called before simwrby() and simrdby() is invoked for the first time

  The SED1335 reset line is toggled here if it connected to a bus port.
  (it may alternatively be hard-wired to the reset signal to the processors
  in the target system).

  The sim_reset() function is invoked automatically via the ginit() function.
*/
void sim_reset( void )
   {
   /* 1. Init data port setup (if required by port architecture) */
   /* 2. Make C/D, /RD, /WR, /CE to outputs (if required by port architecture) */
   /* 3. Set LCD reset line /RST active low   (if /RST is connected to a port bit) */
   /* 4. Set LCD reset line /RST passive high (if /RST is connected to a port bit) */

     //CS(0);
     RES(0);
     DELAY_2u;
     DELAY_2u;
     DELAY_2u;
     DELAY_2u;
     DELAY_2u;
     DELAY_2u; 
     RES(1);
     DELAY_2u;

     //RS(0);
   }

#endif /* GHW_SINGLE_CHIP */
#endif /* GHW_NOHDW */
