Antonio-Tirri/Aspirnove/Aspirnova Scheda Motori S-283-00/Scheda motori Software sorgente  S-283-00 FW00055_016/FW00055_016/Src/rtc.c

/**
  ******************************************************************************
  * File Name          : RTC.c
  * Description        : This file provides code for the configuration
  *                      of the RTC instances.
  ******************************************************************************
  * @attention
  *
  * <h2><center>&copy; Copyright (c) 2020 STMicroelectronics.
  * All rights reserved.</center></h2>
  *
  * This software component is licensed by ST under Ultimate Liberty license
  * SLA0044, the "License"; You may not use this file except in compliance with
  * the License. You may obtain a copy of the License at:
  *                             www.st.com/SLA0044
  *
  ******************************************************************************
  */

/* Includes ------------------------------------------------------------------*/
#include "rtc.h"

RTC_HandleTypeDef hrtc;

/* RTC init function */
void MX_RTC_Init(void)
{

  /** Initialize RTC Only 
  */
  hrtc.Instance = RTC;
  hrtc.Init.HourFormat = RTC_HOURFORMAT_24;
  hrtc.Init.AsynchPrediv = 127;
  hrtc.Init.SynchPrediv = 255;
  hrtc.Init.OutPut = RTC_OUTPUT_DISABLE;
  hrtc.Init.OutPutPolarity = RTC_OUTPUT_POLARITY_HIGH;
  hrtc.Init.OutPutType = RTC_OUTPUT_TYPE_OPENDRAIN;
  if (HAL_RTC_Init(&hrtc) != HAL_OK)
  {
    Error_Handler();
  }
  /** Enable Calibrartion 
  */
  if (HAL_RTCEx_SetCalibrationOutPut(&hrtc) != HAL_OK)
  {
    Error_Handler();
  }

}

void HAL_RTC_MspInit(RTC_HandleTypeDef* rtcHandle)
{

  if(rtcHandle->Instance==RTC)
  {
    /* RTC clock enable */
    __HAL_RCC_RTC_ENABLE();
  }
}

void HAL_RTC_MspDeInit(RTC_HandleTypeDef* rtcHandle)
{

  if(rtcHandle->Instance==RTC)
  {
    /* Peripheral clock disable */
    __HAL_RCC_RTC_DISABLE();
  }
} 

/* USER CODE BEGIN 1 */

uint8_t RTC_WeekDayNum(uint32_t nYear, uint8_t nMonth, uint8_t nDay)
{
  uint32_t year = 0, weekday = 0;

  year = 2000 + nYear;

  if(nMonth < 3)
  {
    /*D = { [(23 x month)/9] + day + 4 + year + [(year-1)/4] - [(year-1)/100] + [(year-1)/400] } mod 7*/
    weekday = (((23 * nMonth)/9) + nDay + 4 + year + ((year-1)/4) - ((year-1)/100) + ((year-1)/400)) % 7;
  }
  else
  {
    /*D = { [(23 x month)/9] + day + 4 + year + [year/4] - [year/100] + [year/400] - 2 } mod 7*/
    weekday = (((23 * nMonth)/9) + nDay + 4 + year + (year/4) - (year/100) + (year/400) - 2 ) % 7;
  }

  if (weekday == 0)
	  weekday = RTC_WEEKDAY_SUNDAY;

  return (uint8_t)weekday;
}


void RTC_GetDateTime(uint8_t *dw, uint8_t *dd, uint8_t *mm, uint8_t *yy, uint8_t *h, uint8_t *m, uint8_t *s)
{
	RTC_TimeTypeDef sTime;
	RTC_DateTypeDef sDate;

	HAL_RTC_GetTime(&hrtc, &sTime, RTC_FORMAT_BIN);
	HAL_RTC_GetDate(&hrtc, &sDate, RTC_FORMAT_BIN);

	*dw = RTC_WeekDayNum((uint32_t)sDate.Year, sDate.Month, sDate.Date);
	*dd = sDate.Date;
	*mm = sDate.Month;
	*yy = sDate.Year;
	*h = sTime.Hours;
	*m = sTime.Minutes;
	*s = sTime.Seconds;

}


void RTC_SetDateTime(uint8_t dd, uint8_t mm, uint8_t yy, uint8_t h, uint8_t m, uint8_t s)
{
	RTC_TimeTypeDef sTime;
	RTC_DateTypeDef sDate;

	HAL_RTC_GetTime(&hrtc, &sTime, RTC_FORMAT_BIN);
	HAL_RTC_GetDate(&hrtc, &sDate, RTC_FORMAT_BIN);

	sDate.Date = dd;
	sDate.Month = mm;
	sDate.Year = yy;
	sTime.Hours = h;
	sTime.Minutes = m;
	sTime.Seconds = s;
	sTime.DayLightSaving = RTC_DAYLIGHTSAVING_NONE;
	sTime.StoreOperation = RTC_STOREOPERATION_RESET;

	HAL_RTC_SetDate(&hrtc, &sDate, RTC_FORMAT_BIN);
	HAL_RTC_SetTime(&hrtc, &sTime, RTC_FORMAT_BIN);
}




/* USER CODE END 1 */

/************************ (C) COPYRIGHT STMicroelectronics *****END OF FILE****/
