Antonio-Tirri/Aspirnove/(notices)

Notices in the files:
Aspirnova Scheda Motori S-283-00/Scheda motori Software sorgente S-283-00 FW00055_016/FW00055_016/Inc/main.h:
COPYRIGHT(c) 2019 STMicroelectronics
